sabrinasadiafaria/LoRa-WiFi-Mesh-Infrastructure/Project idea.md

# Project Idea: Self-Healing LoRa Mesh for Search & Rescue

## 🌟 Overview
This project aims to build a robust, self-healing mesh communication system tailored for Search and Rescue (SAR) operations in environments with no cellular coverage. 

By leveraging **LoRa (Long Range) radio** on **ESP32 microcontrollers**, the system can maintain connectivity over long distances. It will integrate **GPS** for real-time tracking of SAR teams and victims, and aggregate all data to a centralized **Command Center**.

## 🏗️ Architecture

### 1. The Nodes (ESP32 + LoRa + GPS + OLED)
* **Microcontroller**: ESP32 provides processing power, WiFi/Bluetooth (if needed locally), and multiple hardware serials.
* **Communication**: LoRa modules (e.g., SX1276/SX1278) enable long-range, low-bandwidth communication.
* **Location**: GPS modules (e.g., Neo-6M) provide real-time location tracking.
* **Display**: OLED screens (SSD1306) provide local feedback to operators (e.g., connection status, coordinates).

### 2. The Mesh Network
* **Self-Healing Topology**: If a node goes offline (due to battery failure or moving out of range), the network automatically reroutes data through other available nodes.
* **Multi-Hop**: Data can jump from Node A to Node C by passing through Node B, effectively extending the total range far beyond a single point-to-point link.

### 3. The Command Center (Gateway + Raspberry Pi)
* **Gateway Node**: An ESP32 connected to the command center's computer/Raspberry Pi acts as the bridge between the LoRa mesh and the local network.
* **Data Processing**: A Raspberry Pi processes incoming telemetry, alerts, and GPS coordinates.
* **Dashboard**: A local web interface visualizes the network topology and plots node locations on an offline map, giving commanders real-time situational awareness.

## 🎯 Key Goals
1. **Reliability**: Ensure message delivery even in harsh environments with dropped packets.
2. **Scalability**: Allow new nodes to seamlessly join the network on the fly.
3. **Low Power**: Optimize battery life for extended rescue operations.
4. **Usability**: Provide a clean, intuitive web interface for non-technical operators.
