sabrinasadiafaria/LoRa-WiFi-Mesh-Infrastructure/phase 8/Node C Forwarding.md

#include <SPI.h>
#include <LoRa.h>
#include <Wire.h>
#include <Adafruit_GFX.h>
#include <Adafruit_SSD1306.h>

#define SCREEN_WIDTH 128
#define SCREEN_HEIGHT 64

Adafruit_SSD1306 display(SCREEN_WIDTH, SCREEN_HEIGHT, &Wire, -1);

// Hardware SPI Pins for Arduino Uno / Nano (ATmega328P)
// Fixed Hardware SPI: SCK = Pin 13, MISO = Pin 12, MOSI = Pin 11
#define LORA_SS    10  // CS Pin
#define LORA_RST   9   // Reset Pin
#define LORA_DIO0  2   // Interrupt Pin

#define LORA_FREQ 433E6

// Node Configuration
const String MY_NODE_ID = "NODE_C";
const int ROUTE_BROADCAST_INTERVAL = 5000;
const int ROUTE_TIMEOUT = 15000;
const int MAX_ROUTES = 5; // Optimized for ATmega328P 2KB RAM
const int MAX_HOPS = 5;

struct RouteEntry {
  String destNode;
  String nextHop;
  int hops;
  int rssi;
  unsigned long lastUpdated;
  bool valid;
};

RouteEntry routingTable[MAX_ROUTES];
int routeCount = 0;
unsigned long lastBroadcastTime = 4000; // Offset start by 4s to avoid collision
unsigned long lastSendTime = 0;
int msgIdCounter = 200;

void updateOrAddRoute(String dest, String nextHop, int hops, int rssi) {
  if (dest == MY_NODE_ID) return;
  unsigned long now = millis();

  for (int i = 0; i < routeCount; i++) {
    if (routingTable[i].destNode == dest) {
      if (nextHop == routingTable[i].nextHop || hops < routingTable[i].hops || !routingTable[i].valid) {
        routingTable[i].nextHop = nextHop;
        routingTable[i].hops = hops;
        routingTable[i].rssi = rssi;
        routingTable[i].lastUpdated = now;
        routingTable[i].valid = true;
      }
      return;
    }
  }

  if (routeCount < MAX_ROUTES) {
    routingTable[routeCount].destNode = dest;
    routingTable[routeCount].nextHop = nextHop;
    routingTable[routeCount].hops = hops;
    routingTable[routeCount].rssi = rssi;
    routingTable[routeCount].lastUpdated = now;
    routingTable[routeCount].valid = true;
    routeCount++;
    Serial.println(F(">>> NEW ROUTE DISCOVERED"));
  }
}

String getNextHop(String dest) {
  for (int i = 0; i < routeCount; i++) {
    if (routingTable[i].destNode == dest && routingTable[i].valid) {
      return routingTable[i].nextHop;
    }
  }
  return "";
}

void updateOLED(String statusLine, String lastRx) {
  display.clearDisplay();
  display.setTextColor(SSD1306_WHITE);
  display.setTextSize(1);

  display.setCursor(0, 0);
  display.println(F("NODE C (Uno/Nano)"));

  display.setCursor(0, 16);
  display.print(F("Status: "));
  display.println(statusLine);

  display.setCursor(0, 32);
  display.print(F("Last RX/Fwd: "));
  display.println(lastRx);

  display.display();
}

void broadcastRoutes() {
  String packetStr = "RT:" + MY_NODE_ID + ":";
  for (int i = 0; i < routeCount; i++) {
    if (routingTable[i].valid && routingTable[i].destNode != MY_NODE_ID) {
      packetStr += routingTable[i].destNode + "," + String(routingTable[i].hops) + ";";
    }
  }
  LoRa.beginPacket();
  LoRa.print(packetStr);
  LoRa.endPacket();
}

void forwardPacket(String src, String dest, int hops, int msgId, String payload) {
  if (hops >= MAX_HOPS) {
    Serial.println(F("Drop: MAX HOPS"));
    return;
  }

  String nextHop = getNextHop(dest);
  if (nextHop == "") {
    Serial.println(F("Drop: No Route"));
    return;
  }

  String fwdPacket = "DATA:" + src + ":" + dest + ":" + String(hops + 1) + ":" + String(msgId) + ":" + payload;

  delay(100);
  LoRa.beginPacket();
  LoRa.print(fwdPacket);
  LoRa.endPacket();

  Serial.println(F(">>> FORWARDED packet"));
  updateOLED("FWD " + src + "->" + dest, "ID#" + String(msgId));
}

void setup() {
  Serial.begin(115200);

  // Hardware I2C on Arduino Uno/Nano: SDA = Pin A4, SCL = Pin A5
  Wire.begin();
  display.begin(SSD1306_SWITCHCAPVCC, 0x3C);

  // Hardware SPI on Arduino Uno/Nano: SCK=13, MISO=12, MOSI=11
  SPI.begin();
  LoRa.setPins(LORA_SS, LORA_RST, LORA_DIO0);

  if (!LoRa.begin(LORA_FREQ)) {
    Serial.println(F("LoRa init failed!"));
    while (1);
  }

  Serial.println(F("Node C - Arduino Uno/Nano Multi-Hop Ready"));
  updateOLED("Ready", "None");
}

void loop() {
  // 1. Receive & Process incoming packets
  int packetSize = LoRa.parsePacket();
  if (packetSize) {
    String incoming = "";
    while (LoRa.available()) {
      incoming += (char)LoRa.read();
    }
    int rssi = LoRa.packetRssi();

    if (incoming.startsWith("RT:")) {
      int firstColon = incoming.indexOf(':');
      int secondColon = incoming.indexOf(':', firstColon + 1);
      if (firstColon != -1 && secondColon != -1) {
        String senderId = incoming.substring(firstColon + 1, secondColon);
        String routesPayload = incoming.substring(secondColon + 1);

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

      if (p5 != -1) {
        String src = incoming.substring(p1 + 1, p2);
        String dest = incoming.substring(p2 + 1, p3);
        int hops = incoming.substring(p3 + 1, p4).toInt();
        int msgId = incoming.substring(p4 + 1, p5).toInt();
        String payload = incoming.substring(p5 + 1);

        if (dest == MY_NODE_ID) {
          Serial.println(F(">>> RECEIVED FINAL DATA!"));
          updateOLED("RX Final", src + ": " + payload);
        } else {
          forwardPacket(src, dest, hops, msgId, payload);
        }
      }
    }
  }

  // 2. Broadcast routes periodically
  if (millis() - lastBroadcastTime > ROUTE_BROADCAST_INTERVAL) {
    broadcastRoutes();
    lastBroadcastTime = millis();
  }
}
