sabrinasadiafaria/LoRa-WiFi-Mesh-Infrastructure/development/phase 9/Node A.md

// ===========================================================================
//  PHASE 9 (FINAL)  -  INTEGRATION BUILD FOR DEMO DAY  -  NODE A
//  ESP32 + LoRa SX1278 (433 MHz) + 1.3" SH1106 OLED + NEO-6M GPS + Wi-Fi portal
//
//  Complete standalone sketch - paste the whole file into the Arduino IDE.
//
//  Libraries: LoRa (Sandeep Mistry), U8g2 (oliver kraus)
//  Board:     ESP32 Dev Module
//
//  This is the same sketch as phase 8, retitled as the canonical
//  demo-day build. Everything that earlier phases added lives in this
//  one file: phase 1 shared core, phase 3 edge-triggered SOS, phase 4
//  portal + rescue reports, phase 5 unified self-healing routing,
//  phase 6 reliability fixes (heap/CRC/loop-time guards), phase 7
//  range + GPS, phase 8 ROVER: relay.
//
//  Earlier phase folders are still there for diffs and rollback; this
//  file is what you flash on demo day.
//
//  WHY THIS PHASE EXISTS - nodes would not link up outdoors, and the GPS
//  looked dead. Two real bugs were behind it:
//
//  1. SPREADING FACTOR WAS TUNED FOR A DESK, NOT A FIELD.
//     SF7 was chosen back in Phase 3 from bench measurements taken with the
//     nodes ~2 m apart (RSSI -62..-71 dBm). SF7 has the WORST sensitivity of
//     the usable settings: -123 dBm. Outdoors at distance that margin is
//     gone. Now SF9 (-129 dBm) - 6 dB better, roughly DOUBLE the range.
//
//  2. THE AIRTIME WAIT WAS A HARDCODED CONSTANT (a latent bug).
//     After endPacket(true) the sketch waited a fixed 420 ms before handing
//     the radio back to parsePacket(). That was sized for SF7, whose biggest
//     frame is ~318 ms. At SF9 a full frame needs ~1005 ms - so the wait
//     would have expired MID-TRANSMISSION and parsePacket() would have
//     yanked the radio out of TX, corrupting every large packet. Airtime is
//     now COMPUTED per frame from its length and LORA_SF (loraAirtimeMs),
//     so the spreading factor can be changed freely without breaking TX.
//
//  3. GPS SERIAL BUFFER TOO SMALL.
//     Serial2's default RX buffer is 256 bytes. A NEO-M8N with several
//     constellations emits more than that per second in bursts; when loop()
//     was briefly busy (an SF9 transmit is ~370 ms) the buffer overran and
//     NMEA sentences arrived truncated - looking exactly like a dead GPS.
//     Now 1 KB, set before Serial2.begin().
//
//  Beacon rates were slowed to pay for SF9's longer airtime (HB 15 s,
//  RT 30 s, GPS 45 s) with timeouts scaled to match, keeping the channel
//  around 18% busy with four nodes.
//
//  ALSO IN THIS PHASE
//    * Redesigned OLED - 5 organised pages, including a LINKS page showing
//      signal strength per peer, which is the page to watch during a range
//      test. Every page is marked n/5.
//    * Redesigned captive portal - modern responsive UI, live peer table with
//      signal bars, position card with source badges, toast notifications,
//      collapsible diagnostics. Polls /api/status every 4 s.
//
//  TUNING FOR YOUR SITE
//    Indoors / short range, want speed:   LORA_SF 7
//    Mixed indoor+outdoor (default):      LORA_SF 9
//    Maximum range, slow:                 LORA_SF 10 or 11
//    Change it in ALL THREE sketches - nodes on different SFs cannot hear
//    each other at all. Airtime and the watchdogs adapt automatically.
//
//  SOS button: momentary switch GPIO 4 to GND. tap = raise (or dismiss a
//  received alert), hold >1.5 s = dismiss.
//
//  Serial:  n r g s  a|b|c  t p  S C  1-4 reports  5-8 status
//           v = toggle rx log   N = raw NMEA dump   R = rescan   h = help
//
//  (phase 8 rover support - relaying ROVER: telemetry - is part of the
//  base forwarding logic now, not an "addition".)
// ===========================================================================

#include <SPI.h>
#include <LoRa.h>
#include <Wire.h>
#include <U8g2lib.h>
#include <WiFi.h>
#include <WebServer.h>
#include <DNSServer.h>
#include <esp_task_wdt.h>
#include <esp_system.h>

U8G2_SH1106_128X64_NONAME_F_HW_I2C display(U8G2_R0, U8X8_PIN_NONE);

// ------------------------------- identity ---------------------------------
#define MY_ID          "A"
#define FW_VERSION      8
#define PROTO_VERSION   1

// --------------------------------- pins -----------------------------------
#define LORA_SCK       18
#define LORA_MISO      19
#define LORA_MOSI      23
#define LORA_SS         5
#define LORA_RST       14
#define LORA_DIO0      26

#define I2C_SDA        21
#define I2C_SCL        22

#define PIN_SOS_BUTTON  4    // external push button to GND (used from Phase 3)
#define PIN_ENTROPY    34    // ADC1, input-only, floats -> good random seed

#define GPS_RX_PIN     16    // ESP32 RX2  <- GPS TX
#define GPS_TX_PIN     17    // ESP32 TX2  -> GPS RX
#define GPS_BAUD     9600

// ------------------------------- LoRa PHY ---------------------------------
// NOTE: the stock LoRa library leaves CRC OFF and uses the public sync word
// 0x12, so any other SX127x nearby collides with us. Both are fixed here.
#define LORA_FREQ      433E6
#define LORA_SF        7        // BACK TO THE KNOWN-GOOD VALUE.
                                // SF7 is what phases 3-6 ran, and those linked up
                                // reliably. Phase 7 raised it to 9 for range and
                                // then 8; both times the mesh got WORSE, so the
                                // spreading factor goes back to the setting with
                                // hardware evidence behind it and stays there until
                                // the mesh is provably stable again.
                                // Raise it ONLY one step at a time, and ONLY after
                                // changing it in all three sketches AND in
                                // pi/sx1278.py - see the RADIO PHY box printed at
                                // boot. Nodes on different spreading factors are
                                // COMPLETELY deaf to each other, which looks
                                // exactly like "nothing connects to anything".
#define LORA_BW        125000L
#define LORA_CR        5
#define LORA_TXPOWER   17
#define LORA_SYNCWORD  0x2A
#define LORA_PREAMBLE  8

// ---------------------------- power / heat --------------------------------
// An ESP32 running a SoftAP continuously at 240 MHz, with a LoRa module, an
// OLED and a GPS hanging off its 3V3 pin, is a small heater - and a hot board
// browns out mid-transmit, which looks exactly like "the nodes keep losing
// each other". Both knobs below cut current with no effect on LoRa range:
//   - 80 MHz is the lowest clock the Wi-Fi stack supports and is still far
//     more CPU than this sketch needs (maxloop stays single-digit ms).
//   - the phone is a metre away; 11 dBm of Wi-Fi is plenty, and the AP is a
//     bigger share of the average current than the LoRa radio ever is.
// LORA_TXPOWER is deliberately NOT reduced - that is the range budget.
#define CPU_MHZ        240             // STOCK. Dropping this to 80 is a real heat
                                       // fix, but change ONE thing at a time: get
                                       // the mesh linking at 240 first, then try 80
                                       // and confirm the links survive.
#define WIFI_TX_DBM     WIFI_POWER_11dBm

// ------------------------------ Wi-Fi portal ------------------------------
#define ENABLE_PORTAL   1              // set 0 to make this a LoRa-only relay
#define AP_SSID        "SOS_Node_A"
#define AP_PASSWORD    NULL            // NULL = open network (captive portal)
#define AP_CHANNEL      1
#define AP_MAX_CLIENTS  4

// ------------------------------ location ----------------------------------
// A phone fix is preferred while it is fresh; the GPS module is the fallback.
// Set LOCATION_PREFER_PHONE to 0 to reverse that.
#define LOCATION_PREFER_PHONE   1
#define GPS_FRESH_MS        30000UL    // module fix counts as "live" this long
#define PHONE_FRESH_MS     300000UL    // phone fix counts as "live" this long

#define LOC_NONE   0
#define LOC_GPS    1
#define LOC_PHONE  2

// -------------------------------- timing ----------------------------------
#define HB_INTERVAL_MS       15000UL   // slower: SF9 packets are ~3x longer on air
#define HB_JITTER_MS          3000UL
#define GPS_INTERVAL_MS      45000UL
#define GPS_JITTER_MS         4000UL
#define RT_INTERVAL_MS       30000UL   // routing advertisement period
#define RT_JITTER_MS          4000UL
#define ROUTE_TIMEOUT_MS    120000UL   // ~4 missed adverts -> route invalid
#define NEIGHBOR_TIMEOUT_MS  75000UL   // ~5 missed heartbeats at the slower rate
#define AUTO_DATA_MS         15000UL   // repeat-send period when t is toggled on
#define OLED_REFRESH_MS       1000UL   // redraw is skipped when nothing changed
#define UI_PAGE_MS            4000UL   // how long each OLED page is shown
// FAST RECONNECT, NOW BOUNDED.  When a known neighbour goes missing we beacon
// faster so we find each other again. Until now that was UNBOUNDED: once a
// node had ever lost a peer it beaconed every 6 s forever. At SF7 that was
// ~2 % of the channel and harmless; at SF9 it is ~5.5 % PER NODE for
// heartbeats alone, and it is self-reinforcing - lose a peer, beacon faster,
// collide more, lose more peers, beacon faster still. Three nodes plus the Pi
// saturate the channel and the mesh can never re-form. That is the bug behind
// "both nodes are lost and cannot reach the Pi". The burst is now limited to
// RECONNECT_WINDOW_MS, after which we fall back to the normal rate - a
// returning node announces itself with bootBeacons anyway.
#define RECONNECT_HB_MS       6000UL   // fast beacon while a neighbour is missing
#define RECONNECT_WINDOW_MS  90000UL   // ...but only for this long after the loss

// DUTY-CYCLE GOVERNOR. A hard ceiling on how much of each minute this node may
// spend transmitting ROUTINE beacons. Steady state at SF8 is ~2 %, so it never
// bites in normal operation - it exists so that no future timing change (or a
// lost-peer storm like the one above) can congest the channel again. SOS,
// DATA, ACK and CMD traffic is NEVER governed.
#define DUTY_WINDOW_MS       60000UL
#define DUTY_BUDGET_PERMIL      100    // 10 % of the window
#define I2C_HZ              100000L   // standard rate - see the I2C section below
#define I2C_TIMEOUT_MS           50   // MUST be set or a glitching OLED can hang loop() forever
#define STAT_LOG_MS          30000UL
#define TX_MIN_GAP_MS          150UL   // the airtime wait above already spaces us out
#define TX_GAP_JITTER_MS       250UL
#define TX_AIRTIME_MARGIN_MS    80UL   // safety added to the COMPUTED airtime
#define RADIO_RETRY_MS        5000UL

// --------------------------------- sizes ----------------------------------
#define MAX_NEIGHBORS      8
#define MAX_ROUTES         8
#define MAX_HOPS           4           // also the initial TTL of a DATA packet

// -------------------------- SOS / reports --------------------------------
#define SOS_BURST_COUNT       3        // an SOS is sent this many times
#define SOS_BURST_GAP_MS   1200UL      // spacing between the copies (non-blocking)
#define SOS_SCREEN_MS     60000UL      // full-screen alert clears itself after this
#define SOS_BUTTON_HOLD_MS 1500UL      // hold the button this long to clear an alert
#define SOS_DEBOUNCE_MS      50UL
#define MAX_PACKET_LEN   200
#define MAX_PAYLOAD_LEN  160
#define SEEN_CACHE_SIZE   32
#define TX_QUEUE_DEPTH     6
#define NMEA_BUF_LEN     100
#define UI_PAGES           5
#define WDT_TIMEOUT_S     30       // transmits are bounded now, so this can be tight again
#define SERIAL_BAUD   115200

// ===========================================================================
//  NON-BLOCKING TIMER  (replaces every delay() in loop)
//
//  The phase 10/11 sketches staggered their first transmit like this:
//      lastBroadcastTime = millis() + random(0, 2000);          // BUG
//      if (millis() - lastBroadcastTime > interval) { ... }
//  Putting the timestamp in the FUTURE makes (millis() - last) underflow to a
//  huge unsigned value on the first pass, so the guard is immediately true and
//  the node transmits at once - the stagger never happened. begin() below gets
//  the same effect correctly, by moving the timestamp into the PAST.
// ===========================================================================
struct Interval {
  uint32_t last;
  uint32_t period;

  void begin(uint32_t periodMs, uint32_t firstDelayMs) {
    period = periodMs;
    uint32_t back = (periodMs > firstDelayMs) ? (periodMs - firstDelayMs) : 0;
    last = millis() - back;               // always the past, never the future
  }
  bool due() {
    uint32_t now = millis();
    if (now - last >= period) { last = now; return true; }
    return false;
  }
  void setPeriod(uint32_t p) { period = p; }
};

Interval hbTimer, gpsTimer, rtTimer, autoTimer;
Interval uiTimer, pageTimer, statTimer, retryTimer;

// ===========================================================================
//  PACKET FRAMING     v<VER>|<TYPE>|<SRC>|<DEST>|<MSGID>|<TTL>|<PAYLOAD>|<CHK>
//
//  All char buffers - no String anywhere in the receive/parse path, so the
//  ESP32 heap stays flat over a long run.
// ===========================================================================
struct Packet {
  uint8_t  ver;
  char     type[8];
  char     src[4];
  char     dest[4];
  uint16_t msgId;
  uint8_t  ttl;
  char     payload[MAX_PAYLOAD_LEN];
  int      rssi;
  float    snr;
};

uint8_t pktChecksum(const char *s, size_t n) {
  uint8_t c = 0;
  for (size_t i = 0; i < n; i++) c ^= (uint8_t)s[i];
  return c;
}

// '|' is the field separator, so it must never appear inside a field.
void pktSanitize(char *s) {
  for (char *p = s; *p; ++p)
    if (*p == '|' || *p == '\\' || *p == '\r' || *p == '\n') *p = '/';
}

// Build a frame. Returns length written, or 0 if it would not fit.
size_t pktBuild(char *out, size_t outSize,
                const char *type, const char *src, const char *dest,
                uint16_t msgId, uint8_t ttl, const char *payload) {
  int n = snprintf(out, outSize, "v%u|%s|%s|%s|%u|%u|%s",
                   (unsigned)PROTO_VERSION, type, src, dest,
                   (unsigned)msgId, (unsigned)ttl, payload ? payload : "");
  if (n < 0 || (size_t)n + 4 > outSize) return 0;
  uint8_t chk = pktChecksum(out, (size_t)n);
  int m = snprintf(out + n, outSize - (size_t)n, "|%02x", chk);
  if (m < 0) return 0;
  return (size_t)(n + m);
}

// Parse a frame IN PLACE. False if malformed, wrong version, or bad checksum.
bool pktParse(char *in, Packet &p) {
  size_t len = strlen(in);
  if (len < 12 || len >= MAX_PACKET_LEN) return false;

  char *lastBar = strrchr(in, '|');
  if (!lastBar) return false;
  if (strlen(lastBar + 1) != 2) return false;

  uint8_t want = (uint8_t)strtoul(lastBar + 1, NULL, 16);
  *lastBar = '\0';
  if (pktChecksum(in, strlen(in)) != want) return false;

  // Split on the first 6 pipes; field 7 keeps the rest, so a stray separator
  // inside a payload cannot shift the other fields.
  char *f[7];
  int nf = 0;
  f[nf++] = in;
  for (char *q = in; *q && nf < 7; ++q) {
    if (*q == '|') { *q = '\0'; f[nf++] = q + 1; }
  }
  if (nf != 7) return false;
  if (f[0][0] != 'v') return false;

  p.ver = (uint8_t)atoi(f[0] + 1);
  if (p.ver != PROTO_VERSION) return false;

  strncpy(p.type, f[1], sizeof(p.type) - 1); p.type[sizeof(p.type) - 1] = '\0';
  strncpy(p.src,  f[2], sizeof(p.src)  - 1); p.src[sizeof(p.src)   - 1] = '\0';
  strncpy(p.dest, f[3], sizeof(p.dest) - 1); p.dest[sizeof(p.dest) - 1] = '\0';
  p.msgId = (uint16_t)strtoul(f[4], NULL, 10);
  p.ttl   = (uint8_t) strtoul(f[5], NULL, 10);
  strncpy(p.payload, f[6], sizeof(p.payload) - 1);
  p.payload[sizeof(p.payload) - 1] = '\0';

  if (!p.type[0] || !p.src[0] || !p.dest[0]) return false;
  return true;
}

// ===========================================================================
//  DUPLICATE SUPPRESSION
// ===========================================================================
uint32_t seenKeys[SEEN_CACHE_SIZE];
uint8_t  seenIdx = 0;

uint32_t seenKey(const char *src, uint16_t msgId) {
  uint32_t h = 2166136261UL;                       // FNV-1a over the node id
  for (const char *p = src; *p; ++p) { h ^= (uint8_t)*p; h *= 16777619UL; }
  uint32_t k = (h << 16) ^ msgId;
  return k ? k : 1;
}

bool seenOrAdd(const char *src, uint16_t msgId) {
  uint32_t k = seenKey(src, msgId);
  for (uint8_t i = 0; i < SEEN_CACHE_SIZE; i++) if (seenKeys[i] == k) return true;
  seenKeys[seenIdx] = k;
  seenIdx = (uint8_t)((seenIdx + 1) % SEEN_CACHE_SIZE);
  return false;
}

// ===========================================================================
//  NEIGHBOUR TABLE   (now also stores each peer's reported position)
// ===========================================================================
struct Neighbor {
  char     id[4];
  int      rssi;
  float    snr;
  uint32_t lastSeen;
  uint32_t uptime;
  uint32_t heap;
  double   lat, lon;
  uint8_t  locSrc;      // LOC_NONE / LOC_GPS / LOC_PHONE
  bool     hasLoc;
  bool     used;
  bool     active;
};

Neighbor neighbors[MAX_NEIGHBORS];

#define NB_UPDATED      0
#define NB_NEW          1
#define NB_RECONNECTED  2
#define NB_FULL        -1

void neighborInit() {
  for (uint8_t i = 0; i < MAX_NEIGHBORS; i++) {
    neighbors[i].used = false;
    neighbors[i].active = false;
    neighbors[i].hasLoc = false;
    neighbors[i].locSrc = LOC_NONE;
    neighbors[i].id[0] = '\0';
  }
}

int neighborIndex(const char *id) {
  for (uint8_t i = 0; i < MAX_NEIGHBORS; i++)
    if (neighbors[i].used && strcmp(neighbors[i].id, id) == 0) return (int)i;
  return -1;
}

// Any packet from a peer proves it is alive. Returns NB_NEW / NB_RECONNECTED /
// NB_UPDATED / NB_FULL.
int neighborSeen(const char *id, int rssi, float snr) {
  if (!id || !*id) return NB_UPDATED;
  uint32_t now = millis();

  int i = neighborIndex(id);
  if (i >= 0) {
    bool wasActive = neighbors[i].active;
    neighbors[i].rssi = rssi;
    neighbors[i].snr  = snr;
    neighbors[i].lastSeen = now;
    neighbors[i].active = true;
    return wasActive ? NB_UPDATED : NB_RECONNECTED;
  }
  for (uint8_t k = 0; k < MAX_NEIGHBORS; k++) {
    if (!neighbors[k].used) {
      strncpy(neighbors[k].id, id, sizeof(neighbors[k].id) - 1);
      neighbors[k].id[sizeof(neighbors[k].id) - 1] = '\0';
      neighbors[k].rssi = rssi;
      neighbors[k].snr  = snr;
      neighbors[k].lastSeen = now;
      neighbors[k].uptime = 0;
      neighbors[k].heap = 0;
      neighbors[k].hasLoc = false;
      neighbors[k].locSrc = LOC_NONE;
      neighbors[k].used = true;
      neighbors[k].active = true;
      return NB_NEW;
    }
  }
  return NB_FULL;
}

void neighborSetStats(const char *id, uint32_t uptime, uint32_t heap) {
  int i = neighborIndex(id);
  if (i < 0) return;
  neighbors[i].uptime = uptime;
  neighbors[i].heap = heap;
}

void neighborSetLoc(const char *id, double lat, double lon, uint8_t src) {
  int i = neighborIndex(id);
  if (i < 0) return;
  neighbors[i].lat = lat;
  neighbors[i].lon = lon;
  neighbors[i].locSrc = src;
  neighbors[i].hasLoc = (src != LOC_NONE);
}

// Marks ONE stale neighbour inactive per call. Drain it with a while() loop.
bool neighborPrune(char *lostId, size_t n) {
  uint32_t now = millis();
  for (uint8_t i = 0; i < MAX_NEIGHBORS; i++) {
    if (neighbors[i].used && neighbors[i].active &&
        (now - neighbors[i].lastSeen > NEIGHBOR_TIMEOUT_MS)) {
      neighbors[i].active = false;
      if (lostId && n) {
        strncpy(lostId, neighbors[i].id, n - 1);
        lostId[n - 1] = '\0';
      }
      return true;
    }
  }
  return false;
}

uint8_t neighborActiveCount() {
  uint8_t c = 0;
  for (uint8_t i = 0; i < MAX_NEIGHBORS; i++)
    if (neighbors[i].used && neighbors[i].active) c++;
  return c;
}

// Comma separated list of active neighbours, e.g. "B,C" - or "none".
void neighborActiveList(char *out, size_t n) {
  if (!out || n == 0) return;
  out[0] = '\0';
  size_t used = 0;
  for (uint8_t i = 0; i < MAX_NEIGHBORS; i++) {
    if (!neighbors[i].used || !neighbors[i].active) continue;
    size_t idLen = strlen(neighbors[i].id);
    if (used + idLen + (used ? 1 : 0) + 1 >= n) break;
    if (used) out[used++] = ',';
    memcpy(out + used, neighbors[i].id, idLen);
    used += idLen;
    out[used] = '\0';
  }
  if (used == 0) { strncpy(out, "none", n - 1); out[n - 1] = '\0'; }
}

// Is any node we have met since boot currently missing?  While that is true
// we beacon faster (RECONNECT_HB_MS) so the missing node - and we - are
// rediscovered in seconds rather than on the next slow heartbeat.
bool anyNeighborMissing() {
  for (uint8_t i = 0; i < MAX_NEIGHBORS; i++)
    if (neighbors[i].used && !neighbors[i].active) return true;
  return false;
}

// Drop every cached (src,msgId) belonging to one node. Called when a node
// comes back, because a node that rebooted restarts its msgId at 1 and would
// otherwise collide with its own pre-reboot ids still sitting in the ring.
void seenForget(const char *src) {
  for (uint8_t i = 0; i < SEEN_CACHE_SIZE; i++) {
    if (!seenKeys[i]) continue;
    for (uint16_t m = 1; m <= 128; m++) {
      if (seenKeys[i] == seenKey(src, m)) { seenKeys[i] = 0; break; }
    }
  }
}

// ===========================================================================
//  ROUTING TABLE  -  distance vector with split horizon
//
//  Each node keeps ONE entry per destination: who to hand the packet to
//  (nextHop) and how many hops away it is. Entries are learned two ways:
//
//    1. any packet heard directly from X  ->  X is reachable in 1 hop via X
//    2. an RT advertisement from S saying "I can reach D in h hops via V"
//       ->  D is reachable in h+1 hops via S
//
//  SPLIT HORIZON is the reason the advert carries V (the advertiser's own
//  next hop). If V is us, that route only exists because of us, and taking
//  it back would create a loop whose hop count climbs forever - the classic
//  count-to-infinity. The old phase 7-9 code claimed split horizon in its
//  comments but never actually implemented it; it only bounded the damage
//  with MAX_HOPS and a timeout. Here the entry is genuinely discarded.
//
//  A route that stops being advertised goes invalid after ROUTE_TIMEOUT_MS.
//  That is the self-healing trigger: traffic through a dead relay stops
//  immediately rather than disappearing into a black hole, and the route
//  recovers by itself when the relay comes back.
// ===========================================================================
struct Route {
  char     dest[4];
  char     nextHop[4];
  uint8_t  hops;
  int      rssi;
  uint32_t lastUpdated;
  bool     used;
  bool     valid;
};

Route routes[MAX_ROUTES];

#define RT_NONE       0
#define RT_NEW        1
#define RT_RECOVERED  2
#define RT_BETTER     3
#define RT_FULL      -1

void routeInit() {
  for (uint8_t i = 0; i < MAX_ROUTES; i++) {
    routes[i].used = false;
    routes[i].valid = false;
    routes[i].dest[0] = '\0';
    routes[i].nextHop[0] = '\0';
  }
}

int routeIndex(const char *dest) {
  for (uint8_t i = 0; i < MAX_ROUTES; i++)
    if (routes[i].used && strcmp(routes[i].dest, dest) == 0) return (int)i;
  return -1;
}

// Accept an advertised path. Returns RT_NEW / RT_RECOVERED / RT_BETTER /
// RT_NONE / RT_FULL so the caller can log the interesting transitions.
int routeUpdate(const char *dest, const char *via, uint8_t hops, int rssi) {
  if (!dest || !*dest || !via || !*via) return RT_NONE;
  if (strcmp(dest, MY_ID) == 0) return RT_NONE;      // never route to self
  if (hops == 0 || hops > MAX_HOPS) return RT_NONE;  // bounds count-to-infinity

  uint32_t now = millis();
  int i = routeIndex(dest);

  if (i >= 0) {
    bool wasValid = routes[i].valid;
    bool sameHop  = (strcmp(routes[i].nextHop, via) == 0);

    // Take the update if it comes from the hop we already use (so a path is
    // allowed to legitimately get longer), or if it is strictly shorter, or
    // if we had given up on this destination entirely.
    if (sameHop || hops < routes[i].hops || !wasValid) {
      strncpy(routes[i].nextHop, via, sizeof(routes[i].nextHop) - 1);
      routes[i].nextHop[sizeof(routes[i].nextHop) - 1] = '\0';
      routes[i].hops = hops;
      routes[i].rssi = rssi;
      routes[i].lastUpdated = now;
      routes[i].valid = true;
      if (!wasValid) return RT_RECOVERED;
      if (!sameHop)  return RT_BETTER;
    }
    return RT_NONE;
  }

  for (uint8_t k = 0; k < MAX_ROUTES; k++) {
    if (!routes[k].used) {
      strncpy(routes[k].dest, dest, sizeof(routes[k].dest) - 1);
      routes[k].dest[sizeof(routes[k].dest) - 1] = '\0';
      strncpy(routes[k].nextHop, via, sizeof(routes[k].nextHop) - 1);
      routes[k].nextHop[sizeof(routes[k].nextHop) - 1] = '\0';
      routes[k].hops = hops;
      routes[k].rssi = rssi;
      routes[k].lastUpdated = now;
      routes[k].used = true;
      routes[k].valid = true;
      return RT_NEW;
    }
  }
  return RT_FULL;
}

// Invalidates ONE stale route per call and reports it. Drain with a while().
bool routeExpire(char *lostDest, size_t n) {
  uint32_t now = millis();
  for (uint8_t i = 0; i < MAX_ROUTES; i++) {
    if (routes[i].used && routes[i].valid &&
        (now - routes[i].lastUpdated > ROUTE_TIMEOUT_MS)) {
      routes[i].valid = false;
      if (lostDest && n) {
        strncpy(lostDest, routes[i].dest, n - 1);
        lostDest[n - 1] = '\0';
      }
      return true;
    }
  }
  return false;
}

// Who do we hand a packet for `dest` to? NULL means we have no way there.
const char *routeBestHop(const char *dest) {
  int i = routeIndex(dest);
  if (i < 0 || !routes[i].valid) return NULL;
  return routes[i].nextHop;
}

uint8_t routeValidCount() {
  uint8_t c = 0;
  for (uint8_t i = 0; i < MAX_ROUTES; i++)
    if (routes[i].used && routes[i].valid) c++;
  return c;
}

// Split one advertised "dest,hops,via" triple.
bool routeParseEntry(char *tok, char *d, size_t dn, unsigned *h, char *v, size_t vn) {
  char *c1 = strchr(tok, ',');
  if (!c1) return false;
  *c1 = '\0';
  char *c2 = strchr(c1 + 1, ',');
  if (!c2) return false;
  *c2 = '\0';
  strncpy(d, tok, dn - 1);      d[dn - 1] = '\0';
  strncpy(v, c2 + 1, vn - 1);   v[vn - 1] = '\0';
  *h = (unsigned)strtoul(c1 + 1, NULL, 10);
  return d[0] && v[0];
}

// ===========================================================================
//  RADIO LAYER
//  All transmits go through one queue with a minimum gap + jitter, so a burst
//  never blocks the loop or stomps on itself.
// ===========================================================================
bool     radioOk = false;
char     txQueue[TX_QUEUE_DEPTH][MAX_PACKET_LEN];
uint8_t  txHead = 0, txTail = 0, txCount = 0;
uint32_t txLast = 0;
uint32_t txGap  = TX_MIN_GAP_MS;
bool     txInFlight = false;      // a transmission is on air right now
uint32_t txStart = 0;             // when it started, for the timeout
uint32_t txAirtimeMs = 500;       // computed per frame by loraAirtimeMs()
uint16_t msgIdCounter = 0;

uint32_t statTx = 0, statRx = 0, statBad = 0, statDrop = 0;
uint32_t statWedge = 0;       // number of times the radio was force-reinitialised
uint32_t statFwd = 0, statDataTx = 0, statDataRx = 0;
uint32_t statTxStuck = 0;         // transmits that never reported TX_DONE

// last application message delivered to this node (shown on the OLED/portal)
char     lastMsgFrom[4] = "";
char     lastMsgText[40] = "";
uint32_t lastMsgTime = 0;

// repeat-send test state, driven by the a/b/c and t serial commands
bool     autoData = false;
char     autoTarget[4] = "";
uint8_t  uiPage = 0;

// A node that has just booted sends a few quick heartbeats so its peers
// rediscover it in seconds instead of waiting a whole HB_INTERVAL_MS.
uint8_t  bootBeacons = 4;

// When the first still-missing neighbour went missing (0 = everyone is here).
// Bounds the fast-reconnect beacon burst - see RECONNECT_WINDOW_MS.
uint32_t missingSinceMs = 0;

// RADIO HEALTH WATCHDOG.
// radioOk is set true once at boot and NEVER set false again at runtime, so
// if the SX1278 wedges internally - a state only a real hardware reset
// clears - nothing in software ever notices, and it stays "connected but
// silent" forever. The one signal that cannot lie: OUR OWN heartbeat is
// generated every HB_INTERVAL_MS regardless of whether anyone is nearby, so
// if it has not gone out in a long time the local radio - not the RF link -
// is broken. lastTxOkMs tracks the last successful transmit; if it goes
// stale, radioWatchdog() forces the same reinit a power cycle would do.
#define RADIO_WEDGE_MS      120000UL   // ~8 missed heartbeats at the slower rate
uint32_t lastTxOkMs = 0;

// Loop-time instrumentation. The radio only listens while parsePacket() has
// it armed, so a long loop pass = a deaf radio. maxloop on the stat line is
// the number to watch: if it climbs into the tens of ms, packets are lost.
uint32_t maxLoopMs = 0;
uint32_t loopStartMs = 0;

// Per-packet [rx] logging is ~10ms of blocked Serial each. Off by default;
// press v to toggle when you actually need the trace.
bool     verboseRx = false;

// RADIO TEST MODE (serial 'T'). Sends a plain non-protocol PING every 3 s.
// The receiver cannot parse it, so it lands in the [rx-raw] log above with its
// RSSI. That is the decisive test: if the other node prints [rx-raw] PING the
// radios hear each other and the fault is in the mesh logic; if it prints
// nothing at all, the PHY does not match or a radio/antenna is dead.
bool     radioTest = false;
uint32_t testLast  = 0;

// ===========================================================================
//  SOS / RESCUE-REPORT / TEAM-STATUS STATE  (Phase 4)
//
//  Fixes carried over from the audit of the old phase 11 SOS code:
//    * that code set sosAlertActive = true and NEVER cleared it, so the OLED
//      was stuck on the SOS screen forever. Here the screen clears itself
//      after SOS_SCREEN_MS, or immediately if the button is held.
//    * that code sent hardcoded coordinates. Here the SOS carries the node's
//      real position from locBest() - phone fix or GPS module, whichever the
//      hybrid location layer has.
//    * that code blocked ~1.5 s inside the 3x burst with delay(500). Here the
//      three copies are queued one SOS_BURST_GAP_MS apart with no blocking.
//    * that code re-fired continuously while the button was held. Here the
//      trigger is edge-detected.
// ===========================================================================

// ---- our own outgoing SOS -------------------------------------------------
bool     sosSending    = false;      // a burst is in progress
uint8_t  sosBurstLeft  = 0;          // copies still to queue
uint16_t sosBurstId    = 0;          // shared msgId for all copies of one SOS
char     sosBurstMsg[48] = "";
Interval sosBurstTimer;

// ---- alert currently shown on this node (ours or a received one) ---------
bool     sosAlert      = false;      // full-screen takeover active
char     sosVictim[4]  = "";
double   sosLat = 0, sosLon = 0;
char     sosText[48]   = "";
uint32_t sosAlertStart = 0;
char     sosAcks[16]   = "";         // comma list of nodes that ACKed our SOS

// ---- SOS button, edge detected -----------------------------------------
bool     btnPrev       = true;       // INPUT_PULLUP idles HIGH
uint32_t btnChangeTime = 0;
bool     btnHeldHandled = false;

// ---- last rescue report / team status heard from each node -------------
struct PeerReport {
  char     id[4];
  char     code[14];       // VICTIM_FOUND / MEDICAL / BLOCKED / DANGER
  char     status[14];     // AVAILABLE / SEARCHING / VICTIM_FOUND / NEED_ASSIST / EMERGENCY
  uint32_t reportTime;
  uint32_t statusTime;
  bool     used;
};
PeerReport peerRep[MAX_NEIGHBORS + 1];   // + 1 for our own row

// our own report / status, editable from the portal or serial
char myStatus[14] = "AVAILABLE";
char myTeam[8]    = "T1";

int peerRepIndex(const char *id) {
  for (uint8_t i = 0; i < MAX_NEIGHBORS + 1; i++)
    if (peerRep[i].used && strcmp(peerRep[i].id, id) == 0) return (int)i;
  for (uint8_t i = 0; i < MAX_NEIGHBORS + 1; i++)
    if (!peerRep[i].used) {
      strncpy(peerRep[i].id, id, sizeof(peerRep[i].id) - 1);
      peerRep[i].id[sizeof(peerRep[i].id) - 1] = '\0';
      peerRep[i].code[0] = '\0';
      peerRep[i].status[0] = '\0';
      peerRep[i].used = true;
      return (int)i;
    }
  return -1;
}

uint16_t nextMsgId() {
  if (++msgIdCounter == 0) msgIdCounter = 1;
  return msgIdCounter;
}

bool radioBegin() {
  SPI.begin(LORA_SCK, LORA_MISO, LORA_MOSI, LORA_SS);
  LoRa.setPins(LORA_SS, LORA_RST, LORA_DIO0);

  for (uint8_t attempt = 0; attempt < 3; attempt++) {
    if (LoRa.begin(LORA_FREQ)) {
      LoRa.setSpreadingFactor(LORA_SF);
      LoRa.setSignalBandwidth(LORA_BW);
      LoRa.setCodingRate4(LORA_CR);
      LoRa.setTxPower(LORA_TXPOWER);
      LoRa.setSyncWord(LORA_SYNCWORD);
      LoRa.setPreambleLength(LORA_PREAMBLE);
      LoRa.enableCrc();
      // no LoRa.receive() - parsePacket() arms RX (see radioService comment)
      radioOk = true;
      return true;
    }
    delay(200);                       // setup only - never inside loop()
  }
  radioOk = false;
  return false;
}

// How long will a frame of `len` bytes actually be on the air, in ms?
//
// This REPLACES the old fixed TX_AIRTIME_MS constant, which was a latent bug:
// it was tuned to 420 ms for SF7 (max frame ~318 ms). At SF9 the same frame
// takes ~1005 ms, so the fixed wait would have expired mid-transmission and
// parsePacket() would have yanked the radio out of TX - corrupting every
// large packet. Now the wait follows LORA_SF automatically, so the spreading
// factor can be changed for range without silently breaking transmission.
//
// Standard Semtech SX1276/78 time-on-air formula.
uint32_t loraAirtimeMs(uint16_t len) {
  const double tSym = (double)(1UL << LORA_SF) * 1000.0 / (double)LORA_BW;
  const uint8_t DE  = (tSym > 16.0) ? 1 : 0;   // low-data-rate optimise
  const uint8_t CR  = LORA_CR - 4;             // 1..4
  double tPre = ((double)LORA_PREAMBLE + 4.25) * tSym;

  long num = 8L * (long)len - 4L * LORA_SF + 28 + 16;   // explicit header -> no -20H
  long den = 4L * (LORA_SF - 2 * DE);
  long nPay = 8;
  if (num > 0) nPay += ((num + den - 1) / den) * (CR + 4);

  return (uint32_t)(tPre + (double)nPay * tSym + 0.5);
}

// ---------------------------------------------------------------------------
// DUTY-CYCLE GOVERNOR
// A rolling window of how many ms of airtime we have actually used.
// radioService() adds each completed transmission; the routine beacon senders
// ask permission before queueing. Returns false when this frame would push us
// over budget. Placed here because it needs loraAirtimeMs() above.
uint32_t dutyUsedMs   = 0;
uint32_t dutyWinStart = 0;
uint32_t statDuty     = 0;          // beacons skipped because the channel was busy

bool dutyAllows(uint16_t len) {
  uint32_t now = millis();
  if (now - dutyWinStart >= DUTY_WINDOW_MS) { dutyWinStart = now; dutyUsedMs = 0; }
  const uint32_t budgetMs = (DUTY_WINDOW_MS / 1000UL) * (uint32_t)DUTY_BUDGET_PERMIL;
  if (dutyUsedMs + loraAirtimeMs(len) <= budgetMs) return true;

  statDuty++;
  static uint32_t lastMoan = 0;     // one line per 30 s, not one per skip
  if (now - lastMoan > 30000UL) {
    lastMoan = now;
    Serial.printf("[duty] channel busy - %lu of %lu ms used this minute, "
                  "%lu beacons skipped so far\n",
                  (unsigned long)dutyUsedMs, (unsigned long)budgetMs,
                  (unsigned long)statDuty);
  }
  return false;
}

// Called every loop. If our own heartbeat has not gone out in RADIO_WEDGE_MS,
// force the exact reinit sequence radioBegin() does at boot - the same thing
// a power cycle achieves, without the power cycle.
void radioWatchdog() {
  if (!radioOk) return;                          // the boot-failure retry path handles this
  if (millis() - lastTxOkMs < RADIO_WEDGE_MS) return;

  statWedge++;
  Serial.printf("[radio] WEDGED - no successful TX in %lus, forcing reinit (#%lu)\n",
                (unsigned long)(RADIO_WEDGE_MS / 1000UL), (unsigned long)statWedge);
  radioOk = false;
  if (radioBegin()) {
    Serial.println("[radio] reinit OK");
    bootBeacons = 4;              // announce ourselves fast, like a real reboot would
    hbTimer.begin(3000UL, 0);
  } else {
    Serial.println("[radio] reinit FAILED - will keep retrying");
  }
  lastTxOkMs = millis();          // don't re-trigger before the reinit has a chance to prove itself
}

// Manual "search for nearby nodes" - the portal button and serial 'R' both
// call this. It does what the automatic watchdog does (reinit the radio, in
// case it is quietly wedged) PLUS announces us immediately instead of
// waiting for the next heartbeat, so a genuine "is anyone out there" check
// gets an answer in seconds rather than up to HB_INTERVAL_MS.
void manualRescan(const char *why) {
  Serial.printf("[radio] manual rescan requested (%s) - reinit + fast beacon\n", why);
  radioOk = false;
  radioBegin();
  bootBeacons = 4;
  hbTimer.begin(1000UL, 0);       // first beacon in ~1s, not the usual jittered wait
  rtTimer.begin(2000UL, 0);
  lastTxOkMs = millis();
}

bool radioEnqueue(const char *frame) {
  if (!frame || !*frame) return false;
  if (txCount >= TX_QUEUE_DEPTH) { statDrop++; return false; }
  strncpy(txQueue[txTail], frame, MAX_PACKET_LEN - 1);
  txQueue[txTail][MAX_PACKET_LEN - 1] = '\0';
  txTail = (uint8_t)((txTail + 1) % TX_QUEUE_DEPTH);
  txCount++;
  return true;
}

// Transmit is ASYNCHRONOUS and bounded, and RX mode is left to parsePacket().
//
// The half-duplex SX1278 has ONE state machine. The Sandeep Mistry library
// gives you two ways to run it and THEY MUST NOT BE MIXED:
//
//   A) poll parsePacket() forever   - parsePacket() re-arms RX_SINGLE itself
//   B) LoRa.receive() + onReceive()  - interrupt driven, RX_CONTINUOUS
//
// Earlier builds did both: LoRa.receive() after every transmit AND
// parsePacket() in the RX path. parsePacket() with no size argument, when it
// finds nothing, forces the radio to RX_SINGLE - so it kept yanking the radio
// out of the RX_CONTINUOUS that receive() had set, and after an async TX left
// a stale TX_DONE flag in the mix the radio would settle in STANDBY and go
// permanently deaf. That is the "SOS works but then every node loses every
// neighbour" bug.
//
// Fix: this sketch is model (A) only. We NEVER call LoRa.receive(). After
// endPacket(true) we wait exactly as long as THIS frame needs on the air -
// loraAirtimeMs() computes it from the length and LORA_SF - and then hand the
// radio back to parsePacket(), which re-arms RX on its next call.
void radioService() {
  // ---- finish an in-flight transmission -----------------------------------
  if (txInFlight) {
    if (millis() - txStart < txAirtimeMs) return;     // still on air
    txInFlight = false;                 // parsePacket() re-arms RX next loop
    statTx++;
    lastTxOkMs = millis();              // proof the local radio still works
    dutyUsedMs += txAirtimeMs;          // charge it to this minute budget
    txLast = millis();
    txGap  = TX_MIN_GAP_MS + (uint32_t)random(0, TX_GAP_JITTER_MS);
    return;
  }

  // ---- start the next queued transmission ---------------------------------
  if (!radioOk || txCount == 0) return;
  if (millis() - txLast < txGap) return;

  // beginPacket() returns 0 if the radio still thinks it is transmitting.
  // Leave the frame queued and try again very soon.
  if (LoRa.beginPacket() == 0) {
    statTxStuck++;
    txLast = millis() - txGap + 40;
    return;
  }

  uint16_t len = (uint16_t)strlen(txQueue[txHead]);
  LoRa.print(txQueue[txHead]);
  LoRa.endPacket(true);                 // async - returns straight away
  txInFlight  = true;
  txStart     = millis();
  // Wait for THIS frame's real on-air time, not a fixed guess. At SF9 a full
  // frame needs ~1005 ms; the old fixed 420 ms would have cut it off.
  txAirtimeMs = loraAirtimeMs(len) + TX_AIRTIME_MARGIN_MS;

  txHead = (uint8_t)((txHead + 1) % TX_QUEUE_DEPTH);
  txCount--;
}

bool radioPoll(Packet &out) {
  if (!radioOk) return false;
  if (txInFlight) return false;       // half duplex - not while we transmit
  int sz = LoRa.parsePacket();
  if (sz <= 0) return false;

  char buf[MAX_PACKET_LEN];
  int n = 0;
  while (LoRa.available() && n < (int)sizeof(buf) - 1) buf[n++] = (char)LoRa.read();
  buf[n] = '\0';
  while (LoRa.available()) LoRa.read();          // discard overflow

  int   rssi = LoRa.packetRssi();
  float snr  = LoRa.packetSnr();

  if (!pktParse(buf, out)) {
    // A frame got here with a VALID hardware CRC, so the PHY matches and the
    // RF link is fine - only the format did not. Printing it separates "the
    // radios cannot hear each other" from "they can hear each other but
    // disagree about the protocol", which is otherwise invisible.
    statBad++;
    Serial.printf("[rx-raw] unparsed  rssi=%d snr=%.1f len=%d  \"%.60s\"\n",
                  rssi, (double)snr, n, buf);
    return false;
  }
  out.rssi = rssi;
  out.snr  = snr;
  statRx++;
  return true;
}

// ===========================================================================
//  GPS MODULE  -  non-blocking NMEA reader
//
//  The old phase 10 code used Serial2.readStringUntil('\n'), which BLOCKS for
//  up to 1000 ms whenever the GPS is unplugged or silent - stalling the whole
//  loop and dropping LoRa packets. This assembles lines character by character
//  and never waits.
// ===========================================================================
char     nmeaBuf[NMEA_BUF_LEN];
uint8_t  nmeaLen = 0;

double   gpsLat = 0.0, gpsLon = 0.0;
bool     gpsHasFix = false;
uint32_t gpsFixTime = 0;        // millis() of the last valid fix (0 = never)
int      gpsSats = 0;
uint32_t gpsSentences = 0;      // NMEA lines seen - proves the module is wired

// Copy field `idx` (comma separated) out of an NMEA sentence.
bool nmeaField(const char *s, int idx, char *out, size_t outN) {
  int field = 0;
  const char *p = s;
  const char *start = s;
  while (1) {
    if (*p == ',' || *p == '*' || *p == '\0') {
      if (field == idx) {
        size_t len = (size_t)(p - start);
        if (len >= outN) len = outN - 1;
        memcpy(out, start, len);
        out[len] = '\0';
        return true;
      }
      if (*p == '*' || *p == '\0') return false;
      field++;
      start = p + 1;
    }
    p++;
  }
}

// NMEA gives ddmm.mmmm / dddmm.mmmm - always exactly 2 digits of whole minutes
// before the decimal point.
double nmeaCoord(const char *val, const char *dir) {
  size_t vl = strlen(val);
  if (vl < 4) return 0.0;
  const char *dot = strchr(val, '.');
  if (!dot) return 0.0;
  int degLen = (int)(dot - val) - 2;
  if (degLen <= 0 || degLen > 3) return 0.0;

  char degBuf[8];
  memcpy(degBuf, val, (size_t)degLen);
  degBuf[degLen] = '\0';

  double deg = atof(degBuf);
  double mins = atof(val + degLen);
  double d = deg + mins / 60.0;
  if (dir[0] == 'S' || dir[0] == 'W') d = -d;
  return d;
}

void nmeaParse(const char *line) {
  size_t len = strlen(line);
  if (len < 7 || line[0] != '$') return;
  gpsSentences++;

  // $GPRMC / $GNRMC  - position and validity
  if (strncmp(line + 3, "RMC", 3) == 0) {
    char status[4];
    if (!nmeaField(line, 2, status, sizeof(status))) return;
    if (status[0] != 'A') { gpsHasFix = false; return; }   // 'V' = not valid

    char la[16], ns[4], lo[16], ew[4];
    if (!nmeaField(line, 3, la, sizeof(la))) return;
    if (!nmeaField(line, 4, ns, sizeof(ns))) return;
    if (!nmeaField(line, 5, lo, sizeof(lo))) return;
    if (!nmeaField(line, 6, ew, sizeof(ew))) return;
    if (!la[0] || !lo[0] || !ns[0] || !ew[0]) return;

    // Validity comes from the 'A' status flag above, NOT from comparing the
    // coordinates against 0.0 - the old code did that and would have thrown
    // away a genuine fix on the equator or the prime meridian.
    gpsLat = nmeaCoord(la, ns);
    gpsLon = nmeaCoord(lo, ew);
    gpsHasFix = true;
    gpsFixTime = millis();
  }
  // $GPGGA / $GNGGA  - satellites in use
  else if (strncmp(line + 3, "GGA", 3) == 0) {
    char sats[8];
    if (nmeaField(line, 7, sats, sizeof(sats)) && sats[0]) gpsSats = atoi(sats);
  }
}

void gpsService() {
  while (Serial2.available()) {
    char c = (char)Serial2.read();
    if (c == '\n' || c == '\r') {
      if (nmeaLen > 6) { nmeaBuf[nmeaLen] = '\0'; nmeaParse(nmeaBuf); }
      nmeaLen = 0;
    } else if (nmeaLen < NMEA_BUF_LEN - 1) {
      nmeaBuf[nmeaLen++] = c;
    } else {
      nmeaLen = 0;                    // overlong sentence - discard
    }
  }
}

// ===========================================================================
//  HYBRID LOCATION MANAGER
//
//  Two independent sources:
//     LOC_PHONE  a position handed to us by a phone through the captive portal
//     LOC_GPS    a live fix from the NEO-6M / NEO-M8N module
//
//  The GPS module cannot get a fix indoors, under debris or beneath a roof -
//  exactly where a rescue node is most likely to be - so a fresh phone fix is
//  preferred and the module is the fallback. Flip LOCATION_PREFER_PHONE to
//  reverse that. If neither is fresh, the most recent of the two is used and
//  reported with its age so nobody mistakes it for live.
// ===========================================================================
double   phoneLat = 0.0, phoneLon = 0.0;
bool     phoneValid = false;
uint32_t phoneTime = 0;
float    phoneAcc = 0.0;
uint32_t phoneUpdates = 0;

// Returns LOC_NONE / LOC_GPS / LOC_PHONE and fills lat/lon/ageMs.
uint8_t locBest(double &lat, double &lon, uint32_t &ageMs) {
  uint32_t now = millis();
  bool gFresh = gpsHasFix  && gpsFixTime && (now - gpsFixTime < GPS_FRESH_MS);
  bool pFresh = phoneValid && phoneTime  && (now - phoneTime  < PHONE_FRESH_MS);

#if LOCATION_PREFER_PHONE
  if (pFresh) { lat = phoneLat; lon = phoneLon; ageMs = now - phoneTime;  return LOC_PHONE; }
  if (gFresh) { lat = gpsLat;   lon = gpsLon;   ageMs = now - gpsFixTime; return LOC_GPS;   }
#else
  if (gFresh) { lat = gpsLat;   lon = gpsLon;   ageMs = now - gpsFixTime; return LOC_GPS;   }
  if (pFresh) { lat = phoneLat; lon = phoneLon; ageMs = now - phoneTime;  return LOC_PHONE; }
#endif

  // Neither is fresh - fall back to whichever we heard most recently.
  if (gpsFixTime || phoneTime) {
    if (gpsFixTime >= phoneTime && gpsFixTime) {
      lat = gpsLat; lon = gpsLon; ageMs = now - gpsFixTime; return LOC_GPS;
    }
    if (phoneTime) {
      lat = phoneLat; lon = phoneLon; ageMs = now - phoneTime; return LOC_PHONE;
    }
  }
  lat = 0.0; lon = 0.0; ageMs = 0;
  return LOC_NONE;
}

const char *locSrcName(uint8_t src) {
  if (src == LOC_GPS)   return "GPS";
  if (src == LOC_PHONE) return "PHONE";
  return "NONE";
}

// Reject obviously bad input from the portal.
bool locValid(double lat, double lon) {
  if (lat < -90.0 || lat > 90.0)   return false;
  if (lon < -180.0 || lon > 180.0) return false;
  if (lat == 0.0 && lon == 0.0)    return false;   // null island = not a fix
  return true;
}

// ===========================================================================
//  OLED  (SH1106 via U8g2)  -  5 rows, ASCII only.
// ===========================================================================
bool oledOk = false;

// last frame pushed to the display, for change detection (see oledPush)
char uiPrev[5][26];
bool uiPrevValid = false;

void oledClear() { if (oledOk) display.clearBuffer(); }
void oledLine(uint8_t row, const char *txt) {
  if (oledOk && row < 5 && txt) display.drawStr(0, 10 + row * 12, txt);
}
void oledShow() { if (oledOk) display.sendBuffer(); }

void oledBanner(const char *l0, const char *l1) {
  oledClear();
  oledLine(0, l0);
  if (l1) oledLine(1, l1);
  oledShow();
  uiPrevValid = false;
}

// Push five lines to the display, but ONLY if anything actually changed.
//
// WHY THIS MATTERS FOR THE RADIO: a full 128x64 frame is 1 KB over I2C. At
// the ESP32's default 100 kHz that is ~100 ms with the loop blocked - every
// second. parsePacket() arms the SX1278 in RX_SINGLE, which listens for about
// 100 ms and then drops to STANDBY until the next poll, so a 100 ms stall can
// leave the radio deaf for a large slice of every second. That is what made
// nodes randomly "get lost". Wire runs at I2C_HZ now, and most redraws are
// skipped entirely because the content is identical to the last frame.
void oledPush(char l[5][26]) {
  if (uiPrevValid) {
    bool same = true;
    for (uint8_t i = 0; i < 5 && same; i++)
      if (strcmp(uiPrev[i], l[i]) != 0) same = false;
    if (same) return;                    // nothing to do - keep the radio free
  }
  for (uint8_t i = 0; i < 5; i++) {
    strncpy(uiPrev[i], l[i], sizeof(uiPrev[i]) - 1);
    uiPrev[i][sizeof(uiPrev[i]) - 1] = '\0';
  }
  uiPrevValid = true;

  oledClear();
  for (uint8_t i = 0; i < 5; i++) oledLine(i, l[i]);
  oledShow();
}

// oledBanner() writes directly, so make sure the next oledPush() redraws.
void oledInvalidate() { uiPrevValid = false; }

// ===========================================================================
//  CAPTIVE PORTAL
// ===========================================================================
// Forward declarations - the captive-portal handlers below call these, but the
// implementations sit further down next to the rest of the SOS/report code.
void   sosTrigger(const char *reason);
void   sosClearAlert(const char *why);
void   sendReport(const char *code);
void   sendStatus(const char *st);
bool   reportCodeValid(const char *c);
bool   statusValid(const char *s);

#if ENABLE_PORTAL
WebServer server(80);
DNSServer dns;
IPAddress apIP(192, 168, 4, 1);
bool portalOk = false;

const char PORTAL_HTML[] PROGMEM =
  "<!DOCTYPE html><html lang=\"en\"><head>\n"
  "<meta charset=\"utf-8\">\n"
  "<meta name=\"viewport\" content=\"width=device-width,initial-scale=1,viewport-fit=cover\">\n"
  "<meta name=\"theme-color\" content=\"#0b0d10\">\n"
  "<title>SAR Rescue Portal</title><style>\n"
  "*{box-sizing:border-box;-webkit-tap-highlight-color:transparent}\n"
  ":root{\n"
  " --bg:#0b0d10; --card:#151a21; --card2:#1b222b; --line:#252d38;\n"
  " --tx:#e8edf3; --dim:#8b96a5; --faint:#5b6675;\n"
  " --acc:#ff7a1a; --ok:#2ecc71; --warn:#ffc043; --bad:#ff4d4d; --info:#4da3ff;\n"
  "}\n"
  "body{margin:0;padding:0 0 28px;font:15px/1.45 system-ui,-apple-system,\"Segoe UI\",sans-serif;\n"
  " background:var(--bg);color:var(--tx)}\n"
  ".wrap{max-width:640px;margin:0 auto;padding:0 14px}\n"
  "\n"
  "header{position:sticky;top:0;z-index:20;background:rgba(11,13,16,.94);\n"
  " backdrop-filter:blur(10px);border-bottom:1px solid var(--line);padding:12px 0 10px}\n"
  ".htop{display:flex;align-items:center;gap:10px}\n"
  ".logo{width:32px;height:32px;border-radius:9px;background:linear-gradient(135deg,var(--acc),#ff4d4d);\n"
  " display:grid;place-items:center;font-weight:800;font-size:15px;color:#fff;flex:none}\n"
  "h1{font-size:16px;margin:0;font-weight:650;letter-spacing:.2px}\n"
  ".sub{font-size:11.5px;color:var(--dim);margin-top:1px}\n"
  ".dot{width:8px;height:8px;border-radius:50%;background:var(--faint);flex:none;\n"
  " box-shadow:0 0 0 3px rgba(255,255,255,.04)}\n"
  ".dot.on{background:var(--ok);animation:pulse 2s infinite}\n"
  ".dot.off{background:var(--bad)}\n"
  "@keyframes pulse{0%,100%{opacity:1}50%{opacity:.35}}\n"
  "\n"
  ".alert{margin:12px 0;padding:13px 14px;border-radius:12px;background:#3a0f0f;\n"
  " border:1px solid #ff4d4d;animation:flash 1.4s infinite}\n"
  "@keyframes flash{0%,100%{border-color:#ff4d4d}50%{border-color:#7a2020}}\n"
  ".alert .t{font-weight:750;font-size:14px;letter-spacing:.4px}\n"
  ".alert .d{font-size:13px;color:#ffc9c9;margin-top:3px;font-family:ui-monospace,monospace}\n"
  "\n"
  ".card{background:var(--card);border:1px solid var(--line);border-radius:14px;\n"
  " padding:14px;margin-top:12px}\n"
  ".k{font-size:10.5px;letter-spacing:.09em;text-transform:uppercase;color:var(--faint);\n"
  " font-weight:600;margin-bottom:8px;display:flex;align-items:center;gap:6px}\n"
  ".k .badge{margin-left:auto;text-transform:none;letter-spacing:0;font-size:11px;\n"
  " padding:2px 8px;border-radius:20px;background:var(--card2);color:var(--dim)}\n"
  "\n"
  ".big{font-size:21px;font-family:ui-monospace,Menlo,monospace;font-weight:600;\n"
  " letter-spacing:-.3px;word-break:break-all}\n"
  ".meta{font-size:12px;color:var(--dim);margin-top:4px;display:flex;\n"
  " align-items:center;gap:7px;flex-wrap:wrap}\n"
  ".tag{font-size:10.5px;padding:2px 8px;border-radius:20px;font-weight:600;\n"
  " background:var(--card2);color:var(--dim)}\n"
  ".tag.gps{background:rgba(46,204,113,.16);color:var(--ok)}\n"
  ".tag.phone{background:rgba(77,163,255,.16);color:var(--info)}\n"
  ".tag.none{background:rgba(255,77,77,.16);color:var(--bad)}\n"
  ".tag.stale{background:rgba(255,192,67,.16);color:var(--warn)}\n"
  "\n"
  "button{font:inherit;border:0;border-radius:11px;padding:13px;font-weight:650;\n"
  " cursor:pointer;transition:transform .08s,filter .15s;width:100%}\n"
  "button:active{transform:scale(.975)}\n"
  "button:disabled{opacity:.5}\n"
  ".sos{background:linear-gradient(135deg,#ff3b3b,#c81e1e);color:#fff;font-size:18px;\n"
  " padding:20px;letter-spacing:.5px;box-shadow:0 6px 18px rgba(255,59,59,.25)}\n"
  ".pri{background:var(--acc);color:#fff}\n"
  ".sec{background:var(--card2);color:var(--tx);border:1px solid var(--line)}\n"
  ".grid2{display:grid;grid-template-columns:1fr 1fr;gap:8px}\n"
  ".grid2 button{padding:12px 8px;font-size:13.5px}\n"
  "\n"
  "input{width:100%;padding:12px;margin:5px 0;border-radius:10px;font-size:15px;\n"
  " border:1px solid var(--line);background:#080a0d;color:var(--tx)}\n"
  "input:focus{outline:0;border-color:var(--acc)}\n"
  ".hint{font-size:11.5px;color:var(--faint);margin-top:8px;line-height:1.5}\n"
  "\n"
  "table{width:100%;border-collapse:collapse;font-size:13px}\n"
  "th{text-align:left;font-size:10px;letter-spacing:.07em;text-transform:uppercase;\n"
  " color:var(--faint);font-weight:600;padding:0 0 6px}\n"
  "td{padding:7px 0;border-top:1px solid var(--line);font-family:ui-monospace,monospace}\n"
  "tr:first-child td{border-top:0}\n"
  ".nid{font-weight:700;font-family:system-ui,sans-serif}\n"
  ".bars{display:inline-flex;gap:2px;vertical-align:middle}\n"
  ".bars i{width:3px;border-radius:1px;background:var(--line);display:block}\n"
  ".bars i:nth-child(1){height:5px}.bars i:nth-child(2){height:8px}\n"
  ".bars i:nth-child(3){height:11px}.bars i:nth-child(4){height:14px}\n"
  ".bars.s1 i:nth-child(-n+1),.bars.s2 i:nth-child(-n+2),\n"
  ".bars.s3 i:nth-child(-n+3),.bars.s4 i:nth-child(-n+4){background:var(--ok)}\n"
  ".bars.s1 i:nth-child(-n+1){background:var(--bad)}\n"
  ".bars.s2 i:nth-child(-n+2){background:var(--warn)}\n"
  ".lost{color:var(--bad);font-size:11.5px}\n"
  ".empty{color:var(--faint);font-size:13px;padding:8px 0;text-align:center}\n"
  "\n"
  "#toast{position:fixed;left:50%;bottom:22px;transform:translate(-50%,80px);\n"
  " background:var(--card2);border:1px solid var(--line);color:var(--tx);\n"
  " padding:11px 18px;border-radius:11px;font-size:13.5px;z-index:60;\n"
  " transition:transform .28s cubic-bezier(.2,.9,.3,1.3);max-width:90vw;\n"
  " box-shadow:0 8px 24px rgba(0,0,0,.5)}\n"
  "#toast.show{transform:translate(-50%,0)}\n"
  "#toast.good{border-color:var(--ok)} #toast.err{border-color:var(--bad)}\n"
  "\n"
  "details{margin-top:12px}\n"
  "summary{cursor:pointer;list-style:none;padding:13px 14px;background:var(--card);\n"
  " border:1px solid var(--line);border-radius:14px;font-size:13px;color:var(--dim);\n"
  " font-weight:600;display:flex;align-items:center}\n"
  "summary::-webkit-details-marker{display:none}\n"
  "summary:after{content:\"+\";margin-left:auto;font-size:17px;color:var(--faint)}\n"
  "details[open] summary{border-radius:14px 14px 0 0;color:var(--tx)}\n"
  "details[open] summary:after{content:\"-\"}\n"
  "details .card{margin-top:0;border-radius:0 0 14px 14px;border-top:0}\n"
  "</style></head><body>\n"
  "<div class=\"wrap\">\n"
  "\n"
  "<header>\n"
  " <div class=\"htop\">\n"
  "  <div class=\"logo\">SAR</div>\n"
  "  <div style=\"min-width:0\">\n"
  "   <h1>Rescue Portal</h1>\n"
  "   <div class=\"sub\" id=\"sub\">connecting...</div>\n"
  "  </div>\n"
  "  \n"
  " </div>\n"
  "</header>\n"
  "\n"
  "\n"
  "\n"
  "<div class=\"card\" style=\"text-align:center\">\n"
  " <button class=\"sos\" onclick=\"sos()\">SEND SOS</button>\n"
  " <div class=\"hint\" style=\"margin-top:10px\">Broadcasts your position to every node in the mesh.</div>\n"
  "</div>\n"
  "\n"
  "<div class=\"card\">\n"
  " <div class=\"k\">This node's position <span class=\"badge\" id=\"posbadge\">--</span></div>\n"
  " <div class=\"big\" id=\"pos\">--</div>\n"
  " <div class=\"meta\" id=\"posmeta\"><span class=\"tag none\">no fix</span></div>\n"
  "</div>\n"
  "\n"
  "<div class=\"card\">\n"
  " <div class=\"k\">Mesh <span class=\"badge\" id=\"peerbadge\">0 nodes</span></div>\n"
  " <table><thead><tr><th>Node</th><th>Signal</th><th>Seen</th><th>Position</th></tr></thead>\n"
  " <tbody id=\"peers\"></tbody></table>\n"
  " <button class=\"sec\" style=\"margin-top:12px\" onclick=\"rescan()\" id=\"rescanbtn\">\n"
  "   Search / Reconnect Nearby Nodes</button>\n"
  " <div class=\"hint\">Use this if a node vanished and hasn't come back. Reinitialises\n"
  "  this node's radio and rebroadcasts immediately.</div>\n"
  "</div>\n"
  "\n"
  "<div class=\"card\">\n"
  " <div class=\"k\">Share your location</div>\n"
  " <button class=\"pri\" onclick=\"share()\">Use Phone GPS</button>\n"
  " <div class=\"hint\" id=\"geohint\">Phone browsers only allow GPS over HTTPS. If this is\n"
  "  refused, paste coordinates from your maps app below - that always works.</div>\n"
  " <input id=\"la\" placeholder=\"latitude   e.g. 23.797810\" inputmode=\"decimal\">\n"
  " <input id=\"lo\" placeholder=\"longitude  e.g. 90.449720\" inputmode=\"decimal\">\n"
  " <button class=\"sec\" onclick=\"manual()\">Send Coordinates</button>\n"
  "</div>\n"
  "\n"
  "<div class=\"card\">\n"
  " <div class=\"k\">Quick rescue report</div>\n"
  " <div class=\"grid2\">\n"
  "  <button class=\"sec\" onclick=\"rpt('VICTIM_FOUND')\">Victim Found</button>\n"
  "  <button class=\"sec\" onclick=\"rpt('MEDICAL')\">Medical Help</button>\n"
  "  <button class=\"sec\" onclick=\"rpt('BLOCKED')\">Area Blocked</button>\n"
  "  <button class=\"sec\" onclick=\"rpt('DANGER')\">Danger</button>\n"
  " </div>\n"
  "</div>\n"
  "\n"
  "<div class=\"card\">\n"
  " <div class=\"k\">Team status <span class=\"badge\" id=\"mystat\">--</span></div>\n"
  " <div class=\"grid2\">\n"
  "  <button class=\"sec\" onclick=\"st('AVAILABLE')\">Available</button>\n"
  "  <button class=\"sec\" onclick=\"st('SEARCHING')\">Searching</button>\n"
  "  <button class=\"sec\" onclick=\"st('NEED_ASSIST')\">Need Assist</button>\n"
  "  <button class=\"sec\" onclick=\"st('EMERGENCY')\">Emergency</button>\n"
  " </div>\n"
  "</div>\n"
  "\n"
  "<details>\n"
  " <summary>Diagnostics</summary>\n"
  " <div class=\"card\">\n"
  "  <table><tbody id=\"diag\"></tbody></table>\n"
  " </div>\n"
  "</details>\n"
  "\n"
  "</div>\n"
  "\n"
  "\n"
  "<script>\n"
  "var $=function(i){return document.getElementById(i)};\n"
  "var toastT;\n"
  "function toast(m,cls){\n"
  " var t=$('toast'); t.textContent=m; t.className='show '+(cls||'');\n"
  " clearTimeout(toastT); toastT=setTimeout(function(){t.className=''},3200);\n"
  "}\n"
  "function esc(s){return String(s).replace(/[&<>]/g,function(c){return {'&':'&amp;','<':'&lt;','>':'&gt;'}[c]})}\n"
  "function age(s){s=+s||0; return s<60?s+'s':s<3600?Math.round(s/60)+'m':Math.round(s/3600)+'h'}\n"
  "function bars(r){ if(r>=-85)return 4; if(r>=-100)return 3; if(r>=-110)return 2; return 1 }\n"
  "\n"
  "function post(u,ok){\n"
  " fetch(u).then(function(r){return r.text()}).then(function(t){\n"
  "   toast(t,ok===false?'err':'good'); tick();\n"
  " }).catch(function(){ toast('Failed - still on the node Wi-Fi?','err') });\n"
  "}\n"
  "function sos(){ if(confirm('Broadcast an SOS to the whole mesh?')) post('/api/sos') }\n"
  "function rpt(c){ post('/api/report?code='+c) }\n"
  "function st(s){ post('/api/teamstatus?state='+s) }\n"
  "function rescan(){\n"
  " var b=$('rescanbtn'); b.disabled=true; b.textContent='Reconnecting...';\n"
  " fetch('/api/rescan').then(function(r){return r.text()}).then(function(t){\n"
  "   toast(t,'good');\n"
  " }).catch(function(){ toast('Request failed','err') })\n"
  " .then(function(){ setTimeout(function(){\n"
  "   b.disabled=false; b.textContent='Search / Reconnect Nearby Nodes'; tick();\n"
  " },2500)});\n"
  "}\n"
  "function sendLoc(a,b,c){ post('/api/loc?lat='+a+'&lon='+b+'&acc='+(c||0)) }\n"
  "function share(){\n"
  " if(!navigator.geolocation){ toast('No geolocation API in this browser','err'); return }\n"
  " toast('Requesting location...');\n"
  " navigator.geolocation.getCurrentPosition(\n"
  "  function(p){ sendLoc(p.coords.latitude.toFixed(6),p.coords.longitude.toFixed(6),\n"
  "                       Math.round(p.coords.accuracy)) },\n"
  "  function(e){ toast('Browser refused: '+e.message,'err');\n"
  "               $('geohint').style.color='#ffc043' },\n"
  "  {enableHighAccuracy:true,timeout:10000,maximumAge:0});\n"
  "}\n"
  "function manual(){\n"
  " var a=parseFloat($('la').value), b=parseFloat($('lo').value);\n"
  " if(isNaN(a)||isNaN(b)){ toast('Enter both latitude and longitude','err'); return }\n"
  " sendLoc(a.toFixed(6),b.toFixed(6),0);\n"
  "}\n"
  "\n"
  "var srcName={0:'no fix',1:'GPS module',2:'phone'};\n"
  "var srcCls ={0:'none',   1:'gps',       2:'phone'};\n"
  "\n"
  "function render(d){\n"
  " $('dot').className='dot on';\n"
  " $('sub').textContent='Node '+d.id+'  -  SF'+d.sf+'  -  '+(d.lora?'radio OK':'RADIO FAIL')\n"
  "                      +'  -  up '+age(d.up);\n"
  "\n"
  " // position\n"
  " if(d.src){\n"
  "   $('pos').textContent=d.lat.toFixed(6)+', '+d.lon.toFixed(6);\n"
  "   var stale=d.age>300;\n"
  "   $('posmeta').innerHTML='<span class=\"tag '+srcCls[d.src]+'\">'+srcName[d.src]+'</span>'\n"
  "     +'<span class=\"tag'+(stale?' stale':'')+'\">'+age(d.age)+' ago</span>'\n"
  "     +(d.src==1?'<span class=\"tag\">'+d.sats+' sats</span>':'');\n"
  "   $('posbadge').textContent=srcName[d.src];\n"
  " } else {\n"
  "   $('pos').textContent='no position yet';\n"
  "   $('posmeta').innerHTML='<span class=\"tag none\">waiting for GPS or a phone fix</span>';\n"
  "   $('posbadge').textContent='--';\n"
  " }\n"
  "\n"
  " // peers\n"
  " var up=d.peers.filter(function(p){return p.up}).length;\n"
  " $('peerbadge').textContent=up+' of '+d.peers.length+' up';\n"
  " $('peers').innerHTML = d.peers.length ? d.peers.map(function(p){\n"
  "   var sig = p.up\n"
  "     ? '<span class=\"bars s'+bars(p.rssi)+'\"><i></i><i></i><i></i><i></i></span> '+p.rssi\n"
  "     : '<span class=\"lost\">lost</span>';\n"
  "   var loc = p.hasloc ? p.lat.toFixed(4)+','+p.lon.toFixed(4) : '--';\n"
  "   return '<tr><td class=\"nid\">'+esc(p.id)+'</td><td>'+sig+'</td><td>'+age(p.age)\n"
  "        +'</td><td>'+loc+'</td></tr>';\n"
  " }).join('') : '<tr><td colspan=\"4\" class=\"empty\">searching for nodes...</td></tr>';\n"
  "\n"
  " // sos banner\n"
  " $('alertbox').innerHTML = d.sos\n"
  "   ? '<div class=\"alert\"><div class=\"t\">SOS - '+esc(d.sosvictim)+'</div>'\n"
  "     +'<div class=\"d\">'+esc(d.sostext||'MAYDAY')+'</div></div>'\n"
  "   : '';\n"
  "\n"
  " $('mystat').textContent=d.mystatus;\n"
  "\n"
  " // diagnostics\n"
  " var routes = d.routes.length\n"
  "   ? d.routes.map(function(r){return r.dest+' via '+r.via+' '+r.hops+'h'\n"
  "       +(r.valid?'':' (invalid)')}).join('<br>') : 'none';\n"
  " var g = d.nmea==0 ? 'SILENT - check wiring'\n"
  "        : (d.gpsfix?'FIX, '+d.sats+' sats':'no fix, '+d.sats+' sats');\n"
  " $('diag').innerHTML=\n"
  "   row('Firmware','v'+d.fw+'  SF'+d.sf)+\n"
  "   row('GPS',g+'  ('+d.nmea+' NMEA)')+\n"
  "   row('Routes',routes)+\n"
  "   row('Radio','tx '+d.tx+'  rx '+d.rx+'  bad '+d.bad+'  wedge '+d.wedge)+\n"
  "   row('Wi-Fi clients',d.wifi)+\n"
  "   row('Free heap',(d.heap/1024).toFixed(0)+' KB')+\n"
  "   row('Team',d.team);\n"
  "}\n"
  "function row(k,v){return '<tr><td style=\"color:var(--faint)\">'+k+'</td><td>'+v+'</td></tr>'}\n"
  "\n"
  "function tick(){\n"
  " fetch('/api/status').then(function(r){return r.json()}).then(render)\n"
  " .catch(function(){ $('dot').className='dot off'; $('sub').textContent='connection lost' });\n"
  "}\n"
  "setInterval(tick,4000); tick();\n"
  "</script></body></html>\n";

void handlePortal() {
  server.send_P(200, "text/html", PORTAL_HTML);
}

void handleLoc() {
  if (!server.hasArg("lat") || !server.hasArg("lon")) {
    server.send(400, "text/plain", "missing lat/lon");
    return;
  }
  double la = server.arg("lat").toDouble();
  double lo = server.arg("lon").toDouble();
  if (!locValid(la, lo)) {
    server.send(400, "text/plain", "Coordinates out of range - check and retry.");
    return;
  }
  phoneLat = la;
  phoneLon = lo;
  phoneAcc = server.hasArg("acc") ? server.arg("acc").toFloat() : 0.0f;
  phoneValid = true;
  phoneTime = millis();
  phoneUpdates++;

  Serial.printf("[portal] phone position %.6f,%.6f (acc %.0fm)\n", la, lo, (double)phoneAcc);
  server.send(200, "text/plain", "Location received - thank you.");
}

// Structured status for the portal. Peers are a proper JSON array now
// (rssi/snr/age/position per node) so the page can render signal bars and a
// live peer table instead of a pre-formatted blob of HTML from the firmware.
void handleStatus() {
  double lat = 0, lon = 0;
  uint32_t ageMs = 0;
  uint8_t src = locBest(lat, lon, ageMs);

  static char peers[600];
  peers[0] = '[';
  peers[1] = '\0';
  size_t used = 1;
  bool first = true;
  for (uint8_t i = 0; i < MAX_NEIGHBORS; i++) {
    if (!neighbors[i].used) continue;
    char row[160];
    int n = snprintf(row, sizeof(row),
             "%s{\"id\":\"%s\",\"up\":%d,\"rssi\":%d,\"snr\":%.1f,\"age\":%lu,"
             "\"hasloc\":%d,\"lat\":%.6f,\"lon\":%.6f,\"locsrc\":%u}",
             first ? "" : ",",
             neighbors[i].id, neighbors[i].active ? 1 : 0,
             neighbors[i].rssi, (double)neighbors[i].snr,
             (unsigned long)((millis() - neighbors[i].lastSeen) / 1000UL),
             neighbors[i].hasLoc ? 1 : 0,
             neighbors[i].lat, neighbors[i].lon,
             (unsigned)neighbors[i].locSrc);
    if (n < 0 || used + (size_t)n + 2 >= sizeof(peers)) break;
    memcpy(peers + used, row, (size_t)n);
    used += (size_t)n;
    peers[used] = '\0';
    first = false;
  }
  if (used + 2 < sizeof(peers)) { peers[used++] = ']'; peers[used] = '\0'; }

  static char routesJson[400];
  routesJson[0] = '[';
  routesJson[1] = '\0';
  size_t ru = 1;
  bool rfirst = true;
  for (uint8_t i = 0; i < MAX_ROUTES; i++) {
    if (!routes[i].used) continue;
    char row[100];
    int n = snprintf(row, sizeof(row),
             "%s{\"dest\":\"%s\",\"via\":\"%s\",\"hops\":%u,\"valid\":%d}",
             rfirst ? "" : ",", routes[i].dest, routes[i].nextHop,
             (unsigned)routes[i].hops, routes[i].valid ? 1 : 0);
    if (n < 0 || ru + (size_t)n + 2 >= sizeof(routesJson)) break;
    memcpy(routesJson + ru, row, (size_t)n);
    ru += (size_t)n;
    routesJson[ru] = '\0';
    rfirst = false;
  }
  if (ru + 2 < sizeof(routesJson)) { routesJson[ru++] = ']'; routesJson[ru] = '\0'; }

  static char json[1800];   // peers(600) + routes(400) + fixed(~300), with margin -
                             // a truncated response would be invalid JSON and
                             // the portal would show "connection lost"
  snprintf(json, sizeof(json),
           "{\"id\":\"%s\",\"fw\":%u,\"sf\":%d,\"lora\":%d,"
           "\"lat\":%.6f,\"lon\":%.6f,\"src\":%u,\"age\":%lu,"
           "\"gpsfix\":%d,\"sats\":%d,\"nmea\":%lu,"
           "\"heap\":%lu,\"up\":%lu,\"wifi\":%d,"
           "\"tx\":%lu,\"rx\":%lu,\"bad\":%lu,\"wedge\":%lu,"
           "\"mystatus\":\"%s\",\"team\":\"%s\","
           "\"sos\":%d,\"sosvictim\":\"%s\",\"sostext\":\"%s\","
           "\"peers\":%s,\"routes\":%s}",
           MY_ID, (unsigned)FW_VERSION, (int)LORA_SF, radioOk ? 1 : 0,
           lat, lon, (unsigned)src, (unsigned long)(ageMs / 1000UL),
           gpsHasFix ? 1 : 0, gpsSats, (unsigned long)gpsSentences,
           (unsigned long)ESP.getFreeHeap(),
           (unsigned long)(millis() / 1000UL),
#if ENABLE_PORTAL
           (int)WiFi.softAPgetStationNum(),
#else
           0,
#endif
           (unsigned long)statTx, (unsigned long)statRx,
           (unsigned long)statBad, (unsigned long)statWedge,
           myStatus, myTeam,
           sosAlert ? 1 : 0, sosVictim, sosText,
           peers, routesJson);
  server.send(200, "application/json", json);
}

void handleSos() {
  sosTrigger("PORTAL");
  server.send(200, "text/plain", "SOS broadcast to the whole mesh.");
}

void handleReport() {
  if (!server.hasArg("code")) { server.send(400, "text/plain", "missing code"); return; }
  char code[16];
  strncpy(code, server.arg("code").c_str(), sizeof(code) - 1);
  code[sizeof(code) - 1] = '\0';
  if (!reportCodeValid(code)) { server.send(400, "text/plain", "unknown report code"); return; }
  sendReport(code);
  server.send(200, "text/plain", "Report sent.");
}

void handleTeamStatus() {
  if (!server.hasArg("state")) { server.send(400, "text/plain", "missing state"); return; }
  char st[16];
  strncpy(st, server.arg("state").c_str(), sizeof(st) - 1);
  st[sizeof(st) - 1] = '\0';
  if (!statusValid(st)) { server.send(400, "text/plain", "unknown status"); return; }
  sendStatus(st);
  server.send(200, "text/plain", "Status updated.");
}

void handleRescan() {
  manualRescan("portal");
  server.send(200, "text/plain",
             "Reconnecting - radio reinitialised, broadcasting now. "
             "Give it a few seconds and refresh.");
}

void portalBegin() {
  WiFi.mode(WIFI_AP);
  WiFi.softAPConfig(apIP, apIP, IPAddress(255, 255, 255, 0));
  portalOk = WiFi.softAP(AP_SSID, AP_PASSWORD, AP_CHANNEL, 0, AP_MAX_CLIENTS);
  if (!portalOk) { Serial.println("[portal] softAP FAILED"); return; }

  // The phone is a metre away. Full Wi-Fi TX power buys nothing here and is a
  // big share of the average current - and therefore of the heat.
  WiFi.setTxPower(WIFI_TX_DBM);

  // Answer every DNS query with our own IP - that is what makes the phone
  // believe it has hit a captive portal and pop the browser open.
  dns.start(53, "*", apIP);

  server.on("/", handlePortal);
  server.on("/api/loc", handleLoc);
  server.on("/api/status", handleStatus);
  server.on("/api/sos", handleSos);
  server.on("/api/report", handleReport);
  server.on("/api/teamstatus", handleTeamStatus);
  server.on("/api/rescan", handleRescan);

  // Connectivity-check URLs the phones probe. Returning our page (rather than
  // the 204 / "Success" they expect) is what triggers the portal popup.
  server.on("/generate_204", handlePortal);              // Android
  server.on("/gen_204", handlePortal);                   // Android
  server.on("/hotspot-detect.html", handlePortal);       // iOS / macOS
  server.on("/library/test/success.html", handlePortal); // iOS
  server.on("/ncsi.txt", handlePortal);                  // Windows
  server.on("/connecttest.txt", handlePortal);           // Windows
  server.on("/fwlink", handlePortal);                    // Windows
  server.onNotFound(handlePortal);

  server.begin();
  Serial.printf("[portal] AP \"%s\" up at %s\n", AP_SSID, apIP.toString().c_str());
}

void portalService() {
  if (!portalOk) return;
  dns.processNextRequest();
  server.handleClient();
}
#endif  // ENABLE_PORTAL

// ===========================================================================
// ===========================================================================
//  WATCHDOG
//
//  IMPORTANT: the Arduino ESP32 core ALREADY starts the task watchdog before
//  setup() runs, with its own default timeout. Calling esp_task_wdt_init()
//  therefore fails with "TWDT already initialized" and our WDT_TIMEOUT_S is
//  silently ignored - the earlier build printed exactly that error and nobody
//  noticed. Reconfigure first, fall back to init, and print what we actually
//  ended up with so it can never be silently wrong again.
// ===========================================================================
// ===========================================================================
//  BOOT DIAGNOSTICS
//
//  When a node reboots on its own, THIS is the first thing to look at. The
//  ESP32 records why it last reset and keeps that across the reboot, so the
//  banner printed in setup() tells us which kind of fault we are chasing:
//
//    BROWNOUT  -> the 3.3V rail sagged. Power/USB/cable/capacitor problem,
//                 usually when LoRa TX + Wi-Fi + GPS draw at the same time.
//    TASK_WDT  -> loop() stalled for longer than WDT_TIMEOUT_S. Something
//                 blocked - most likely the radio or the I2C display.
//    PANIC     -> a real crash (null pointer, bad cast, stack overflow).
//    POWERON   -> normal: you applied power or pressed EN. Not a fault.
// ===========================================================================
const char *resetReasonName() {
  switch (esp_reset_reason()) {
    case ESP_RST_POWERON:   return "POWERON (normal power-up / EN button)";
    case ESP_RST_EXT:       return "EXT (external reset pin)";
    case ESP_RST_SW:        return "SW (software restart)";
    case ESP_RST_PANIC:     return "PANIC - crash/exception  <<< SOFTWARE BUG";
    case ESP_RST_INT_WDT:   return "INT_WDT - interrupt watchdog  <<< SOMETHING BLOCKED";
    case ESP_RST_TASK_WDT:  return "TASK_WDT - loop stalled  <<< SOMETHING BLOCKED";
    case ESP_RST_WDT:       return "WDT - other watchdog  <<< SOMETHING BLOCKED";
    case ESP_RST_DEEPSLEEP: return "DEEPSLEEP wake";
    case ESP_RST_BROWNOUT:  return "BROWNOUT - 3.3V rail sagged  <<< POWER PROBLEM";
    case ESP_RST_SDIO:      return "SDIO";
    default:                return "UNKNOWN";
  }
}

// Same thing in one word, for the periodic [stat] line.
const char *resetReasonShort() {
  switch (esp_reset_reason()) {
    case ESP_RST_POWERON:   return "POWERON";
    case ESP_RST_EXT:       return "EXT";
    case ESP_RST_SW:        return "SW";
    case ESP_RST_PANIC:     return "PANIC";
    case ESP_RST_INT_WDT:   return "INT_WDT";
    case ESP_RST_TASK_WDT:  return "TASK_WDT";
    case ESP_RST_WDT:       return "WDT";
    case ESP_RST_DEEPSLEEP: return "DEEPSLEEP";
    case ESP_RST_BROWNOUT:  return "BROWNOUT";
    default:                return "UNKNOWN";
  }
}

void wdtBegin() {
  esp_err_t e;
#if defined(ESP_ARDUINO_VERSION_MAJOR) && ESP_ARDUINO_VERSION_MAJOR >= 3
  esp_task_wdt_config_t cfg;
  cfg.timeout_ms     = WDT_TIMEOUT_S * 1000;
  cfg.idle_core_mask = 0;
  cfg.trigger_panic  = true;
  e = esp_task_wdt_reconfigure(&cfg);          // the TWDT is already running
  if (e != ESP_OK) e = esp_task_wdt_init(&cfg);
#else
  e = esp_task_wdt_init(WDT_TIMEOUT_S, true);
#endif
  esp_task_wdt_add(NULL);
  Serial.printf("[wdt] task watchdog set to %us (%s)\n",
                (unsigned)WDT_TIMEOUT_S, (e == ESP_OK) ? "ok" : "NOT APPLIED");
}

// ===========================================================================
//  APPLICATION
// ===========================================================================
void sendHeartbeat() {
  char payload[48];
  snprintf(payload, sizeof(payload), "%lu,%lu,%u",
           (unsigned long)(millis() / 1000UL),
           (unsigned long)ESP.getFreeHeap(),
           (unsigned)FW_VERSION);

  char frame[MAX_PACKET_LEN];
  if (pktBuild(frame, sizeof(frame), "HB", MY_ID, "*", nextMsgId(), 0, payload))
    radioEnqueue(frame);

  if (bootBeacons > 0) {
    bootBeacons--;                       // fast rediscovery right after a boot
    hbTimer.setPeriod(3000UL);
  } else if (anyNeighborMissing()) {
    // Someone we know is missing - beacon faster so we find each other again,
    // but ONLY for RECONNECT_WINDOW_MS and only while the channel has room.
    // Unbounded fast beaconing is what congested the mesh into never
    // recovering; see RECONNECT_WINDOW_MS above.
    if (missingSinceMs == 0) missingSinceMs = millis();
    bool burst = (millis() - missingSinceMs < RECONNECT_WINDOW_MS) &&
                 dutyAllows(64);  // a typical HB frame; frame[] is unset if pktBuild failed
    hbTimer.setPeriod(burst ? RECONNECT_HB_MS + (uint32_t)random(0, 800)
                            : HB_INTERVAL_MS + (uint32_t)random(0, HB_JITTER_MS));
  } else {
    missingSinceMs = 0;                  // everyone is back - reset the window
    hbTimer.setPeriod(HB_INTERVAL_MS + (uint32_t)random(0, HB_JITTER_MS));
  }
}

// GPS payload:  lat,lon,sats,source,age_seconds
void sendLocation() {
  gpsTimer.setPeriod(GPS_INTERVAL_MS + (uint32_t)random(0, GPS_JITTER_MS));

  double lat, lon;
  uint32_t ageMs;
  uint8_t src = locBest(lat, lon, ageMs);
  if (src == LOC_NONE) return;              // nothing worth sharing yet

  char payload[64];
  snprintf(payload, sizeof(payload), "%.6f,%.6f,%d,%u,%lu",
           lat, lon, gpsSats, (unsigned)src, (unsigned long)(ageMs / 1000UL));

  char frame[MAX_PACKET_LEN];
  if (pktBuild(frame, sizeof(frame), "GPS", MY_ID, "*", nextMsgId(), 0, payload)
      && dutyAllows((uint16_t)strlen(frame)))
    radioEnqueue(frame);
}

// Advertise everything we can currently reach:  dest,hops,via;dest,hops,via;
// The `via` field is what lets a receiver apply split horizon - see the
// ROUTING TABLE section above.
void sendRoutes() {
  rtTimer.setPeriod(RT_INTERVAL_MS + (uint32_t)random(0, RT_JITTER_MS));

  char payload[MAX_PAYLOAD_LEN];
  payload[0] = '\0';
  size_t used = 0;
  for (uint8_t i = 0; i < MAX_ROUTES; i++) {
    if (!routes[i].used || !routes[i].valid) continue;
    char e[24];
    int n = snprintf(e, sizeof(e), "%s,%u,%s;",
                     routes[i].dest, (unsigned)routes[i].hops, routes[i].nextHop);
    if (n < 0 || used + (size_t)n + 1 >= sizeof(payload)) break;
    memcpy(payload + used, e, (size_t)n);
    used += (size_t)n;
    payload[used] = '\0';
  }

  // An empty advert is still worth sending - it announces we are alive and
  // gives our neighbours a 1-hop route to us.
  char frame[MAX_PACKET_LEN];
  if (pktBuild(frame, sizeof(frame), "RT", MY_ID, "*", nextMsgId(), 0, payload)
      && dutyAllows((uint16_t)strlen(frame)))
    radioEnqueue(frame);
}

// Send an application message to `dest`, possibly several hops away.
void sendData(const char *dest, const char *text) {
  if (strcmp(dest, MY_ID) == 0) {
    Serial.println("[data] that destination is this node");
    return;
  }
  const char *hop = routeBestHop(dest);
  if (!hop) {
    Serial.printf("[data] NO ROUTE to %s - nothing sent (press 'r' to see the table)\n", dest);
    return;
  }
  char frame[MAX_PACKET_LEN];
  if (pktBuild(frame, sizeof(frame), "DATA", MY_ID, dest,
               nextMsgId(), MAX_HOPS, text)) {
    radioEnqueue(frame);
    statDataTx++;
    Serial.printf("[data] TX -> %s via %s : %s\n", dest, hop, text);
  }
}

void sendTestTo(const char *dest) {
  static uint16_t seq = 1;
  char text[48];
  snprintf(text, sizeof(text), "ping #%u from %s", (unsigned)seq++, MY_ID);
  strncpy(autoTarget, dest, sizeof(autoTarget) - 1);
  autoTarget[sizeof(autoTarget) - 1] = '\0';
  sendData(dest, text);
}

void printRoutes() {
  Serial.println("\n---- ROUTING TABLE -------------------------------------");
  Serial.println("DEST  VIA   HOPS  RSSI    AGE(s)  STATE");
  bool any = false;
  for (uint8_t i = 0; i < MAX_ROUTES; i++) {
    if (!routes[i].used) continue;
    any = true;
    Serial.printf("%-5s %-5s %-5u %-7d %-7lu %s\n",
                  routes[i].dest, routes[i].nextHop, (unsigned)routes[i].hops,
                  routes[i].rssi,
                  (unsigned long)((millis() - routes[i].lastUpdated) / 1000UL),
                  routes[i].valid ? "VALID" : "invalid (self-healing)");
  }
  if (!any) Serial.println("(no routes learned yet)");
  Serial.printf("forwarded=%lu  sent=%lu  delivered-to-me=%lu\n",
                (unsigned long)statFwd, (unsigned long)statDataTx,
                (unsigned long)statDataRx);
  Serial.println("--------------------------------------------------------\n");
}

// ===========================================================================
//  SOS  (Phase 4)
// ===========================================================================

// Raise the local full-screen alert. Used both when WE trigger an SOS and
// when we RECEIVE one.
void sosShowAlert(const char *victim, double lat, double lon, const char *text) {
  sosAlert = true;
  sosAlertStart = millis();
  strncpy(sosVictim, victim, sizeof(sosVictim) - 1);
  sosVictim[sizeof(sosVictim) - 1] = '\0';
  sosLat = lat;
  sosLon = lon;
  strncpy(sosText, text, sizeof(sosText) - 1);
  sosText[sizeof(sosText) - 1] = '\0';
}

void sosClearAlert(const char *why) {
  if (!sosAlert) return;
  sosAlert = false;
  sosAcks[0] = '\0';
  Serial.printf("[sos] alert cleared (%s)\n", why);
}

// Begin OUR own SOS. Non-blocking: sosService() queues the copies.
void sosTrigger(const char *reason) {
  double lat, lon;
  uint32_t ageMs;
  uint8_t src = locBest(lat, lon, ageMs);

  // Carry a real position if we have one; if not, say so rather than lying
  // with 0,0 the way the old code's hardcoded coordinates did.
  char loctag[40];
  if (src == LOC_NONE) {
    lat = 0; lon = 0;
    snprintf(loctag, sizeof(loctag), "NO-FIX");
  } else {
    snprintf(loctag, sizeof(loctag), "%s%s",
             locSrcName(src), (ageMs > 120000UL) ? "-STALE" : "");
  }

  snprintf(sosBurstMsg, sizeof(sosBurstMsg), "%s", reason);
  sosBurstId   = nextMsgId();
  sosBurstLeft = SOS_BURST_COUNT;
  sosSending   = true;
  sosBurstTimer.begin(SOS_BURST_GAP_MS, 0);   // first copy goes immediately

  sosShowAlert(MY_ID, lat, lon, reason);      // takeover on our own screen too

  Serial.printf("\n[sos] *** SOS TRIGGERED (%s) *** pos %.6f,%.6f (%s)\n",
                reason, lat, lon, loctag);
}

// Queue one copy of the in-progress SOS burst.
void sosSendCopy() {
  double lat, lon;
  uint32_t ageMs;
  locBest(lat, lon, ageMs);

  char payload[80];
  snprintf(payload, sizeof(payload), "%.6f,%.6f,%s", lat, lon, sosBurstMsg);

  char frame[MAX_PACKET_LEN];
  if (pktBuild(frame, sizeof(frame), "SOS", MY_ID, "*", sosBurstId, MAX_HOPS, payload))
    radioEnqueue(frame);

  Serial.printf("[sos] broadcast copy %u/%u\n",
                (unsigned)(SOS_BURST_COUNT - sosBurstLeft + 1), (unsigned)SOS_BURST_COUNT);
}

// Called every loop. Drives the burst and the screen auto-clear.
void sosService() {
  if (sosSending && sosBurstTimer.due()) {
    sosSendCopy();
    if (--sosBurstLeft == 0) sosSending = false;
  }
  if (sosAlert && (millis() - sosAlertStart > SOS_SCREEN_MS))
    sosClearAlert("timeout");
}

// Reply to a received SOS so the victim knows someone heard.
void sosSendAck(const char *victim, uint16_t origId) {
  char payload[16];
  snprintf(payload, sizeof(payload), "%s,%u", victim, (unsigned)origId);
  char frame[MAX_PACKET_LEN];
  if (pktBuild(frame, sizeof(frame), "SOSACK", MY_ID, victim, nextMsgId(), MAX_HOPS, payload))
    radioEnqueue(frame);
}

// ===========================================================================
//  SOS BUTTON  -  edge detected, hold-to-clear
// ===========================================================================
void buttonService() {
  bool now = (digitalRead(PIN_SOS_BUTTON) == HIGH);   // true = released
  uint32_t t = millis();

  if (now != btnPrev) {
    if (t - btnChangeTime < SOS_DEBOUNCE_MS) return;   // bounce
    btnChangeTime = t;

    if (!now) {                       // just pressed
      btnHeldHandled = false;
    } else {                          // just released
      if (!btnHeldHandled) {
        // short press
        if (sosAlert && strcmp(sosVictim, MY_ID) != 0)
          sosClearAlert("button tap on a received alert");
        else
          sosTrigger("BUTTON");
      }
    }
    btnPrev = now;
    return;
  }

  // held down
  if (!now && !btnHeldHandled && (t - btnChangeTime > SOS_BUTTON_HOLD_MS)) {
    btnHeldHandled = true;
    if (sosAlert) sosClearAlert("button held");
    else          sosTrigger("BUTTON-HOLD");
  }
}

// ===========================================================================
//  RESCUE REPORT + TEAM STATUS  (Phase 4)
// ===========================================================================
bool reportCodeValid(const char *c) {
  return !strcmp(c, "VICTIM_FOUND") || !strcmp(c, "MEDICAL") ||
         !strcmp(c, "BLOCKED")      || !strcmp(c, "DANGER");
}
bool statusValid(const char *s) {
  return !strcmp(s, "AVAILABLE")    || !strcmp(s, "SEARCHING") ||
         !strcmp(s, "VICTIM_FOUND") || !strcmp(s, "NEED_ASSIST") ||
         !strcmp(s, "EMERGENCY");
}

void sendReport(const char *code) {
  if (!reportCodeValid(code)) { Serial.printf("[rpt] bad code %s\n", code); return; }
  double lat, lon; uint32_t ageMs;
  locBest(lat, lon, ageMs);

  char payload[64];
  snprintf(payload, sizeof(payload), "%s,%.6f,%.6f,%s", code, lat, lon, myTeam);
  char frame[MAX_PACKET_LEN];
  if (pktBuild(frame, sizeof(frame), "RPT", MY_ID, "*", nextMsgId(), MAX_HOPS, payload))
    radioEnqueue(frame);

  int i = peerRepIndex(MY_ID);
  if (i >= 0) { strncpy(peerRep[i].code, code, sizeof(peerRep[i].code) - 1);
                peerRep[i].reportTime = millis(); }
  Serial.printf("[rpt] sent %s\n", code);
}

void sendStatus(const char *st) {
  if (!statusValid(st)) { Serial.printf("[stat] bad status %s\n", st); return; }
  strncpy(myStatus, st, sizeof(myStatus) - 1);
  myStatus[sizeof(myStatus) - 1] = '\0';

  char payload[24];
  snprintf(payload, sizeof(payload), "%s,%s", myTeam, myStatus);
  char frame[MAX_PACKET_LEN];
  if (pktBuild(frame, sizeof(frame), "STAT", MY_ID, "*", nextMsgId(), 0, payload))
    radioEnqueue(frame);

  int i = peerRepIndex(MY_ID);
  if (i >= 0) { strncpy(peerRep[i].status, myStatus, sizeof(peerRep[i].status) - 1);
                peerRep[i].statusTime = millis(); }
  Serial.printf("[team] status -> %s\n", myStatus);
}

void handleOneRx() {
  Packet p;
  if (!radioPoll(p)) return;
  if (strcmp(p.src, MY_ID) == 0) return;              // our own echo

  // Duplicate suppression applies ONLY to packet types we forward. HB / RT /
  // GPS / STAT are broadcast, never relayed, and idempotent - running one
  // twice just re-stamps a timestamp. Deduping them broke reconnection: a
  // rebooted node restarts its msgId at 1, our seen-ring still holds its old
  // (src,1..N), so its fresh heartbeats looked like duplicates for minutes
  // and the node stayed LOST until the ring cycled.
  bool forwardable = !strcmp(p.type, "DATA")   || !strcmp(p.type, "SOS")    ||
                     !strcmp(p.type, "CMD")    ||
                     !strcmp(p.type, "SOSACK") || !strcmp(p.type, "RPT")   ||
                     !strcmp(p.type, "ROVER");   // Phase 8: the Rover's telemetry
  if (forwardable && seenOrAdd(p.src, p.msgId)) return;   // already handled

  int ev = neighborSeen(p.src, p.rssi, p.snr);
  if      (ev == NB_NEW)         Serial.printf("[mesh] NEW neighbour %s  %d dBm\n", p.src, p.rssi);
  else if (ev == NB_RECONNECTED) {
    seenForget(p.src);          // it may have rebooted and restarted its msgIds
    Serial.printf("[mesh] RECONNECTED %s  %d dBm\n", p.src, p.rssi);
  }
  else if (ev == NB_FULL)        Serial.println("[mesh] neighbour table FULL");

  // Anything heard directly is one hop away, whatever the packet type was.
  int rev = routeUpdate(p.src, p.src, 1, p.rssi);
  if      (rev == RT_NEW)       Serial.printf("[route] NEW       %s via %s 1h\n", p.src, p.src);
  else if (rev == RT_RECOVERED) Serial.printf("[route] RECOVERED %s via %s 1h  <<< SELF-HEALED\n", p.src, p.src);
  else if (rev == RT_BETTER)    Serial.printf("[route] BETTER    %s via %s 1h\n", p.src, p.src);

  if (strcmp(p.type, "HB") == 0) {
    unsigned long up = 0, hp = 0;
    unsigned      fw = 0;
    if (sscanf(p.payload, "%lu,%lu,%u", &up, &hp, &fw) >= 2)
      neighborSetStats(p.src, (uint32_t)up, (uint32_t)hp);

  } else if (strcmp(p.type, "RT") == 0) {
    // Everything the advertiser can reach becomes reachable through it.
    char buf[MAX_PAYLOAD_LEN];
    strncpy(buf, p.payload, sizeof(buf) - 1);
    buf[sizeof(buf) - 1] = '\0';

    char *tok = strtok(buf, ";");
    while (tok) {
      char d[4], v[4];
      unsigned h = 0;
      if (routeParseEntry(tok, d, sizeof(d), &h, v, sizeof(v))) {
        // SPLIT HORIZON: if the advertiser reaches d through US, that path
        // only exists because of us. Accepting it back is exactly how hop
        // counts climb to infinity, so drop it.
        if (strcmp(v, MY_ID) != 0 && strcmp(d, MY_ID) != 0) {
          int e = routeUpdate(d, p.src, (uint8_t)(h + 1), p.rssi);
          if      (e == RT_NEW)       Serial.printf("[route] NEW       %s via %s %uh\n", d, p.src, h + 1);
          else if (e == RT_BETTER)    Serial.printf("[route] BETTER    %s via %s %uh\n", d, p.src, h + 1);
          else if (e == RT_RECOVERED) Serial.printf("[route] RECOVERED %s via %s %uh  <<< SELF-HEALED\n", d, p.src, h + 1);
          else if (e == RT_FULL)      Serial.println("[route] table FULL");
        }
      }
      tok = strtok(NULL, ";");
    }

  } else if (strcmp(p.type, "DATA") == 0) {
    if (strcmp(p.dest, MY_ID) == 0) {
      // Arrived. MAX_HOPS was the starting TTL, so this is how far it came.
      unsigned hops = (unsigned)(MAX_HOPS - p.ttl);
      statDataRx++;
      snprintf(lastMsgFrom, sizeof(lastMsgFrom), "%s", p.src);
      snprintf(lastMsgText, sizeof(lastMsgText), "%s", p.payload);
      lastMsgTime = millis();
      Serial.printf("\n>>> MESSAGE from %s after %u hop(s): %s\n\n",
                    p.src, hops, p.payload);

    } else if (p.ttl > 0) {
      const char *hop = routeBestHop(p.dest);
      if (!hop) {
        // Not a silent black hole - say so, because this is what a broken
        // mesh looks like and it should be visible during a demo.
        Serial.printf("[fwd] DROP %s->%s : no route from here\n", p.src, p.dest);
      } else {
        char frame[MAX_PACKET_LEN];
        if (pktBuild(frame, sizeof(frame), "DATA", p.src, p.dest,
                     p.msgId, (uint8_t)(p.ttl - 1), p.payload)) {
          radioEnqueue(frame);
          statFwd++;
          Serial.printf("[fwd] %s->%s via %s (ttl %u)\n",
                        p.src, p.dest, hop, (unsigned)(p.ttl - 1));
        }
      }
    } else {
      Serial.printf("[fwd] DROP %s->%s : TTL expired\n", p.src, p.dest);
    }

  } else if (strcmp(p.type, "SOS") == 0) {
    double la = 0, lo = 0;
    char msg[48] = "";
    // payload: lat,lon,message  (message may contain commas - take the rest)
    char *c1 = strchr(p.payload, ',');
    char *c2 = c1 ? strchr(c1 + 1, ',') : NULL;
    if (c2) {
      *c1 = *c2 = '\0';
      la = atof(p.payload);
      lo = atof(c1 + 1);
      strncpy(msg, c2 + 1, sizeof(msg) - 1);
    }
    sosShowAlert(p.src, la, lo, msg);
    sosSendAck(p.src, p.msgId);        // let the victim know we heard
    Serial.printf("\n>>> SOS FROM %s : %s  @ %.6f,%.6f  (rssi %d)\n\n",
                  p.src, msg, la, lo, p.rssi);
    // still forward it - an SOS must reach the whole mesh
    if (p.ttl > 0) {
      char frame[MAX_PACKET_LEN];
      if (pktBuild(frame, sizeof(frame), "SOS", p.src, "*",
                   p.msgId, (uint8_t)(p.ttl - 1), p.payload)) {
        radioEnqueue(frame);
        statFwd++;
      }
    }

  } else if (strcmp(p.type, "SOSACK") == 0) {
    char who[4] = ""; unsigned oid = 0;
    if (sscanf(p.payload, "%3[^,],%u", who, &oid) >= 1) {
      // is this an ack for OUR sos, and are we still showing that alert?
      if (sosAlert && strcmp(sosVictim, MY_ID) == 0 && oid == sosBurstId) {
        if (!strstr(sosAcks, p.src)) {
          if (sosAcks[0]) strncat(sosAcks, ",", sizeof(sosAcks) - strlen(sosAcks) - 1);
          strncat(sosAcks, p.src, sizeof(sosAcks) - strlen(sosAcks) - 1);
        }
        Serial.printf("[sos] ACK from %s - someone heard our SOS\n", p.src);
      }
    }
    if (strcmp(p.dest, MY_ID) != 0 && p.ttl > 0) {      // relay toward the victim
      char frame[MAX_PACKET_LEN];
      if (pktBuild(frame, sizeof(frame), "SOSACK", p.src, p.dest,
                   p.msgId, (uint8_t)(p.ttl - 1), p.payload)) {
        radioEnqueue(frame); statFwd++;
      }
    }

  } else if (strcmp(p.type, "ROVER") == 0) {
    // Phase 8: the mobile Rover's telemetry - mode/obstacle/battery. This
    // node doesn't act on it, only relays it, the same reason RPT is
    // relayed below: the Rover may be reachable only through here (that's
    // the whole point of a "mobile relay" - it can be the one out of range).
    Serial.printf("[rover] %s : %s  (rssi %d)\n", p.src, p.payload, p.rssi);
    if (p.ttl > 0) {
      char frame[MAX_PACKET_LEN];
      if (pktBuild(frame, sizeof(frame), "ROVER", p.src, "*",
                   p.msgId, (uint8_t)(p.ttl - 1), p.payload)) {
        radioEnqueue(frame); statFwd++;
      }
    }

  } else if (strcmp(p.type, "RPT") == 0) {
    char code[14] = ""; double la = 0, lo = 0; char team[8] = "";
    if (sscanf(p.payload, "%13[^,],%lf,%lf,%7s", code, &la, &lo, team) >= 1) {
      int i = peerRepIndex(p.src);
      if (i >= 0) { strncpy(peerRep[i].code, code, sizeof(peerRep[i].code) - 1);
                    peerRep[i].code[sizeof(peerRep[i].code) - 1] = '\0';
                    peerRep[i].reportTime = millis(); }
      if (locValid(la, lo)) neighborSetLoc(p.src, la, lo, LOC_PHONE);
      Serial.printf(">>> REPORT from %s (team %s): %s  @ %.6f,%.6f\n",
                    p.src, team, code, la, lo);
    }
    if (p.ttl > 0) {
      char frame[MAX_PACKET_LEN];
      if (pktBuild(frame, sizeof(frame), "RPT", p.src, "*",
                   p.msgId, (uint8_t)(p.ttl - 1), p.payload)) {
        radioEnqueue(frame); statFwd++;
      }
    }

  } else if (strcmp(p.type, "STAT") == 0) {
    char team[8] = ""; char st[14] = "";
    if (sscanf(p.payload, "%7[^,],%13s", team, st) == 2) {
      int i = peerRepIndex(p.src);
      if (i >= 0) { strncpy(peerRep[i].status, st, sizeof(peerRep[i].status) - 1);
                    peerRep[i].status[sizeof(peerRep[i].status) - 1] = '\0';
                    peerRep[i].statusTime = millis(); }
      Serial.printf("[team] %s (team %s) is now %s\n", p.src, team, st);
    }

  } else if (strcmp(p.type, "CMD") == 0) {
    // Commands from the Pi command centre (src "PI").  payload = verb[,arg]
    if (strcmp(p.dest, MY_ID) == 0) {
      char verb[12] = "";
      sscanf(p.payload, "%11[^,]", verb);
      Serial.printf("[cmd] %s from %s\n", verb, p.src);

      if (!strcmp(verb, "WHERE")) {
        sendLocation();                       // reply with a fresh GPS packet
      } else if (!strcmp(verb, "PING")) {
        char frame[MAX_PACKET_LEN];
        if (pktBuild(frame, sizeof(frame), "DATA", MY_ID, p.src,
                     nextMsgId(), MAX_HOPS, "pong"))
          radioEnqueue(frame);
      } else if (!strcmp(verb, "SOS")) {
        sosTrigger("REMOTE");                  // command centre raises it for us
      } else if (!strcmp(verb, "SOSCLR")) {
        sosClearAlert("command centre");
      }
    } else if (p.ttl > 0 && routeBestHop(p.dest)) {
      char frame[MAX_PACKET_LEN];
      if (pktBuild(frame, sizeof(frame), "CMD", p.src, p.dest,
                   p.msgId, (uint8_t)(p.ttl - 1), p.payload)) {
        radioEnqueue(frame); statFwd++;
      }
    }

  } else if (strcmp(p.type, "GPS") == 0) {
    double la = 0, lo = 0;
    int sats = 0;
    unsigned src = 0;
    unsigned long age = 0;
    if (sscanf(p.payload, "%lf,%lf,%d,%u,%lu", &la, &lo, &sats, &src, &age) >= 2) {
      if (locValid(la, lo)) {
        neighborSetLoc(p.src, la, lo, (uint8_t)src);
        Serial.printf("[loc] %s is at %.6f,%.6f via %s (%lus old)\n",
                      p.src, la, lo, locSrcName((uint8_t)src), age);
      }
    }
  }

  if (verboseRx)
    Serial.printf("[rx] %s from %s id=%u ttl=%u rssi=%d snr=%.1f : %s\n",
                  p.type, p.src, (unsigned)p.msgId, (unsigned)p.ttl,
                  p.rssi, (double)p.snr, p.payload);
}

// Drain the receiver each loop. During an SOS burst three nodes transmit
// copies, forwards and ACKs within a second or two; handling only one
// packet per loop (plus its slow Serial.printf) let the rest fall out of
// the single-packet RX FIFO - which is how every node lost every neighbour
// right after an SOS. Bounded so a flood cannot stall the loop.
void handleRx() {
  for (uint8_t i = 0; i < 4; i++) handleOneRx();
}

// ===========================================================================
//  OLED PAGES  (Phase 7 redesign)
//
//  5 rows x ~21 characters. Reorganised around what you actually need while
//  walking around with the thing:
//
//    0 OVERVIEW   who am I, how many peers, where am I, am I healthy
//    1 LINKS      signal strength per peer      <- the range-test page
//    2 ROUTES     who I can reach and via whom
//    3 POSITIONS  where the other nodes are
//    4 GPS/TEAM   GPS health and team status
//
//  Every page carries a "n/5" marker so you know where you are in the cycle,
//  and every page is built into one char[5][26] then handed to oledPush(),
//  which skips the redraw when nothing changed.
// ===========================================================================

// Four-level signal bar - readable at a glance while moving.
const char *sigBars(int rssi) {
  if (rssi >= -85)  return "||||";
  if (rssi >= -100) return "|||.";
  if (rssi >= -110) return "||..";
  if (rssi >= -118) return "|...";
  return "....";
}

// Compact uptime: 45s / 12m / 3h
void fmtAge(uint32_t ms, char *out, size_t n) {
  uint32_t s = ms / 1000UL;
  if (s < 60)        snprintf(out, n, "%lus", (unsigned long)s);
  else if (s < 3600) snprintf(out, n, "%lum", (unsigned long)(s / 60));
  else               snprintf(out, n, "%luh", (unsigned long)(s / 3600));
}

// ---- page 0: OVERVIEW -----------------------------------------------------
void drawPage0() {
  char l[5][26];
  char list[20], upStr[8];
  neighborActiveList(list, sizeof(list));
  fmtAge(millis(), upStr, sizeof(upStr));

  double lat, lon;
  uint32_t ageMs;
  uint8_t src = locBest(lat, lon, ageMs);

#if ENABLE_PORTAL
  snprintf(l[0], sizeof(l[0]), "NODE %s  SF%d  w%d  1/5",
           MY_ID, (int)LORA_SF, (int)WiFi.softAPgetStationNum());
#else
  snprintf(l[0], sizeof(l[0]), "NODE %s  SF%d      1/5", MY_ID, (int)LORA_SF);
#endif

  snprintf(l[1], sizeof(l[1]), "Peers %u  Routes %u%s",
           (unsigned)neighborActiveCount(), (unsigned)routeValidCount(),
           radioOk ? "" : " !RF");

  if (src == LOC_NONE) {
    snprintf(l[2], sizeof(l[2]), "LOC   none yet");
    snprintf(l[3], sizeof(l[3]), "GPS %s sat%d nmea%lu",
             gpsHasFix ? "FIX" : "--", gpsSats, (unsigned long)gpsSentences);
  } else {
    char ageStr[8];
    fmtAge(ageMs, ageStr, sizeof(ageStr));
    snprintf(l[2], sizeof(l[2]), "LOC %s %s", locSrcName(src), ageStr);
    snprintf(l[3], sizeof(l[3]), "%.5f %.5f", lat, lon);
  }

  // Rounded so oledPush()'s change-detection can actually skip most seconds
  // instead of redrawing because a counter ticked by one.
  snprintf(l[4], sizeof(l[4]), "up %s  heap %luk", upStr,
           (unsigned long)(ESP.getFreeHeap() / 1024));

  oledPush(l);
}

// ---- page 1: LINKS - the page to watch during a range test ---------------
void drawPage1() {
  char l[5][26];
  snprintf(l[0], sizeof(l[0]), "-- LINKS --   %u up 2/5",
           (unsigned)neighborActiveCount());

  uint8_t row = 1;
  for (uint8_t i = 0; i < MAX_NEIGHBORS && row < 5; i++) {
    if (!neighbors[i].used) continue;
    char ageStr[8];
    fmtAge(millis() - neighbors[i].lastSeen, ageStr, sizeof(ageStr));
    if (neighbors[i].active)
      snprintf(l[row], sizeof(l[row]), "%-2s %s %4d %s",
               neighbors[i].id, sigBars(neighbors[i].rssi),
               neighbors[i].rssi, ageStr);
    else
      snprintf(l[row], sizeof(l[row]), "%-2s LOST     %s",
               neighbors[i].id, ageStr);
    row++;
  }
  if (row == 1) { snprintf(l[1], sizeof(l[1]), "searching..."); row = 2; }
  while (row < 5) { l[row][0] = '\0'; row++; }
  oledPush(l);
}

// ---- page 2: ROUTES ------------------------------------------------------
void drawPage2() {
  char l[5][26];
  snprintf(l[0], sizeof(l[0]), "-- ROUTES --  %u   3/5",
           (unsigned)routeValidCount());

  uint8_t row = 1;
  for (uint8_t i = 0; i < MAX_ROUTES && row < 5; i++) {
    if (!routes[i].used) continue;
    snprintf(l[row], sizeof(l[row]), "%-2s via %-2s %uhop %s",
             routes[i].dest, routes[i].nextHop, (unsigned)routes[i].hops,
             routes[i].valid ? "ok" : "X");
    row++;
  }
  if (row == 1) { snprintf(l[1], sizeof(l[1]), "no routes yet"); row = 2; }
  while (row < 5) { l[row][0] = '\0'; row++; }
  oledPush(l);
}

// ---- page 3: POSITIONS ---------------------------------------------------
void drawPage3() {
  char l[5][26];
  snprintf(l[0], sizeof(l[0]), "-- POSITIONS --   4/5");

  uint8_t row = 1;
  for (uint8_t i = 0; i < MAX_NEIGHBORS && row < 5; i++) {
    if (!neighbors[i].used) continue;
    if (neighbors[i].hasLoc)
      snprintf(l[row], sizeof(l[row]), "%-2s %.4f %.4f",
               neighbors[i].id, neighbors[i].lat, neighbors[i].lon);
    else
      snprintf(l[row], sizeof(l[row]), "%-2s no fix", neighbors[i].id);
    row++;
  }
  if (row == 1) { snprintf(l[1], sizeof(l[1]), "no peers heard"); row = 2; }
  while (row < 5) { l[row][0] = '\0'; row++; }
  oledPush(l);
}

// ---- page 4: GPS health + team status ------------------------------------
void drawPage4() {
  char l[5][26];
  snprintf(l[0], sizeof(l[0]), "-- GPS / TEAM --  5/5");

  if (gpsSentences == 0)
    snprintf(l[1], sizeof(l[1]), "GPS SILENT - wiring!");
  else if (!gpsHasFix)
    snprintf(l[1], sizeof(l[1]), "GPS no fix sat%d", gpsSats);
  else
    snprintf(l[1], sizeof(l[1]), "GPS FIX  sat%d", gpsSats);

  char fixAge[8];
  if (gpsFixTime) {
    fmtAge(millis() - gpsFixTime, fixAge, sizeof(fixAge));
    snprintf(l[2], sizeof(l[2]), "nmea %lu  fix %s",
             (unsigned long)gpsSentences, fixAge);
  } else {
    snprintf(l[2], sizeof(l[2]), "nmea %lu  no fix yet",
             (unsigned long)gpsSentences);
  }

  uint8_t row = 3;
  for (uint8_t i = 0; i < MAX_NEIGHBORS + 1 && row < 5; i++) {
    if (!peerRep[i].used || !peerRep[i].status[0]) continue;
    snprintf(l[row], sizeof(l[row]), "%-2s %.14s",
             peerRep[i].id, peerRep[i].status);
    row++;
  }
  while (row < 5) { l[row][0] = '\0'; row++; }
  oledPush(l);
}

// Full-screen SOS takeover. Shown whenever an alert is active - ours or a
// received one - and cleared by sosService() after SOS_SCREEN_MS or by the
// button. This is the screen the old phase 11 code could never get rid of.
void drawSosScreen() {
  char l[5][26];
  bool mine = (strcmp(sosVictim, MY_ID) == 0);
  snprintf(l[0], sizeof(l[0]), "***   S O S   ***");
  snprintf(l[1], sizeof(l[1]), mine ? "FROM THIS NODE (%s)" : "VICTIM:  %s", sosVictim);
  if (sosLat == 0 && sosLon == 0)
    snprintf(l[2], sizeof(l[2]), "position: NO FIX");
  else
    snprintf(l[2], sizeof(l[2]), "%.5f %.5f", sosLat, sosLon);
  snprintf(l[3], sizeof(l[3]), "%.20s", sosText[0] ? sosText : "MAYDAY");
  uint32_t left = (millis() - sosAlertStart < SOS_SCREEN_MS)
                  ? (SOS_SCREEN_MS - (millis() - sosAlertStart)) / 1000UL : 0;
  if (mine && sosAcks[0])
    snprintf(l[4], sizeof(l[4]), "heard by: %.11s", sosAcks);
  else
    snprintf(l[4], sizeof(l[4]), "clears %lus - hold btn", (unsigned long)left);
  oledPush(l);
}

// The display cycles through the pages every UI_PAGE_MS; 'p' skips ahead.
void drawUI() {
  if (sosAlert) { drawSosScreen(); return; }   // takeover wins over every page
  if      (uiPage == 1) drawPage1();
  else if (uiPage == 2) drawPage2();
  else if (uiPage == 3) drawPage3();
  else if (uiPage == 4) drawPage4();
  else                  drawPage0();
}

void printNeighbours() {
  Serial.println("\n---- NEIGHBOURS ----------------------------------------");
  Serial.println("ID   RSSI   SNR    AGE(s)  POSITION                  SRC");
  bool any = false;
  for (uint8_t i = 0; i < MAX_NEIGHBORS; i++) {
    if (!neighbors[i].used) continue;
    any = true;
    char pos[32];
    if (neighbors[i].hasLoc)
      snprintf(pos, sizeof(pos), "%.5f,%.5f", neighbors[i].lat, neighbors[i].lon);
    else
      snprintf(pos, sizeof(pos), "no fix");
    Serial.printf("%-4s %-6d %-6.1f %-7lu %-25s %-6s %s\n",
                  neighbors[i].id, neighbors[i].rssi, (double)neighbors[i].snr,
                  (unsigned long)((millis() - neighbors[i].lastSeen) / 1000UL),
                  pos, locSrcName(neighbors[i].locSrc),
                  neighbors[i].active ? "ACTIVE" : "lost");
  }
  if (!any) Serial.println("(none discovered yet)");
  Serial.println("--------------------------------------------------------\n");
}

void printLocation() {
  double lat, lon;
  uint32_t ageMs;
  uint8_t src = locBest(lat, lon, ageMs);

  Serial.println("\n---- LOCATION ------------------------------------------");
  Serial.printf("  in use   : %s", locSrcName(src));
  if (src != LOC_NONE) Serial.printf("  %.6f, %.6f  (%lus old)",
                                     lat, lon, (unsigned long)(ageMs / 1000UL));
  Serial.println();
  Serial.printf("  preference: %s first\n",
                LOCATION_PREFER_PHONE ? "PHONE" : "GPS module");
  Serial.printf("  GPS module: %s  sats=%d  nmea lines=%lu",
                gpsHasFix ? "FIX" : "no fix", gpsSats, (unsigned long)gpsSentences);
  if (gpsFixTime) Serial.printf("  last fix %lus ago",
                                (unsigned long)((millis() - gpsFixTime) / 1000UL));
  Serial.println();
  if (gpsSentences == 0)
    Serial.println("             ^ no NMEA at all - check GPS TX -> GPIO16 and 9600 baud");
  Serial.printf("  phone     : %s", phoneValid ? "have position" : "none received");
  if (phoneValid) Serial.printf("  %.6f, %.6f  acc %.0fm  %lus ago  (%lu updates)",
                                phoneLat, phoneLon, (double)phoneAcc,
                                (unsigned long)((millis() - phoneTime) / 1000UL),
                                (unsigned long)phoneUpdates);
  Serial.println();
  Serial.println("--------------------------------------------------------\n");
}

void printStats() {
  Serial.printf("[stat] up=%lus heap=%lu neigh=%u tx=%lu rx=%lu bad=%lu drop=%lu q=%u",
                (unsigned long)(millis() / 1000UL),
                (unsigned long)ESP.getFreeHeap(),
                (unsigned)neighborActiveCount(),
                (unsigned long)statTx, (unsigned long)statRx,
                (unsigned long)statBad, (unsigned long)statDrop,
                (unsigned)txCount);
#if ENABLE_PORTAL
  Serial.printf(" wifi=%d", (int)WiFi.softAPgetStationNum());
#endif
  double lat, lon; uint32_t ageMs;
  Serial.printf(" loc=%s gps=%s/%d nmea=%lu maxloop=%lums minheap=%lu stack=%lu txstuck=%lu wedge=%lu rst=%s\n",
                locSrcName(locBest(lat, lon, ageMs)),
                gpsHasFix ? "FIX" : "nofix", gpsSats,
                (unsigned long)gpsSentences,
                (unsigned long)maxLoopMs,
                (unsigned long)esp_get_minimum_free_heap_size(),
                (unsigned long)uxTaskGetStackHighWaterMark(NULL),
                (unsigned long)statTxStuck,
                (unsigned long)statWedge,
                resetReasonShort());
  maxLoopMs = 0;                 // report the peak per interval, not since boot
}

void handleSerial() {
  if (!Serial.available()) return;
  int c = Serial.read();

  if (c == 'n') {
    printNeighbours();

  } else if (c == 's') {
    printStats();

  } else if (c == 'g') {
    printLocation();

  } else if (c == 'x') {
    // Integrity test: send a frame whose checksum is deliberately wrong.
    // Every peer must count it under "bad" and must NOT add a neighbour.
    char frame[MAX_PACKET_LEN];
    if (pktBuild(frame, sizeof(frame), "HB", MY_ID, "*", nextMsgId(), 0, "0,0,1")) {
      size_t len = strlen(frame);
      frame[len - 1] = (frame[len - 1] == '0') ? '1' : '0';
      radioEnqueue(frame);
      Serial.println("[test] queued a BAD-CHECKSUM frame - peers must reject it");
    }

  } else if (c == 'r') {
    printRoutes();

  } else if (c == 'a' || c == 'b' || c == 'c') {
    char dest[2] = { (char)(c - 32), '\0' };      // 'a' -> "A"
    sendTestTo(dest);

  } else if (c == 't') {
    autoData = !autoData;
    if (autoData && !autoTarget[0]) {
      // no target chosen yet - use the first destination we know a way to
      for (uint8_t i = 0; i < MAX_ROUTES; i++) {
        if (routes[i].used && routes[i].valid) {
          strncpy(autoTarget, routes[i].dest, sizeof(autoTarget) - 1);
          autoTarget[sizeof(autoTarget) - 1] = '\0';
          break;
        }
      }
    }
    if (autoData && autoTarget[0]) {
      autoTimer.begin(AUTO_DATA_MS, 1000UL);
      Serial.printf("[auto] repeat send to %s every %lus - press 't' to stop\n",
                    autoTarget, (unsigned long)(AUTO_DATA_MS / 1000UL));
    } else {
      autoData = false;
      Serial.println("[auto] off (pick a target first with a/b/c)");
    }

  } else if (c == 'p') {
    uiPage = (uint8_t)((uiPage + 1) % UI_PAGES);
    pageTimer.begin(UI_PAGE_MS, UI_PAGE_MS);
    drawUI();
    Serial.printf("[ui] page %u\n", (unsigned)uiPage);

  } else if (c == 'S') {
    sosTrigger("SERIAL");

  } else if (c == 'C') {
    sosClearAlert("serial C");

  } else if (c == '1') { sendReport("VICTIM_FOUND");
  } else if (c == '2') { sendReport("MEDICAL");
  } else if (c == '3') { sendReport("BLOCKED");
  } else if (c == '4') { sendReport("DANGER");

  } else if (c == '5') { sendStatus("AVAILABLE");
  } else if (c == '6') { sendStatus("SEARCHING");
  } else if (c == '7') { sendStatus("NEED_ASSIST");
  } else if (c == '8') { sendStatus("EMERGENCY");

  } else if (c == 'R') {
    manualRescan("serial");

  } else if (c == 'T') {
    radioTest = !radioTest;
    Serial.printf("[test] radio test mode %s - plain PING every 3 s.\n",
                  radioTest ? "ON" : "off");
    Serial.println("[test] watch the OTHER nodes for a [rx-raw] PING line.");
    Serial.println("[test] nothing there = PHY mismatch, dead radio, or no antenna.");

  } else if (c == 'v') {
    verboseRx = !verboseRx;
    Serial.printf("[ui] per-packet rx logging %s\n", verboseRx ? "ON" : "off");

  } else if (c == 'N') {
    // Raw NMEA dump - the fastest way to tell a dead GPS from a GPS that is
    // simply indoors. Blocks for 5 s on purpose; the mesh catches up after.
    Serial.println("\n---- RAW NMEA (5 s) --------------------------------");
    Serial.println("nothing at all  -> check GPS TX -> GPIO16, and 9600 baud");
    Serial.println("$G..GGA with 00 sats -> module fine, no sky view yet");
    uint32_t until = millis() + 5000;
    while (millis() < until) {
      esp_task_wdt_reset();
      while (Serial2.available()) Serial.write((char)Serial2.read());
    }
    Serial.println("\n----------------------------------------------------\n");

  } else if (c == 'h' || c == '?') {
    Serial.println("commands: n=neighbours r=routes g=GPS s=stats  a|b|c=send msg to that node");
    Serial.println("          t=toggle repeat send  p=next OLED page  x=bad frame");
    Serial.println("  SOS:  S=trigger SOS  C=clear alert");
    Serial.println("  report 1=VictimFound 2=Medical 3=Blocked 4=Danger");
    Serial.println("  status 5=Available 6=Searching 7=NeedAssist 8=Emergency");
    Serial.println("  diag:  v=toggle rx log  N=raw NMEA dump (5s)  R=manual rescan/reconnect");
  }
}

// ===========================================================================
//  SETUP
// ===========================================================================
void setup() {
  // BEFORE Serial.begin() - changing the CPU clock afterwards re-divides the
  // UART and garbles the console. 240 MHz is wasted here and is a large part
  // of why the board runs hot; the loop is idle most of the time anyway.
  setCpuFrequencyMhz(CPU_MHZ);

  Serial.begin(SERIAL_BAUD);
  delay(200);

  pinMode(PIN_SOS_BUTTON, INPUT_PULLUP);      // used from Phase 3

  // Seed from a floating ADC1 pin, not GPIO 0. GPIO 0 is a strapping pin and
  // reads nearly the same on every board, so the old code gave all the nodes
  // correlated "random" jitter.
  randomSeed(((uint32_t)analogRead(PIN_ENTROPY) << 16) ^ micros());

  memset(seenKeys, 0, sizeof(seenKeys));
  neighborInit();
  routeInit();
  for (uint8_t i = 0; i < MAX_NEIGHBORS + 1; i++) peerRep[i].used = false;
  peerRepIndex(MY_ID);   // create our own status row

  // STEP 1: display
  Wire.begin(I2C_SDA, I2C_SCL);
  // CRITICAL: the ESP32 Wire library has no timeout by default. If the OLED
  // ever glitches or clock-stretches mid-transaction, Wire can block INSIDE
  // loop() forever - not just the display, everything hanging off loop():
  // the radio, the watchdog logic that recovers it, and the portal's
  // handleClient(), which is exactly what "button does nothing, OLED frozen,
  // eventually reboots" looks like. This is the actual safety net; the clock
  // speed below just makes it less likely to be needed.
  Wire.setTimeOut(I2C_TIMEOUT_MS);
  Wire.setClock(I2C_HZ);           // standard 100kHz - more reliable than 400kHz on
                                    // the breadboard wiring most SH1106 clones ship with
  display.begin();
  display.setFont(u8g2_font_6x12_tr);
  oledOk = true;
  oledBanner("Booting...", "Node " MY_ID);

  Serial.printf("\n[boot] Node %s fw v%u  heap=%lu\n",
                MY_ID, (unsigned)FW_VERSION, (unsigned long)ESP.getFreeHeap());
  Serial.printf("[boot] last reset: %s\n", resetReasonName());
  // Print the reason for the LAST reset in a box that cannot be scrolled past.
  // If a node is restarting by itself, this single line identifies the cause.
  Serial.println("\n############################################################");
  Serial.printf ("#  WHY DID THIS NODE LAST RESTART?\n");
  Serial.printf ("#     %s\n", resetReasonName());
  Serial.println("############################################################\n");

  // Every node AND the Pi must show IDENTICAL numbers in this box. One
  // mismatched spreading factor makes them completely deaf to each other,
  // which looks exactly like "nothing connects to anything" - and there is no
  // error anywhere to tell you, because a radio that hears nothing looks the
  // same as a radio with nobody in range.
  Serial.println("############################################################");
  Serial.println("#  RADIO PHY - MUST BE IDENTICAL ON ALL 3 NODES AND THE PI");
  Serial.printf ("#     freq %ld Hz    SF%d    BW %ld Hz    CR 4/%d\n",
                 (long)LORA_FREQ, (int)LORA_SF, (long)LORA_BW, (int)LORA_CR);
  Serial.printf ("#     sync 0x%02X    preamble %d    CRC on    TX %d dBm\n",
                 (int)LORA_SYNCWORD, (int)LORA_PREAMBLE, (int)LORA_TXPOWER);
  Serial.printf ("#     CPU %u MHz\n", (unsigned)getCpuFrequencyMhz());
  Serial.println("#  Pi must match: SF/BW/CR/sync in development/pi/sx1278.py");
  Serial.println("############################################################\n");

  // STEP 2: GPS serial
  // Bigger RX buffer than the 256-byte default. A NEO-M8N with several
  // constellations enabled emits well over 256 bytes per second in bursts;
  // if loop() is briefly busy (a LoRa transmit at SF9 is ~370 ms) the default
  // buffer overruns and NMEA sentences arrive truncated - which looks exactly
  // like "the GPS isn't working" even though the module is fine.
  // setRxBufferSize() must be called BEFORE begin().
  Serial2.setRxBufferSize(1024);
  Serial2.begin(GPS_BAUD, SERIAL_8N1, GPS_RX_PIN, GPS_TX_PIN);
  Serial.printf("[gps] Serial2 %d baud on RX%d/TX%d (1KB rx buffer)\n",
                GPS_BAUD, GPS_RX_PIN, GPS_TX_PIN);

  // STEP 3: radio
  lastTxOkMs = millis();          // don't let the wedge watchdog fire before we even try
  if (radioBegin()) {
    Serial.printf("[radio] LoRa OK  SF%d BW125 CRC=on sync=0x%02X pwr=%ddBm\n",
                  (int)LORA_SF, (int)LORA_SYNCWORD, (int)LORA_TXPOWER);
    char l1[24];
    snprintf(l1, sizeof(l1), "SF%d CRC on", (int)LORA_SF);
    oledBanner("LoRa OK", l1);
  } else {
    // Deliberately NOT while(1). The old sketches hung here with a frozen
    // screen and no watchdog; this one keeps running and keeps retrying.
    Serial.println("[radio] LoRa FAIL - check SPI wiring and 3.3V (never 5V)");
    oledBanner("LoRa FAIL", "check SPI / 3V3");
  }

  // STEP 4: Wi-Fi captive portal
#if ENABLE_PORTAL
  portalBegin();
  oledBanner("WiFi AP up", AP_SSID);
#endif

  {
    char rl[24];
    snprintf(rl, sizeof(rl), "rst:%s", resetReasonShort());
    oledBanner("Last restart was", rl);
  }

  wdtBegin();

  hbTimer.begin(3000UL, 500UL + (uint32_t)random(0, 1200));   // fast first beacons
  gpsTimer.begin(GPS_INTERVAL_MS, 4000UL + (uint32_t)random(0, GPS_JITTER_MS));
  rtTimer.begin(RT_INTERVAL_MS, 2000UL + (uint32_t)random(0, RT_JITTER_MS));
  pageTimer.begin(UI_PAGE_MS, UI_PAGE_MS);
  autoTimer.begin(AUTO_DATA_MS, AUTO_DATA_MS);
  uiTimer.begin(OLED_REFRESH_MS, OLED_REFRESH_MS);
  statTimer.begin(STAT_LOG_MS, STAT_LOG_MS);
  retryTimer.begin(RADIO_RETRY_MS, RADIO_RETRY_MS);

  Serial.println("[boot] ready. type 'h' for commands.");
}

// ===========================================================================
//  LOOP   -   no delay() anywhere below this line
// ===========================================================================
void loop() {
  esp_task_wdt_reset();
  loopStartMs = millis();

  // 1. drain the GPS serial buffer (never blocks)
  gpsService();

  // 1b. SOS button (edge detected) and the SOS burst/auto-clear state machine
  buttonService();
  sosService();

  // 2. serve the captive portal (both calls are non-blocking)
#if ENABLE_PORTAL
  portalService();
#endif

  // 3. receive LoRa
  handleRx();

  // 4. age out silent neighbours
  char lost[4];
  while (neighborPrune(lost, sizeof(lost)))
    Serial.printf("[mesh] LOST %s (no packet for %lus)\n",
                  lost, (unsigned long)(NEIGHBOR_TIMEOUT_MS / 1000UL));

  // 4b. invalidate routes whose advertiser has gone quiet - this is the
  //     self-healing trigger, and it is what stops traffic vanishing into a
  //     relay that is no longer there
  char deadDest[4];
  while (routeExpire(deadDest, sizeof(deadDest)))
    Serial.printf("[route] LOST %s - no advert for %lus, invalidating  <<< SELF-HEALING\n",
                  deadDest, (unsigned long)(ROUTE_TIMEOUT_MS / 1000UL));

  // 5. periodic broadcasts
  if (radioTest && millis() - testLast > 3000UL) {
    testLast = millis();
    char t[48];
    snprintf(t, sizeof(t), "PING %s %lu", MY_ID, (unsigned long)(millis() / 1000UL));
    radioEnqueue(t);
    Serial.printf("[test] sent \"%s\"\n", t);
  }

  if (hbTimer.due())  sendHeartbeat();
  if (gpsTimer.due()) sendLocation();
  if (rtTimer.due())  sendRoutes();
  if (autoData && autoTarget[0] && autoTimer.due()) sendTestTo(autoTarget);

  // 6. transmit pump
  radioService();

  // 7. display + periodic statistics
  if (pageTimer.due()) uiPage = (uint8_t)((uiPage + 1) % UI_PAGES);
  if (uiTimer.due())   drawUI();
  if (statTimer.due()) printStats();

  // 8. recover a radio that failed at boot, or force a reinit if it wedged
  if (!radioOk && retryTimer.due()) {
    Serial.println("[radio] retrying init...");
    if (radioBegin()) Serial.println("[radio] recovered");
  }
  radioWatchdog();

  // 9. serial commands
  handleSerial();

  // 10. how long did this pass take? a long pass means a deaf radio
  uint32_t dt = millis() - loopStartMs;
  if (dt > maxLoopMs) maxLoopMs = dt;
}
