sabrinasadiafaria/LoRa-WiFi-Mesh-Infrastructure/development/phase 8/Node B.md

// ===========================================================================
//  PHASE 7  -  RANGE, GPS & NEW UI  -  NODE B
//  ESP32 + LoRa SX1278 (433 MHz) + 0.96" SSD1306 OLED + NEO-M8N GPS + Wi-Fi portal
//
//  Complete standalone sketch - paste the whole file into the Arduino IDE.
//
//  Libraries: LoRa (Sandeep Mistry), Adafruit GFX, Adafruit SSD1306
//  Board:     ESP32 Dev Module
//
//  WHY THIS PHASE EXISTS - nodes would not link up outdoors, and the GPS
//  looked dead. Two real bugs were behind it:
//
//  1. SPREADING FACTOR WAS TUNED FOR A DESK, NOT A FIELD.
//     SF7 was chosen back in Phase 3 from bench measurements taken with the
//     nodes ~2 m apart (RSSI -62..-71 dBm). SF7 has the WORST sensitivity of
//     the usable settings: -123 dBm. Outdoors at distance that margin is
//     gone. Now SF9 (-129 dBm) - 6 dB better, roughly DOUBLE the range.
//
//  2. THE AIRTIME WAIT WAS A HARDCODED CONSTANT (a latent bug).
//     After endPacket(true) the sketch waited a fixed 420 ms before handing
//     the radio back to parsePacket(). That was sized for SF7, whose biggest
//     frame is ~318 ms. At SF9 a full frame needs ~1005 ms - so the wait
//     would have expired MID-TRANSMISSION and parsePacket() would have
//     yanked the radio out of TX, corrupting every large packet. Airtime is
//     now COMPUTED per frame from its length and LORA_SF (loraAirtimeMs),
//     so the spreading factor can be changed freely without breaking TX.
//
//  3. GPS SERIAL BUFFER TOO SMALL.
//     Serial2's default RX buffer is 256 bytes. A NEO-M8N with several
//     constellations emits more than that per second in bursts; when loop()
//     was briefly busy (an SF9 transmit is ~370 ms) the buffer overran and
//     NMEA sentences arrived truncated - looking exactly like a dead GPS.
//     Now 1 KB, set before Serial2.begin().
//
//  Beacon rates were slowed to pay for SF9's longer airtime (HB 15 s,
//  RT 30 s, GPS 45 s) with timeouts scaled to match, keeping the channel
//  around 18% busy with four nodes.
//
//  ALSO IN THIS PHASE
//    * Redesigned OLED - 5 organised pages, including a LINKS page showing
//      signal strength per peer, which is the page to watch during a range
//      test. Every page is marked n/5.
//    * Redesigned captive portal - modern responsive UI, live peer table with
//      signal bars, position card with source badges, toast notifications,
//      collapsible diagnostics. Polls /api/status every 4 s.
//
//  TUNING FOR YOUR SITE
//    Indoors / short range, want speed:   LORA_SF 7
//    Mixed indoor+outdoor (default):      LORA_SF 9
//    Maximum range, slow:                 LORA_SF 10 or 11
//    Change it in ALL THREE sketches - nodes on different SFs cannot hear
//    each other at all. Airtime and the watchdogs adapt automatically.
//
//  SOS button: momentary switch GPIO 4 to GND. tap = raise (or dismiss a
//  received alert), hold >1.5 s = dismiss.
//
//  Serial:  n r g s  a|b|c  t p  S C  1-4 reports  5-8 status
//           v = toggle rx log   N = raw NMEA dump   R = rescan   h = help
//
//  PHASE 8 ADDITION - the mesh now has a fourth member, the Rover ("R"), a
//  mobile node with motors + an ultrasonic sensor (development/phase 8/
//  Node Rover.md). This node's only change is relaying the Rover's ROVER:
//  telemetry broadcast (mode/obstacle/battery) like any other broadcast type
//  (SOS/RPT) - added to `forwardable` and given a forward-only branch in
//  handleOneRx() - so the Rover's status reaches the Pi dashboard even when
//  it is out of the Pi's direct range and this node (or A/C) is bridging.
//  Everything else here is byte-for-byte Phase 7.
// ===========================================================================

#include <SPI.h>
#include <LoRa.h>
#include <Wire.h>
#include <Adafruit_GFX.h>
#include <Adafruit_SSD1306.h>
#include <WiFi.h>
#include <WebServer.h>
#include <DNSServer.h>
#include <esp_task_wdt.h>
#include <esp_system.h>

#define SCREEN_WIDTH  128
#define SCREEN_HEIGHT  64
#define OLED_ADDR    0x3C

Adafruit_SSD1306 display(SCREEN_WIDTH, SCREEN_HEIGHT, &Wire, -1);

// ------------------------------- identity ---------------------------------
#define MY_ID          "B"
#define FW_VERSION      8
#define PROTO_VERSION   1

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

#define I2C_SDA        21
#define I2C_SCL        22

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

// ------------------------------ Wi-Fi portal ------------------------------
#define ENABLE_PORTAL   1              // set 0 to make this a LoRa-only relay
#define AP_SSID        "SOS_Node_B"
#define AP_PASSWORD    NULL            // NULL = open network (captive portal)
#define AP_CHANNEL      1
#define AP_MAX_CLIENTS  4

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

#define LOC_NONE   0
#define LOC_GPS    1
#define LOC_PHONE  2

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

Interval hbTimer, gpsTimer, rtTimer, autoTimer;
Interval uiTimer, pageTimer, statTimer, retryTimer;

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

  char *lastBar = strrchr(in, '|');
  if (!lastBar) return false;
  if (strlen(lastBar + 1) != 2) return false;

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

  p.ver = (uint8_t)atoi(f[0] + 1);
  if (p.ver != PROTO_VERSION) return false;

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

  if (!p.type[0] || !p.src[0] || !p.dest[0]) return false;
  return true;
}

// ===========================================================================
//  DUPLICATE SUPPRESSION
// ===========================================================================
uint32_t seenKeys[SEEN_CACHE_SIZE];
uint8_t  seenIdx = 0;

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

Neighbor neighbors[MAX_NEIGHBORS];

#define NB_UPDATED      0
#define NB_NEW          1
#define NB_RECONNECTED  2
#define NB_FULL        -1

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

Route routes[MAX_ROUTES];

#define RT_NONE       0
#define RT_NEW        1
#define RT_RECOVERED  2
#define RT_BETTER     3
#define RT_FULL      -1

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

  uint32_t now = millis();
  int i = routeIndex(dest);

  if (i >= 0) {
    bool wasValid = routes[i].valid;
    bool sameHop  = (strcmp(routes[i].nextHop, via) == 0);

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

// ---- SOS button, edge detected -----------------------------------------
bool     btnPrev       = true;       // INPUT_PULLUP idles HIGH
uint32_t btnChangeTime = 0;
bool     btnHeldHandled = false;

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

uint16_t nextMsgId() {
  if (++msgIdCounter == 0) msgIdCounter = 1;
  return msgIdCounter;
}

bool radioBegin() {
  SPI.begin(LORA_SCK, LORA_MISO, LORA_MOSI, LORA_SS);
  LoRa.setPins(LORA_SS, LORA_RST, LORA_DIO0);

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

  return (uint32_t)(tPre + (double)nPay * tSym + 0.5);
}

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

  // ---- start the next queued transmission ---------------------------------
  if (!radioOk || txCount == 0) return;
  if (millis() - txLast < txGap) return;

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

  txHead = (uint8_t)((txHead + 1) % TX_QUEUE_DEPTH);
  txCount--;
}

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

  int   rssi = LoRa.packetRssi();
  float snr  = LoRa.packetSnr();

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

  char degBuf[8];
  memcpy(degBuf, val, (size_t)degLen);
  degBuf[degLen] = '\0';

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

void nmeaParse(const char *line) {
  size_t len = strlen(line);
  if (len < 7 || line[0] != '$') return;
  gpsSentences++;

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

// ===========================================================================
//  OLED  (SSD1306 via Adafruit)  -  5 rows, ASCII only.
// ===========================================================================
bool oledOk = false;

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

  oledClear();
  for (uint8_t i = 0; i < 5; i++) oledLine(i, l[i]);
  oledShow();
}

// oledBanner() writes directly, so make sure the next oledPush() redraws.
void oledInvalidate() { uiPrevValid = false; }

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

#if ENABLE_PORTAL
WebServer server(80);
DNSServer dns;
IPAddress apIP(192, 168, 4, 1);
bool portalOk = false;

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

void handlePortal() {
  server.send_P(200, "text/html", PORTAL_HTML);
}

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

void handleSos() {
  sosTrigger("PORTAL");
  server.send(200, "text/plain", "SOS broadcast to the whole mesh.");
}

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

  server.begin();
  Serial.printf("[portal] AP \"%s\" up at %s\n", AP_SSID, apIP.toString().c_str());
}

void portalService() {
  if (!portalOk) return;
  dns.processNextRequest();
  server.handleClient();
}
#endif  // ENABLE_PORTAL

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

  char frame[MAX_PACKET_LEN];
  if (pktBuild(frame, sizeof(frame), "HB", MY_ID, "*", nextMsgId(), 0, payload))
    radioEnqueue(frame);

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

// GPS payload:  lat,lon,sats,source,age_seconds
void sendLocation() {
  gpsTimer.setPeriod(GPS_INTERVAL_MS + (uint32_t)random(0, GPS_JITTER_MS));

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

// ===========================================================================
//  SOS  (Phase 4)
// ===========================================================================

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

  sosShowAlert(MY_ID, lat, lon, reason);      // takeover on our own screen too

  Serial.printf("\n[sos] *** SOS TRIGGERED (%s) *** pos %.6f,%.6f (%s)\n",
                reason, lat, lon, loctag);
}

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

  char payload[80];
  snprintf(payload, sizeof(payload), "%.6f,%.6f,%s", lat, lon, sosBurstMsg);

  char frame[MAX_PACKET_LEN];
  if (pktBuild(frame, sizeof(frame), "SOS", MY_ID, "*", sosBurstId, MAX_HOPS, payload))
    radioEnqueue(frame);

  Serial.printf("[sos] broadcast copy %u/%u\n",
                (unsigned)(SOS_BURST_COUNT - sosBurstLeft + 1), (unsigned)SOS_BURST_COUNT);
}

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

  if (now != btnPrev) {
    if (t - btnChangeTime < SOS_DEBOUNCE_MS) return;   // bounce
    btnChangeTime = t;

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

  double lat, lon;
  uint32_t ageMs;
  uint8_t src = locBest(lat, lon, ageMs);

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

  oledPush(l);
}

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

void printLocation() {
  double lat, lon;
  uint32_t ageMs;
  uint8_t src = locBest(lat, lon, ageMs);

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

void handleSerial() {
  if (!Serial.available()) return;
  int c = Serial.read();

  if (c == 'n') {
    printNeighbours();

  } else if (c == 's') {
    printStats();

  } else if (c == 'g') {
    printLocation();

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

  } else if (c == 'r') {
    printRoutes();

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

  } else if (c == 'S') {
    sosTrigger("SERIAL");

  } else if (c == 'C') {
    sosClearAlert("serial C");

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

  } else if (c == 'R') {
    manualRescan("serial");

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

  Serial.begin(SERIAL_BAUD);
  delay(200);

  pinMode(PIN_SOS_BUTTON, INPUT_PULLUP);      // used from Phase 3

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

  // STEP 1: display
  Wire.begin(I2C_SDA, I2C_SCL);
  // CRITICAL: the ESP32 Wire library has no timeout by default. If the OLED
  // ever glitches or clock-stretches mid-transaction, Wire can block INSIDE
  // loop() forever - not just the display, everything hanging off loop():
  // the radio, the watchdog logic that recovers it, and the portal's
  // handleClient(), which is exactly what "button does nothing, OLED frozen,
  // eventually reboots" looks like. This is the actual safety net; the clock
  // speed below just makes it less likely to be needed.
  Wire.setTimeOut(I2C_TIMEOUT_MS);
  Wire.setClock(I2C_HZ);           // standard 100kHz - more reliable than 400kHz on
                                    // the breadboard wiring most SH1106 clones ship with
  oledOk = display.begin(SSD1306_SWITCHCAPVCC, OLED_ADDR);
  if (!oledOk) oledOk = display.begin(SSD1306_SWITCHCAPVCC, 0x3D);
  if (oledOk) {
    display.setTextSize(1);
    display.setTextColor(SSD1306_WHITE);
  } else {
    Serial.println("[oled] init FAILED - check SDA21 / SCL22");
  }
  oledBanner("Booting...", "Node " MY_ID);

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

  // STEP 4: Wi-Fi captive portal
#if ENABLE_PORTAL
  portalBegin();
  oledBanner("WiFi AP up", AP_SSID);
#endif

  {
    char rl[24];
    snprintf(rl, sizeof(rl), "rst:%s", resetReasonShort());
    oledBanner("Last restart was", rl);
  }

  wdtBegin();

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

  Serial.println("[boot] ready. type 'h' for commands.");
}

// ===========================================================================
//  LOOP   -   no delay() anywhere below this line
// ===========================================================================
void loop() {
  esp_task_wdt_reset();
  loopStartMs = millis();

  // 1. drain the GPS serial buffer (never blocks)
  gpsService();

  // 1b. SOS button (edge detected) and the SOS burst/auto-clear state machine
  buttonService();
  sosService();

  // 2. serve the captive portal (both calls are non-blocking)
#if ENABLE_PORTAL
  portalService();
#endif

  // 3. receive LoRa
  handleRx();

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

  // 6. transmit pump
  radioService();

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

  // 9. serial commands
  handleSerial();

  // 10. how long did this pass take? a long pass means a deaf radio
  uint32_t dt = millis() - loopStartMs;
  if (dt > maxLoopMs) maxLoopMs = dt;
}
