sabrinasadiafaria/LoRa-WiFi-Mesh-Infrastructure/development/docs/PLAN.md

# LoRa-WiFi SAR Mesh — Full Review, Feasibility Assessment & Phase-Wise Development Plan

## Context

This is a **CSE-4326 Microprocessors & Microcontrollers Laboratory** project: an off-grid,
self-healing **LoRa mesh** for Search & Rescue, with a Wi-Fi captive portal, an autonomous
rescue rover, and a Raspberry Pi command center. The proposal (`planing/Project poposal.pdf`,
14-slide deck, presented 1 Sep 2026) has **already been approved** — the goal now is to turn a
working-looking pile of copy-paste sketches into a **reliable, demonstrable, impressive** system.

The user has confirmed:
- **Hardware in hand:** 3× ESP32 + LoRa SX1278 (433 MHz) + OLED, NEO-6M/M8N GPS modules,
  push buttons + breadboard/power, Raspberry Pi + rover chassis/motor/ultrasonic parts.
- **Timeline:** approved, no hard checkpoint — proceed, but keep every phase independently demoable.
- **Code style:** keep the **Markdown copy-paste sketch** convention (one file per node, pasteable
  into Arduino IDE). New work lives under `development/`. **Do not touch the existing `phase N/` files.**
- **Must be in the final demo:** (1) reliable multi-hop mesh + self-healing, (2) SOS + live GPS,
  (3) Wi-Fi captive portal, (4) Raspberry Pi command center + dashboard.

This document is the deliverable the user asked for: sections 1–15 below, then the phase plan.
**No code changes yet — waiting for approval of this plan.**

---

## 1. Existing Project Structure

Documentation-and-code-snippet repo. **No `.ino`/`.cpp`/`.h`, no `platformio.ini`, no build system,
no `.gitignore`, no CI.** Every sketch is a full standalone program pasted inside a `.md` file.

```
LoRa-WiFi-Mesh-Infrastructure/
├── README.md                       # pitch; stale (only mentions phase 1)
├── Project idea.md                 # architecture narrative
├── PLan.md                         # 16-phase roadmap + packet-format reference
├── Project_Overview_And_Features.md# richest doc: 16-phase table + 12 "advanced features"
├── Hardware_Connections.md         # per-node wiring tables (assumes 3× plain ESP32)
├── Progress_Tracker.md             # test checklist: Phase 10 ✓, Phase 11 unchecked
├── X.md, abc.md                    # empty (0 bytes)
├── planing/  (untracked)           # "Project poposal.pdf" — the approved proposal deck
├── phase 1/   (7 files)            # OLED tests + LoRa TX/RX bring-up (this IS "Phase 2" too)
├── phase 3/   (2)  two-way non-blocking messaging
├── phase 4/   (2)  MSG/ACK reliable transport, retries, dedup
├── phase 5/   (2)  HB heartbeat, 12 s dead-node timeout
├── phase 6/   (2)  dynamic neighbor table
├── phase 7/   (2)  distance-vector routing advertisements (RT:)
├── phase 8/   (3)  multi-hop forwarding (DATA:), adds Node C (Nano/Uno)
├── phase 9/   (3)  self-healing: dead-route invalidation + failover + recovery
├── phase 10/  (3)  real NMEA GPS parsing on Serial2, GPS: telemetry
└── phase 11/  (3)  TEXT: messaging + hardware SOS button + full-screen SOS OLED  [in progress]
```
No `phase 2/`. Phases 12–16 (rover, Pi, dashboard, optimization, docs) are roadmap text only.

**Hardware target drift across phases:** early phases mix ESP32 + ESP32-S3 (Node B, SPI 12/13/11)
+ Arduino Nano/Uno (Node C, 2 KB RAM); phase 10/11 converge Node B/C back to plain ESP32.
`Hardware_Connections.md` documents the final intent: 3× identical ESP32, LoRa on 5/14/26 + SPI
18/19/23, OLED I2C 21/22, GPS on Serial2 16/17, SOS button GPIO 4.

**Packet protocol (all ASCII, colon-delimited, no CRC / length / auth):**
| Type | Format | Phase |
|---|---|---|
| `MSG` / `ACK` | `MSG:ID:PAYLOAD` / `ACK:ID:OK` | 4 |
| `HB` | `HB:NODE_ID:UPTIME` | 5–6 |
| `RT` | `RT:SENDER:DEST1,HOPS1;DEST2,HOPS2;…` | 7–9 |
| `DATA` | `DATA:SRC:DEST:HOPS:MSG_ID:PAYLOAD` (TTL = MAX_HOPS 5) | 8–9 |
| `GPS` | `GPS:SRC:LAT:LON:BAT:UPTIME` | 10 |
| `TEXT` | `TEXT:SRC:DEST|ALL:MSG_ID:body` | 11 |
| `SOS` | `SOS:SRC:LAT:LON:MAYDAY text` (sent 3×) | 11 |

**Libraries actually used:** `LoRa` (Sandeep Mistry), `U8g2` (Node A / SH1106), `Adafruit_GFX`
+ `Adafruit_SSD1306` (Node B/C), `Wire`, `SPI`, ESP32 `HardwareSerial`. **No `WiFi.h`, no
`WebServer`, no `DNSServer`, no `TinyGPS++`, no crypto, no SPIFFS/LittleFS anywhere.**

---

## 2. Current Implementation Status

| Capability | Status | Notes |
|---|---|---|
| OLED bring-up (SH1106 + SSD1306, 3 platforms) | **Implemented & HW-tested** | Extensive commit history of real-device fixes |
| LoRa point-to-point @ 433 MHz | **Implemented & HW-tested** | Library-default PHY (SF7/BW125/CRC off/sync 0x12) |
| Two-way non-blocking messaging | **Implemented** (phase 3) | |
| Reliable MSG/ACK + retry + dedup | **Implemented** (phase 4 only) | **Not carried into phase 10/11** |
| Heartbeat + dead-node timeout | **Implemented** (phase 5–6 only) | Dropped after phase 6; phase 11 uses the TEXT beacon as a keepalive |
| Dynamic neighbor discovery | **Implemented** (phase 6) / **partial** (phase 10–11) | Phase 10–11 use a cut-down fixed `[5]`/`[3]` array |
| Distance-vector routing (`RT:`) | **Implemented** (phase 7–9 only) | Split-horizon *claimed* but *not* implemented |
| Multi-hop forwarding (`DATA:`) | **Implemented** (phase 8–9 only) | No duplicate/seen-ID cache on forward |
| Self-healing (invalidate + failover + recover) | **Implemented** (phase 9 only) | **Not in shipping firmware (phase 10/11)** |
| Real GPS NMEA parsing | **Implemented** (phase 10) | Hand-rolled `$GxRMC`/`$GxGGA`; **regressed** — phase 11 never reads GPS |
| GPS telemetry broadcast | **Implemented** (phase 10) | |
| TEXT messaging | **Partial / not real messaging** | DEST hardcoded `ALL`; body is auto-counter `"Rescue Active #n"`; no input path |
| Hardware SOS button + 3× broadcast | **Implemented** (phase 11) | Sends **hardcoded** coords; blocking; button has no edge detection |
| Full-screen SOS OLED takeover | **Implemented** (phase 11) | `sosAlertActive` **never clears** (permanent lockout) |
| Battery telemetry | **Stub** | `batteryLevel = 98/94/92` literals, never sampled |
| Wi-Fi AP / captive portal / web UI | **Not implemented** | Doc-only |
| Raspberry Pi gateway / dashboard | **Not started** | |
| Autonomous rover | **Not started** | |
| Encryption / binary protocol / DTN / sensors | **Not started** (listed as "advanced") | |

**Legend:** Implemented = code exists and was run on hardware; Partial = works but incomplete/degraded;
Not started = roadmap only.

---

## 3. Project Proposal Summary

**Title:** "Off-Grid LoRa-Based Self-Healing Mesh Communication Infrastructure, with an Autonomous
Rescue Rover for Emergency Search & Rescue Operations."

**Problem:** disasters destroy the cellular/power/internet infrastructure that rescue depends on;
the 24–72 h survival window is lost to poor coordination; rescuers must physically enter hazardous
structures to check for survivors; dedicated GPS fails indoors/under debris.

**Four integrated deliverables:**
1. **LoRa Mesh Nodes** — long-range, multi-hop forwarding, auto neighbor discovery, reliable
   ACK messaging, heartbeat monitoring, self-healing rerouting.
2. **Wi-Fi Captive Portal** — every capable node runs a SoftAP + captive portal; any smartphone
   browser (no app) registers a User/Team ID, shares phone GPS, raises SOS, sends short messages,
   files one-tap rescue reports (Victim Found / Medical / Blocked / Danger), updates team status.
3. **Autonomous Rover** — ESP32 + LoRa + 2WD/4WD chassis + L298N/TB6612 + HC-SR04 + GPS.
   Autonomous obstacle-avoidance exploration; **full mesh member**; **mobile LoRa relay** that
   physically repositions to bridge separated nodes.
4. **Raspberry Pi Command Center** — gateway ESP32 ↔ Pi over UART/USB; Python service; local DB
   (SQLite / InfluxDB); offline web dashboard with Leaflet/Mapbox map, node health, telemetry
   charts, prominent SOS alerts.

**Software stack (proposal):** Arduino/PlatformIO/C++; ESP32 SoftAP + HTTP + captive portal +
LoRa; Pi = Python + serial + local storage; web = HTML/CSS/JS; phone = Browser Geolocation API
with hybrid GPS fallback.

**Demonstrated-capabilities checklist (the de-facto rubric, slide 12):** long-range link,
multi-hop routing, auto discovery, reliable ACK messaging, heartbeat, self-healing, captive
portal, mobile GPS sharing, SOS alerts & reports, team status, autonomous rover run, mobile relay.

**Explicitly deferred to "Future Scope":** camera, thermal detection, gas/smoke, AI victim
detection, offline maps, drones, **encryption**, solar, real field trials. **No timeline, no
Gantt, no numeric grading rubric in the proposal.**

---

## 4. Proposal vs Current Implementation

| Proposal promise | Reality in code | Gap |
|---|---|---|
| Multi-hop mesh A→B→C | Exists in phase 8–9, **not** in shipping phase 10/11 | **Regression to re-integrate** |
| Self-healing rerouting | Exists in phase 9, **not** in phase 10/11 | Same |
| Reliable ACK messaging | Phase 4 only | Not in mesh firmware |
| Heartbeat monitoring | Phase 5–6 only | Replaced by ad-hoc TEXT beacon |
| Auto neighbor discovery | Full in phase 6; cut-down in phase 10–11 | Needs unifying |
| GPS position telemetry | Phase 10 works; phase 11 ignores GPS | **Wire GPS into SOS/telemetry** |
| SOS from button **and** portal | Button only; coords hardcoded; latch bug | Fix + add portal trigger |
| Wi-Fi captive portal, phone GPS, messages, reports, team status | **0 lines of code** | **Build from scratch** |
| Rover (autonomous + mobile relay) | **Nothing** | **Build from scratch** |
| Gateway ESP32 ↔ Pi ↔ dashboard, DB, map | **Nothing** | **Build from scratch** |
| "Split-horizon / distance-vector loop avoidance" | Claimed; only a partial count-to-infinity guard + timeout | Implement properly or reword claim |
| "Adaptive Data Rate SF7–SF12" | Not implemented; PHY never configured | Out of must-have scope; set a fixed sane PHY instead |
| LoRa on 3.3 V, "Do NOT use 5V" | Consistent in docs | OK |
| Uniform 3× ESP32 | Code still carries S3 + Nano variants in old phases | New code standardizes on 3× ESP32 |

**Missing requirements not yet anywhere:** message input mechanism; SOS acknowledgement/clear;
node persistence (IDs, last position) across reboot; any packet integrity check; a documented,
frozen packet spec; power/battery measurement; watchdog; field range test data.

---

## 5. Working Features (safe to demo today, from existing `phase N/` files)

- **Phase 1:** OLED (SH1106 + SSD1306) and LoRa SX1278 init on ESP32; LoRa TX (Node A) → RX with
  RSSI on OLED (Node B).
- **Phase 3:** bi-directional non-blocking `Hello` exchange, RSSI on OLED.
- **Phase 4:** `MSG:ID:payload` with automatic `ACK:ID`, 3 retries + backoff jitter, duplicate
  filtering, delivery-confirmed / delivery-failed states.
- **Phase 5:** `HB:` heartbeat every 5 s, target ONLINE/OFFLINE with 12 s timeout.
- **Phase 6:** neighbor table auto-populated from heartbeats; NEW / RECONNECTED / LOST events.
- **Phase 7:** `RT:` advertisements, routing table with hop counts, serial table printout.
- **Phase 8:** `DATA:` end-to-end with hop TTL; Node A → Node C via Node B.
- **Phase 9:** kill Node B → route invalidated → failover; restore Node B → route recovered.
- **Phase 10:** real GPS fix parsed from NEO-6M/M8N on Serial2; `GPS:` telemetry; "Searching
  Sats" fallback; OLED shows lat/lon/sats + connected-node list.
- **Phase 11 (partial):** press SOS button → 3× `SOS:` broadcast → **all in-range nodes** show a
  full-screen SOS screen with victim ID + coordinates; periodic `TEXT:` beacons keep the
  connected-node list alive.

---

## 6. Incomplete / Missing Features

**Partial:** phase-11 TEXT "messaging" (no way to type a message; DEST always ALL);
phase-11 SOS (hardcoded coords, blocking burst, latch); neighbor table in phase 10–11
(fixed size, no full-table handling); GPS validity check (`!= 0.0` rejects equator/meridian).

**Regressed (worked earlier, dropped later):** multi-hop routing, forwarding, self-healing,
real heartbeat, reliable ACK — none of these are in phase 10/11.

**Never started:** Wi-Fi SoftAP; DNS captive-portal redirect; HTTP server + portal pages;
Browser-Geolocation phone GPS; rescue reports; team status; gateway serial bridge; Pi Python
service; local DB; web dashboard + map; rover motor control; rover obstacle avoidance; rover
mesh membership; rover mobile-relay logic; persistence; packet CRC/auth; watchdog; battery ADC.

---

## 7. Problems / Bugs Found (verified in code)

**Critical:**
1. **`sosAlertActive` never resets** (`phase 11/Node A:125,232` + B + C). After the first SOS
   ever sent or received, the OLED is stuck on the SOS screen permanently and normal RX display
   is suppressed. No timeout, no button-to-clear.
2. **Startup-stagger integer underflow.** `lastBroadcastTime = millis() + random(0,2000)` sets
   the timestamp into the future; the unsigned guard `millis() - lastBroadcastTime > interval`
   underflows to a huge number → node transmits immediately on loop 1, defeating the anti-collision
   stagger. Present in `phase 11` A:194 / B:189 / C:191 and `phase 10` B:34 / C:34.
3. **Blocking `delay()` deafens the half-duplex radio.** `sendSosAlert()` blocks ~1.5 s
   (3× `delay(500)`), then `loop()` adds `delay(2000)` — ~3.5 s during which no incoming SOS/
   packet is received. Also setup ≈5 s of delays, `delay(50/100)` in button + forward paths.
4. **No multi-hop in shipping firmware** — the proposal's core promise is unmet by phase 10/11.

**High:**
5. `int msgId` is parsed but never used in phase 11 RX → **no duplicate filtering**; duplicate
   packets re-fire OLED writes; also a compiler warning.
6. `while(1);` hard-hang on LoRa init failure, **no watchdog** anywhere → frozen "safety" device.
7. **Pervasive `String`** — per-byte `incoming += (char)LoRa.read()`, `String` struct members,
   many concatenated temporaries every loop → ESP32 heap fragmentation over long runs; on the
   2 KB AVR Node C (old phases) likely instability (commit history shows repeated stabilization
   patches).
8. **SOS button:** level-triggered, no release/edge detection → holding it re-fires SOS +
   `delay(2000)` every ~2 s. Also GPIO 4 in code vs "BOOT / GPIO 0" in `Progress_Tracker.md`
   and the overview — doc/code mismatch.
9. **Weak RNG seed** `randomSeed(analogRead(0)+millis())` — GPIO0 is a strapping pin, near-constant;
   all three nodes seed alike → correlated jitter, partially defeating collision avoidance.
   (Phase 4 correctly used ADC1 `analogRead(34)`.)

**Medium:**
10. Split-horizon claimed but not implemented; count-to-infinity only bounded by `MAX_HOPS`+timeout.
11. `forwardPacket()` has no seen-ID cache → two nodes with a route both forward → duplicate storms.
12. LoRa PHY never configured: CRC **off**, default sync word `0x12` (collides with any nearby
    SX127x traffic), no explicit SF/BW/TX-power.
13. `Serial2.readStringUntil('\n')` blocks up to 1000 ms if GPS unplugged.
14. `parseNmeaCoord` assumes exactly 2 minutes-digits (`dotIdx-2`) and uses exact-float validity.
15. `LoRa.beginPacket()/endPacket()` return values never checked; TX failures invisible.
16. Severe **copy-paste duplication** — neighbor code in 6 files, NMEA parser byte-identical in 3,
    routing code across 3 phases × 3 nodes, `setup()` LoRa block ~20×. Bug fixes don't propagate;
    phase 10 vs 11 neighbor code has already diverged (15 s vs 30 s timeout, different prefix
    stripping).
17. Emoji strings (`"🚨 SOS EMERGENCY 🚨"`) won't render in the base bitmap fonts.
18. `X.md`, `abc.md` empty; `README.md` stale; typos in many filenames (`PLan.md`, `planing/`,
    `reciver`, `initizile`, `poposal`).

---

## 8. Feasibility Assessment

**Verdict: feasible and appropriately scoped for a Micro-controllers lab project — *if* the
system is rebuilt around one shared, non-blocking, tested code core instead of extending the
current copy-paste chain.** All four must-have capabilities are individually proven technology on
ESP32; the risk is integration and reliability, not possibility.

**Hardware feasibility — HIGH.**
- 3× ESP32 + SX1278 + OLED + GPS + button: standard, well-documented, all in hand. LoRa @ 433 MHz
  on 3.3 V is correct. SX1278 max payload 255 B >> our packets.
- ESP32 can run SoftAP + HTTP + captive portal **and** LoRa SPI **and** GPS UART concurrently —
  this is a common pattern (single core is enough at our packet rates). Wi-Fi + LoRa coexist fine
  (different radios); expect a small current bump — power banks cover it.
- Rover: ESP32 + L298N + 2 DC motors + HC-SR04 is the canonical beginner robotics build. Feasible.
  **Separate battery for motors vs logic is mandatory** (motor brown-outs reset the ESP32).
- Raspberry Pi reading a USB-serial ESP32 gateway and serving a Flask/FastAPI + Leaflet page is
  routine.

**Software feasibility — MEDIUM.** The mesh, GPS, and SOS logic already exist in pieces and
"work" in demos. Consolidating them into one non-blocking loop with a proper packet layer is
straightforward embedded work. The captive portal is new but is a solved pattern
(`WiFi.softAP` + `DNSServer` wildcard + `WebServer` with a catch-all handler). The Pi dashboard
is standard web work. **The rover autonomy is the least contained piece** and should stay
deliberately simple (bump-and-turn obstacle avoidance + manual/relay modes).

**Communication / network feasibility — MEDIUM.** LoRa is half-duplex, low-bandwidth
(~1–5 kbit/s effective at SF7–SF9) and **collision-prone with no MAC**. With 3 static nodes +
1 rover + gateway all beaconing, naive flooding will congest. Mitigations that must be in the
rebuild: single scheduled TX point per node, randomized jitter that actually works (fix bug #2),
a seen-ID cache to kill duplicate forwards, controlled beacon rate (heartbeat ≤ every 10–15 s),
CRC **on**, a private sync word, and short packets. This keeps airtime well under any sane duty
cycle for a lab demo. Realistic indoor/campus range at SF7: 100–300 m; multi-hop is what sells
the demo.

**Power / resource feasibility — MEDIUM-HIGH.** ESP32 + LoRa TX peaks ~120–160 mA; a 5 V power
bank runs a node for many hours — fine for a demo. Long-run heap health on ESP32 requires
dropping `String` from the hot path (fix #7). Node C staying on ESP32 (not the 2 KB Nano) removes
the worst resource risk — the new `development/` code targets **3× identical ESP32** only.

**Sensor / module compatibility — HIGH.** NEO-6M and NEO-M8N both emit standard NMEA at 9600 8N1;
the existing parser handles `$GP*` and `$GN*`. GPS needs **sky view / window** for first fix
(cold fix 30 s–several min) — bench demo needs the "no fix" fallback and ideally an antenna near
a window, or a recorded-NMEA replay mode for indoor rehearsal.

**Reliability — the main deliverable risk.** Current code fails a "leave it running for an hour
with 3 radios" test (latch bug, stagger bug, blocking SOS, heap). Phase 0 exists to prove/fix
exactly this before building upward.

**Real-world usability — adequate for a lab demo, not a field tool.** No encryption (proposal
already defers this), no duty-cycle enforcement, hand-carried nodes. That's an acceptable,
honestly-scoped academic prototype.

**Project complexity / time.** Four subsystems (mesh, portal, Pi, rover) + integration. With the
phased plan below, each phase is a self-contained, demoable checkpoint, so the project degrades
gracefully if time runs short: even stopping after Phase 4 yields an impressive mesh + SOS + GPS
+ captive-portal demo.

---
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
