sabrinasadiafaria/LoRa-WiFi-Mesh-Infrastructure/planing/Project poposal.pdf

# Off-Grid LoRa-Based Self-Healing Mesh

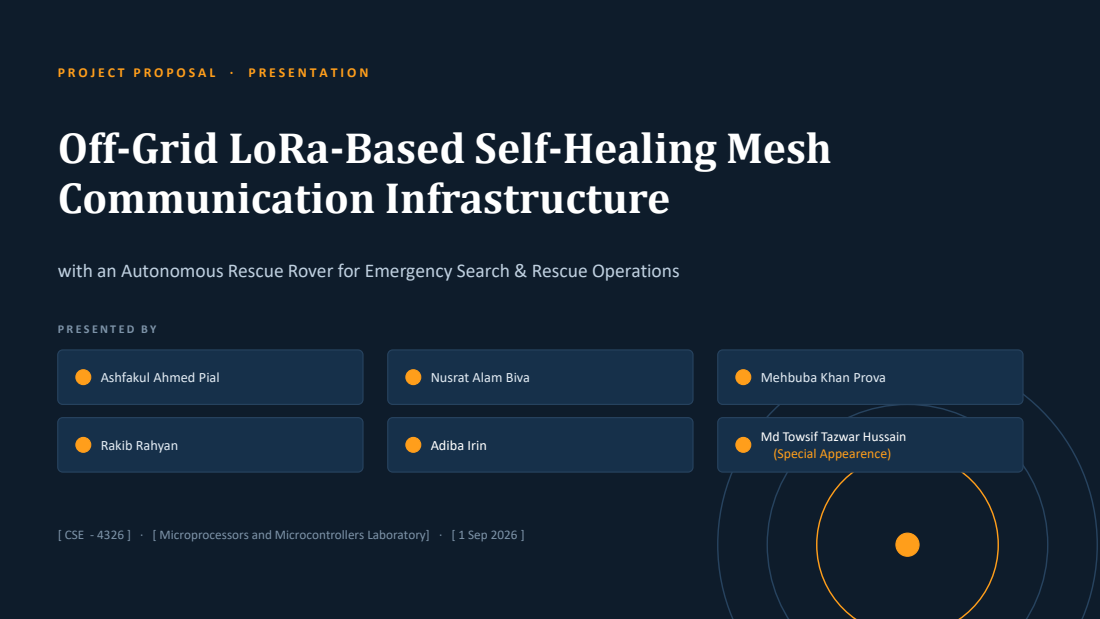
[picture p1: page 1]
Communication Infrastructure; Ashfakul Ahmed Pial; Nusrat Alam Biva; Mehbuba Khan Prova; Rakib Rahyan; Adiba Irin; Md Towsif Tazwar Hussain; (Special Appearence)

with an Autonomous Rescue Rover for Emergency Search & Rescue Operations

[ CSE - 4326 ] · [ Microprocessors and Microcontrollers Laboratory] · [ 1 Sep 2026 ]
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
