sabrinasadiafaria/LoRa-WiFi-Mesh-Infrastructure/phase 1/Node B oled test.md

#include <Wire.h>
#include <Adafruit_GFX.h>
#include <Adafruit_SSD1306.h>

#define SCREEN_WIDTH 128
#define SCREEN_HEIGHT 64

#define OLED_RESET -1
#define SCREEN_ADDRESS 0x3C

Adafruit_SSD1306 display(SCREEN_WIDTH, SCREEN_HEIGHT, &Wire, OLED_RESET);

void setup() {

  Serial.begin(115200);

  Wire.begin(21, 22);

  if (!display.begin(SSD1306_SWITCHCAPVCC, SCREEN_ADDRESS)) {
    Serial.println("OLED initialization failed!");
    while (true);
  }

  display.clearDisplay();

  display.setTextSize(2);
  display.setTextColor(SSD1306_WHITE);
  display.setCursor(15, 5);
  display.println("NODE B");

  display.setTextSize(1);
  display.setCursor(18, 35);
  display.println("OLED TEST");

  display.setCursor(10, 50);
  display.println("Status : OK");

  display.display();

  Serial.println("OLED Working!");
}

void loop() {

}
