sabrinasadiafaria/LoRa-WiFi-Mesh-Infrastructure/(commit log)

2026-07-21 Fix Phase 3 files to contain raw C++ code only for easy copy-paste into Arduino IDE
2026-07-21 Fix Phase 4 ACK timing and random backoff jitter to prevent packet collision
2026-07-21 Add Node C pin connection diagrams to Hardware_Connections.md
2026-07-21 Fix DIO0 pin conflict for ESP8266 Node C in Hardware_Connections.md
2026-07-21 Fix ESP8266 SPI.begin() argument count error in Node C Forwarding code
2026-07-21 Update ESP8266 OLED test with I2C scanner and 9600 baud rate
2026-07-22 Add Arduino Uno and Nano support for Node C hardware and forwarding code
2026-07-22 Add Arduino Nano OLED test code for Node C
2026-07-22 Fix Node C Phase 9 OLED initialization order and I2C fallback for Arduino Nano
2026-07-22 Add power stabilization delays to Node C Phase 9 OLED setup for Arduino Nano
2026-07-22 Update Hardware_Connections.md with complete GPS module pin connections
2026-07-22 Update Phase 11 code and Hardware_Connections.md with dedicated External SOS Push Buttons
2026-07-22 Fix RF packet collisions by implementing unified broadcast engine with randomized backoff jitter
2026-07-23 Add Project_Overview_And_Features.md and update Phase 10 GPS sketches & pinouts for 3x ESP32 setup
2026-07-23 Remove markdown headers from Phase 10 files for pure Arduino IDE copy-paste
2026-09-02 Add development/ scaffold: review plan, packet spec, Phase 0 test sheet
    Additive only - no existing phase N/ files touched. Sets up the folder
    structure, copies the approved review+feasibility+phase plan into
    docs/PLAN.md, drafts the versioned LoRa PACKET_SPEC v1 (CRC + seen-ID
    cache + framed format), and provides a fill-in bench-test sheet for
    Phase 0 (soak, multi-hop, GPS fix, collision loss, range, known-bug repro,
    WiFi/LoRa coexistence).
2026-09-02 Phase 1: shared non-blocking core firmware (radio + packet + OLED + neighbours)
    Adds development/phase 1/ - the foundation every later phase builds on.
    Node A/B/C now differ only by two #defines; all seven shared tabs are
    byte-identical, replacing the copy-paste duplication that had already let
    the old phase 10 and phase 11 neighbour code drift apart.
    Fixes carried in from the audit:
    - Interval::begin() moves the timer into the past, not the future - the old
    "lastBroadcastTime = millis() + jitter" underflowed the unsigned compare
    and made every node transmit immediately instead of staggering.
    - LoRa PHY set explicitly: CRC enabled and a private sync word (0x2A)
    instead of the library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
2026-09-02 Phase 1: restructure as complete standalone sketches per node
    Follows the project's established convention (root phase 10/ and phase 11/):
    one .md per node containing a whole program, pasteable straight into the
    Arduino IDE. Replaces the multi-tab shared-header layout, which required
    creating seven named tabs before a sketch would build.
    Node A (SH1106/U8g2), Node B and Node C (SSD1306/Adafruit) are the same
    program apart from MY_ID and the display driver. Node C is generated from
    Node B so the two cannot drift apart.
    Docs updated for the flat convention, including a warning that the tunable
    block is now repeated in all three files and must be kept in sync.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
2026-09-03 Phase 2: add reset-reason and low-water diagnostics to chase B/C reboots
    Node B and Node C restart unexpectedly while Node A stays up. The three
    sketches are byte-identical apart from the display driver (U8g2/SH1106 on A,
    Adafruit/SSD1306 on B and C), so the cause is either that path or the
    hardware itself. Rather than guess, make the node report it.
    - setup() now prints the decoded esp_reset_reason() carried over from the
    previous boot, so BROWNOUT (power) is distinguishable from TASK_WDT
    (something blocked the loop) and PANIC (a real crash).
    - the periodic [stat] line gains minheap= (lowest free heap ever seen, which
    catches a slow leak the instantaneous reading misses) and stack= (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
2026-09-03 Phase 3: fix Node B reboots and lost discovery
    Node B (the node with a phone on its portal) kept restarting while Node A
    (no phone) stayed up, and the nodes stopped finding each other. The three
    sketches are identical apart from the display driver, so the difference is
    load, not logic.
    Airtime and timing:
    - SF8 -> SF7. The measured link was -62..-71 dBm at SNR 10-13 dB and SF7
    needs about -7.5 dB, so there is roughly 18 dB of margin. SF7 halves the
    time each packet holds the channel, which matters now that Phase 3 added a
    third periodic broadcast on top of HB and GPS.
    - GPS telemetry 20s -> 30s, heartbeat 12s -> 10s, timeouts realigned to ~3
    missed packets.
    - Portal polling 3s -> 6s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
2026-09-03 Phase 3: fix the node hang - LoRa.endPacket() waits for TX_DONE forever
    Node B's TASK_WDT reset log identified the real cause. The synchronous
    LoRa.endPacket() spins inside the library on
    while ((readRegister(REG_IRQ_FLAGS) & IRQ_TX_DONE_MASK) == 0) yield();
    with no timeout. If the SX1278 never raises TX_DONE - a SPI glitch, or the
    3.3V rail dipping because the Wi-Fi AP transmitted at the same moment - that
    loop never returns, and yield() does not feed the task watchdog. Node B had a
    phone associated so its Wi-Fi was actively transmitting; Node A did not. Same
    code, different load, which is why only B died.
    Transmission is now asynchronous and bounded: endPacket(true) returns at once,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
2026-09-03 Phase 3: fix compile errors - private isTransmitting(), deleted reset helpers
    Three build failures on ESP32 core 3.3.7:
    1. LoRa::isTransmitting() is private in the library, so the async TX poll did
    not compile. Bound the transmit by time instead: after endPacket(true) we
    wait TX_AIRTIME_MS (500ms, comfortably longer than a full-size frame at
    SF7) and then call LoRa.receive(), which forces the radio out of TX. If the
    transmit finished normally that is the usual return to RX; if the radio
    wedged, that is what recovers it. beginPacket() already returns 0 when the
    radio still thinks it is transmitting, so that public check covers the
    overlap case and increments txstuck. TX_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
2026-09-03 Phase 4: SOS alerts, rescue reports, team status
    Adds development/phase 4/ - three complete standalone sketches building on the
    Phase 3 multi-hop core.
    SOS: hardware button (GPIO 4, edge-detected), portal button, or serial 'S'.
    Broadcasts the node's real position from locBest() as a non-blocking 3x burst
    forwarded across the whole mesh. Every node in range shows a full-screen
    takeover that clears itself after 60s or on a button press. SOSACK replies
    flow back so the victim's screen shows "heard by: B,C".
    Every bug from the old root phase 11 SOS code is fixed rather than carried:
    - the alert screen now clears (old code set sosAlertActive=true and never
    reset it)
    - coordinates are real, or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
2026-09-03 Phase 4: fix radio deafness - stop mixing LoRa.receive() with parsePacket()
    "SOS works but then every node loses every neighbour ~30s later." The log
    showed rx frozen while tx kept climbing and rst still POWERON - the receiver
    was wedged, not the loop.
    Root cause: the sketch drove the SX1278 with two incompatible library APIs at
    once. LoRa.receive() sets RX_CONTINUOUS; parsePacket() with no size argument
    forces RX_SINGLE whenever it finds nothing. Calling receive() after every TX
    and also polling parsePacket() made the two fight, and once an async
    endPacket(true) added a stale TX_DONE flag the radio settled in STANDBY and
    went permanently deaf. An SOS burst - three nodes transmitting copies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
2026-09-03 Phase 4: fix lost nodes not reconnecting - dedup only forwarded packets
    A rebooted node restarts msgId at 1. Peers' 32-entry seen-ring still held its
    old (src, 1..N), so its fresh heartbeats were dropped as duplicates for
    minutes and the node stayed LOST until the ring cycled.
    Duplicate suppression now applies only to the packet types we actually
    forward (DATA, SOS, SOSACK, RPT). HB / RT / GPS / STAT are broadcast, never
    relayed, and idempotent, so they skip the seen-ring and a rebooted node is
    rediscovered on its next heartbeat.
2026-09-03 Phase 5: Raspberry Pi command centre (Pi as a mesh node) + web dashboard
    The Pi joins the mesh as node "PI" with its own SX1278 - no USB gateway. It
    speaks the identical wire protocol, sends HB/RT so the mesh routes to it, and
    relays traffic like any node. Nodes reach it directly or multi-hop
    (C -> B -> A -> PI) and it reaches them the same way in reverse.
    pi/ (Python, runs on the Pi):
    sx1278.py - minimal register-explicit SX1278 SPI driver, PHY hard-matched
    to the nodes (433MHz SF7 BW125 CR4/5 CRC-on sync-0x2A pre-8)
    mesh.py - the Pi as a mesh node: framing, distance-vector routing with
    split horizon, multi-hop forward, seen-cache, route e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
    [db.py, main.py, mesh.py, sx1278.py]
2026-09-04 Phase 6: reliability + GPS - fix nodes randomly dropping and failing to rejoin
    Three problems reported once the Pi joined the mesh: nodes randomly got lost
    (any of A/B/C, no pattern), a lost node could not rejoin, and the GPS "should
    work properly".
    1. RANDOM LOSS - RX duty cycle, not RF.
    parsePacket() arms the SX1278 in RX_SINGLE: it listens ~100ms then drops to
    STANDBY until the next poll, so the radio only hears while loop() keeps
    calling it. The worst stall was drawUI() - a 1KB frame over I2C at the ESP32
    default 100kHz is ~100ms with the loop blocked, every second - plus ~10ms of
    Serial per received packet. The radio could be listening barely half the time.
    - Wire.setClock(400000)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
    [db.py, main.py, mesh.py, sx1278.py]
2026-09-04 Fix critical oledPush recursion bug; consolidate Pi code; fix GPIO25 leak
    CRITICAL FIX - nodes rebooting, not rejoining, OLED stuck:
    oledPush() (added in Phase 6 to skip redundant redraws) had a copy-paste
    defect: its body called itself instead of drawing.
    void oledPush(char l[5][26]) {
    ...
    oledPush(l); // should have been oledClear(); ...; oledShow();
    }
    Any OLED content change - which is most seconds, since the uptime counter
    alone changes every second - recursed until the stack overflowed and the
    node crashed. It then rebooted (watchdog or a stack-guard trap) with the
    display stuck on whatever was on it before the crash. A node stuck in a
    reboot loop is also off the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
    [db.py, main.py, mesh.py, sx1278.py]
2026-09-04 Phase 6: radio-health watchdog for random disconnects + manual rescan button
    "Nodes get disconnected randomly; power-cycling the node fixes it, but
    that's not the solution." The phrasing is the diagnosis: only a hardware
    reset was clearing whatever state the SX1278 got into, which meant the
    node's own firmware could never tell the difference between "radio dead"
    and "radio fine, nobody nearby" - radioOk is set true once in radioBegin()
    at boot and was never set back to false at runtime, so the one existing
    recovery path (retry on !radioOk) could never fire after boot no matter how
    wedged the chip got.
    Added a radio-health watchdog that does in software what the power cycle
    was doing in hard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
2026-09-04 Phase 6: fix Node A hanging entirely - I2C timeout, saner clock, less redraw churn
    Report: pressing the portal's rescan button did nothing for minutes, Node
    A's OLED was frozen, then everything recovered after some time. That is
    worse than a radio-only wedge - if only the radio had stopped, the OLED
    would keep updating (drawing doesn't touch the radio) and the portal would
    keep responding (WebServer doesn't touch the radio either). Both freezing
    together means loop() itself stopped running, which also explains why the
    watchdog from the previous revision didn't help: it lives inside loop(), so
    it cannot run if loop() isn't running.
    Root cause: the ESP32 Wire library has no timeout by default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
2026-09-07 Phase 7: fix outdoor range (SF9 + computed airtime), GPS buffer, new OLED + portal UI
    Nodes would not link up in open space and the GPS looked dead. Two real bugs
    plus a redesign of both user interfaces.
    BUG 1 - the spreading factor was tuned on a desk, not in a field.
    LORA_SF was set to 7 in Phase 3 from bench measurements taken with the nodes
    about 2m apart (RSSI -62..-71 dBm). SF7 has the worst sensitivity of the
    usable settings at -123 dBm; outdoors at distance that margin is gone, which
    is exactly what "A cannot reach B or C in an open place" looks like. Now SF9
    (-129 dBm) - 6 dB better, roughly double the range. Beacon rates slowed to
    pay for the longer airtime (HB 15s, RT 30s, GPS 45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
    [mesh.py, sx1278.py]
2026-09-07 Phase 7: fix portal not compiling - drop raw string literals
    The Arduino IDE's sketch preprocessor does not understand C++11 raw string
    literals and tracks quotes naively. Phase 7's new esc() helper contained a
    lone " inside the JS regex /[&<>"]/g, which flipped the preprocessor's quote
    parity so it never saw )HTML" as the terminator - the compiler then parsed
    ~290 lines of HTML/CSS/JS as C++.
    - esc() now escapes & < > only (it is only ever used on text nodes, never in
    an attribute), so it contains no quote character.
    - PORTAL_HTML is now conventional adjacent string literals with escaped
    quotes instead of R"HTML(...)HTML". Content verified byte-identical by
    reconstructing it from the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
2026-09-07 Phase 7: fix mesh congestion meltdown + cut board heat
    Nodes lost each other and could not reach the Pi after flashing Phase 7.
    Root cause was not range - it was an unbounded feedback loop that SF9's
    3x airtime finally made fatal.
    anyNeighborMissing() is true for as long as ANY previously-seen node is
    absent, and sendHeartbeat() used it to switch to a 6 s beacon with nothing
    bounding it. At SF7 that was ~1.9% duty per node; at SF9 ~5.5%. Three nodes
    plus the Pi pushed the channel past ~50% occupancy, and it self-reinforces:
    lose a peer -> beacon faster -> collide more -> lose more peers. Once tipped
    it never recovers, which is why only a power cycle helped (a fresh boot knows
    no peers, so t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
    [sx1278.py]
2026-09-07 Phase 7: revert LORA_SF to 7 and add PHY-mismatch diagnostics
    Nothing connected to anything after the SF8 build - no node to node, no node
    to Pi. That is not congestion (which degrades a mesh unevenly); a clean total
    failure across every pair at once is the signature of a PHY mismatch, and the
    PHY is what I changed. Two SF changes were made in Phase 7 (7->9, then 9->8)
    and the mesh got worse both times.
    - LORA_SF back to 7, the value phases 3-6 ran and linked up reliably on this
    hardware. pi/sx1278.py set to SF = 7 to match.
    - CPU_MHZ back to the stock 240. Dropping it to 80 is a real heat fix but it
    landed in the same commit as the SF change; re-apply it once the mesh is
    confirmed li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
    [main.py, sx1278.py]
2026-09-09 Phase 8: port the rover to ESP32-S3 and fix four rover bugs
    The rover moves to an ESP32-S3 (nodes A/B/C stay on the classic ESP32) with
    an L298N driving four 6V 100RPM BO gear motors and the HC-SR04 on a panning
    servo. Almost none of the old pin map survives the chip change: GPIO 22-25 do
    not exist on the S3, 26-32 are the flash/PSRAM SPI bus, 33-37 are octal PSRAM
    on the usual modules, there are no input-only pins, and ADC1 is GPIO 1-10
    only. Every pin is reassigned from the safe set 1-18, 21, 39-42, 47, and the
    README carries the full component-by-component wiring table.
    Four real defects found reviewing the rover logic, two of them safety issues:
    - A dead or unplugged ultrasonic read as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
2026-09-20 Phase 9: Pi dashboard redesign + user-friendly captive portal + bug fixes
    Dashboard rewrite (index.html / style.css / app.js):
    - 4-panel 2x2 layout matching the provided design (map, telemetry,
    recent activity, team status) with a top status bar and a sliding
    rover floating panel.
    - Top status bar shows mesh active/total, SOS count, last-update
    time, link state and clock. Red SOS banner sits above the bar
    while an uncleared SOS is in the mesh.
    - Rover panel: mode + obstacle range + battery pills; D-pad that
    pulse-sends verbs while held; MODE toggles for MANUAL / AUTO /
    RELAY (dead-man-switch semantics - dashboard must keep POSTing
    to keep the rover moving).
    - Dark theme, respon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
    [db.py, main.py, mesh.py]
2026-09-20 Phase 9: integration + tuning + range test (docs only)
    No firmware or Pi changes. The phase 9 deliverable is the playbook and
    the empty templates, so a real hardware run can fill them in.
    development/phase 9/
    - README.md: phase goal, what is in scope (one gate = 3 consecutive
    end-to-end runs of docs/DEMO_SCRIPT.md), what is NOT in scope (no new
    features, no refactor, no protocol change), completion criteria,
    carry-over to phase 10.
    - TEMPLATES/heap_log_template.csv: per-node heap + loop-max + watchdog
    resets, one row per minute during soak.
    - TEMPLATES/rssi_table_template.csv: distance + obstacle + RSSI/SNR/
    loss for outdoor range test, with worked example row at SF7.
    - TEMPLATES/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
    [dedup_log_template.csv, heap_log_template.csv, rssi_table_template.csv]
2026-09-20 Phase 9: add integrated code drop (4 nodes + Pi) under phase 9/
    phase 9/ was previously docs-only (test report template, tuning playbook).
    The user asked for the same shape as the other phase folders: a complete
    folder that can be flashed and run end-to-end without reading the
    earlier phases.
    Added under phase 9/:
    - Node A.md (classic ESP32 + portal + GPS + SOS)
    - Node B.md (classic ESP32 mesh relay)
    - Node C.md (classic ESP32 + portal + GPS + SOS)
    - Node Rover.md (ESP32-S3 + motors + ultrasonic + GPS + E-STOP)
    - pi/ (main.py, server.py, db.py, mesh.py, sx1278.py,
    fake_radio.py, requirements.txt, sar-pi.service,
    .gitignore, README.md, dashboard/{index,p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
2026-09-20 Pi: add one-shot install + day-to-day update scripts
    The global development/pi/ folder is what runs on the gateway Pi.
    Until now the user had to edit sar-pi.service by hand to fill in the
    right User= and paths, and there was no scripted "git pull + restart"
    workflow. This commit adds the two scripts that make the folder
    pull-and-go on a fresh Pi.
    development/pi/install.sh (new)
    Idempotent one-shot setup. Steps:
    1. create venv/ and pip install requirements.txt
    2. on a Pi: install python3-lgpio if missing, warn if SPI is off in
    /boot/firmware/config.txt, add the current user to the spi group
    3. (default) render sar-pi.service into /etc/systemd/system/ with
    User= an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
2026-09-20 Phase 10: ship the demo + architecture + wiring + limitations + final report
    Five top-level docs that turn the codebase into something a reviewer
    can reproduce from a fresh checkout.
    development/docs/DEMO_SCRIPT.md (was a stub)
    12-15 minute live walkthrough mapped to the proposal's twelve
    "demonstrated capabilities". Each step has a visible cue, a
    spoken line, and a timing budget. Five parts: network, rescue
    app, resilience, rover, limitations. Closes with a mapping table
    back to the proposal slide and a pre-demo checklist.
    development/docs/ARCHITECTURE.md (was a stub)
    Four-box system diagram + seven-layer model (radio / packet /
    mesh / GPS / app / ui / portal) with per-layer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
2026-09-20 Phase 10: rewrite development/README.md, add tracker, point root README
    Three index-level changes that go with the Phase 10 doc drop.
    development/README.md (rewritten)
    Was a folder guide. Now a "start here" doc:
    - "If you have never seen this project, read these three files
    in order" section with FINAL_REPORT -> DEMO_SCRIPT ->
    ARCHITECTURE
    - "If you are about to build the demo" section with WIRING +
    pi/DEPLOY
    - "If you are about to run the integration test" section with
    phase 9/README + TEST_REPORT + TUNING
    - layout tree, conventions, build order, status table, "where to
    look for things" lookup table
    Status table updated: Phase 8 stays green (bench-tested by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
2026-09-20 Pi: priority TX queue + slimmer HB/RT to fix the laggy-messaging feel
    The dashboard was already throttle-throttling manual drive to one CMD every
    400 ms, but a held button still stalled behind a routine HB on the Pi side
    because the TX queue was plain FIFO and _last_tx += random(0, 0.2) added
    the same anti-collision jitter to every packet (priority or not).
    Three changes:
    development/pi/mesh.py
    * _enqueue() now takes a priority. TX queue is sorted by priority in
    _service_tx(), so a burst of CMD:RPT always overtakes a routine HB/RT.
    * Priorities: PRI_CMD (drive/mode/goto/where/ping/sos/sosclr), PRI_SOS,
    PRI_RPT, PRI_DATA, PRI_FWD (forwarded packets), PRI_PERIODIC (HB/RT).
    * TX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
    [mesh.py]
2026-09-20 Rover: AUTO_GPS + GOTO/GOCLR + dashboard 'send rover to address'
    The Pi can now send the rover to a target GPS coordinate. The operator
    types lat/lon in the dashboard's rover panel, or clicks the map to drop
    a pin, and presses Go. The rover re-aims toward the target every 2.5 s,
    backs off obstacles with the same look-then-turn routine used by plain
    AUTO, and arrives at the destination within AUTO_GPS_ARRIVE_M (2 m).
    Rover (phase 8/Node Rover.md, mirrored into phase 9/Node Rover.md):
    * New mode ROVER_AUTOG (3) entered only by CMD:GOTO. 'm'-cycling on
    serial still cycles MANUAL -> AUTO -> RELAY (no AUTO_GPS in the
    button cycle - too easy to land on it by accident).
    * New state mac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
2026-09-20 Rover: fix compile errors in AUTO_GPS SCAN state
    The new RG_SCAN state in autoGpsService() called two functions that
    don't exist in this codebase:
    servoSetAngle(deg) - real function is servoWrite(deg) (plain AUTO
    uses it for the same look-around sequence)
    SCAN_READ_DELAY_MS - plain AUTO uses a single SERVO_SETTLE_MS gate
    before each read; there is no per-step read
    delay
    Fix: rewrite the SCAN state to mirror plain AUTO's three-step pattern
    (servoWrite(LEFT/CENTER/RIGHT) with SERVO_SETTLE_MS between reads),
    drop the unused `otherSideCm` local while I was there.
    Brace balance still 374/374. No other identifier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
2026-09-25 Fix Pi mesh connection bugs and GPS portal TLS timeout
    - Pi: Fix mesh.py RPT payload indexing (team/lat/lon mismatch)
    - Pi: Fix mesh.py RT broadcast to use 3-field format (hop counts) so Nodes parse it correctly
    - Nodes A/B/C: Fix SecureGpsPortal.h ERR_CONNECTION_RESET by running on Core 0 at default priority
    - Rover: Revert to Phase 9 hardware config to remove invalid DHT11/MQ-2 pins
    [mesh.py]
2026-09-25 Fix captive portal caching issue by adding HTTP cache-busting headers
    [Node_A.ino, Node_B.ino, Node_C.ino]
2026-09-25 Goal fixes: LORA_SF=9, Pi Watchdog, Broadcast Messages UI, Buzzer fixes
    [Node_A.ino, Node_B.ino, Node_C.ino, Node_Rover.ino, mesh.py, sx1278.py]
2026-09-25 Fix Pi mesh.py broadcast message rendering
    [mesh.py]
2026-09-25 Fix SF7 mesh stability, OLED custom messages page added
    [Node_A.ino, Node_B.ino, Node_C.ino, Node_Rover.ino, sx1278.py]
2026-09-27 Add app 2.0 with Fused Location Provider
2026-09-27 Fix messaging system: broadcast routing and UI notifications
    [Node_A.ino, Node_B.ino, Node_C.ino, db.py, main.py, mesh.py, sx1278.py]
2026-09-28 feat(rover): add DHT11 and MQ2 environment sensors to rover, mesh, and dashboard
2026-10-03 Update Rover with DHT11 and MQ2, fix Pi dashboard and DB for sensors
    [Node_Rover.ino, db.py]
2026-10-03 Fix bootloop by removing MQ2 D0 from strapping pin 3
    [Node_Rover.ino]
2026-10-03 Fix dashboard undefined sensor values and CSS wrap
2026-10-04 Fix Pi mesh loop DDOS and SQLite lock contention
    [db.py]
2026-10-04 Fix SQLite ALTER TABLE silent failure that drops rover columns
    [db.py]
2026-10-04 Revert WAL mode and UI debounce to match old style architecture
    [db.py]
2026-10-04 Reduce LORA_TXPOWER to 7dBm to fix close-range saturation (OLED showing -110)
    [Node_A.ino, Node_B.ino, Node_C.ino, Node_Rover.ino, sx1278.py]
2026-10-04 Update DHT pin to 2 for Rover and add new nodes folder
